Sam-Indyk/uatxcavators-tbm/fusion/UATXSync/resources/export/64x64@2x.png

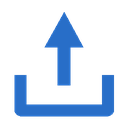
fusion/UATXSync/resources/export/64x64@2x.png
