Sam-Indyk/uatxcavators-tbm/fusion/UATXSync/resources/status/64x64@2x.png

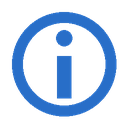
fusion/UATXSync/resources/status/64x64@2x.png
