Sam-Indyk/uatxcavators-tbm/fusion/UATXSync/resources/sync/64x64@2x.png

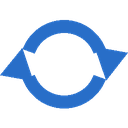
fusion/UATXSync/resources/sync/64x64@2x.png
