Sam-Indyk/uatxcavators-tbm/fusion/UATXSync/resources/toggle/64x64@2x.png

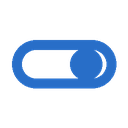
fusion/UATXSync/resources/toggle/64x64@2x.png
