Sam-Indyk/uatxcavators-tbm/out/fea/ring1_LC2_facewelded_R245_cb384x30_p76.2x63.5.png

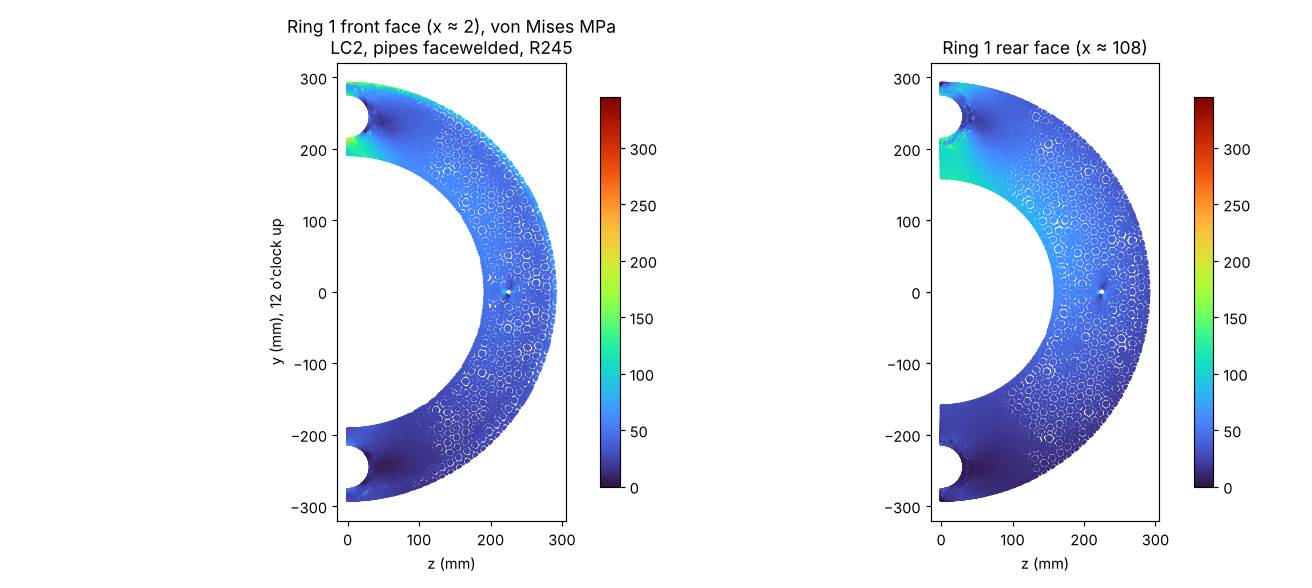
out/fea/ring1_LC2_facewelded_R245_cb384x30_p76.2x63.5.png
