Sam-Indyk/uatxcavators-tbm/out/fea/studies/tring_LC2_notch_casing.png

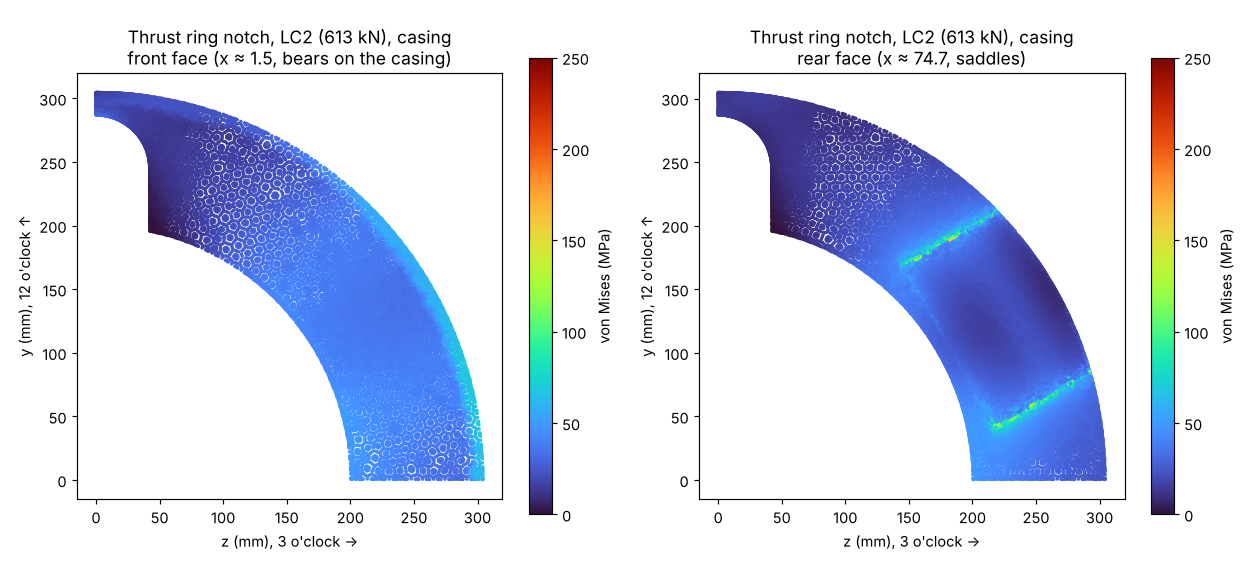
out/fea/studies/tring_LC2_notch_casing.png
