Sam-Indyk/uatxcavators-tbm/viewer/fea/ring1_LC2_facewelded_R245_cb384x30_p76.2x63.5_rear.png

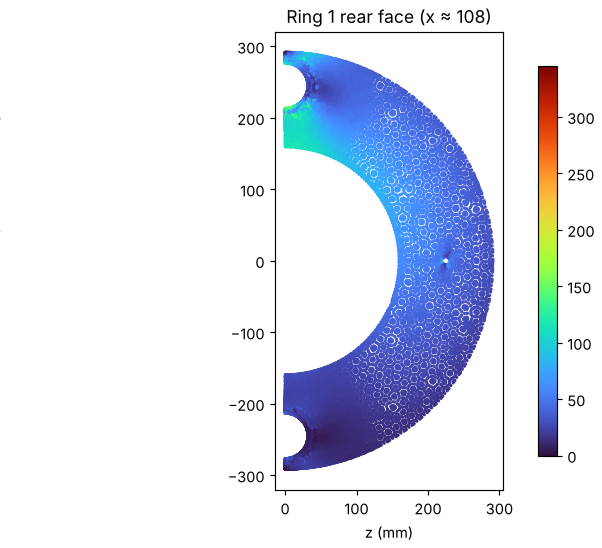
viewer/fea/ring1_LC2_facewelded_R245_cb384x30_p76.2x63.5_rear.png
