Sam-Indyk/uatxcavators-tbm/viewer/fea/tring_LC2_reg_casing_front.png

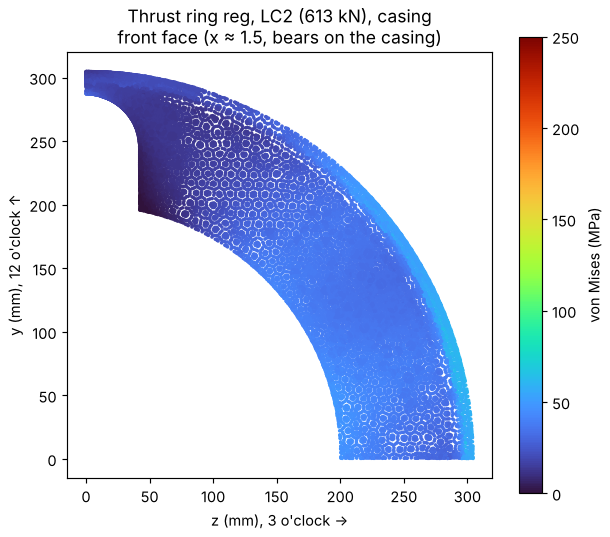
viewer/fea/tring_LC2_reg_casing_front.png
