Sam-Indyk/uatxcavators-tbm/docs/manual-09-bom.md

# Design manual Rev I · 09 Bill of materials

UATXcavators DN600 slurry microTBM (micro tunnel boring machine). Revision I, 2026-10-28. Generated by `tools/make_manual.py` from the model and calculation scripts in the repo; edit those, not this file.

Units mm, N, MPa (kN, kNm in tables). x = 0 at the ring 1 front face, +x rearward. Clock positions are seen from the front, looking rearward: 0° = 12 o'clock, 90° = 3 o'clock.

Every part in the Rev I model. Mass is the modelled total for the line (motor and cylinders at catalogue mass). Quantity '–' marks a line that is part of the item above it (bearing rings, seal lips, screws supplied with a locking assembly).

| # | Key | Group | Part | Qty | Material / supplier part | kg (line) | Make / buy |
|---|---|---|---|---|---|---|---|
| 1 | shell | Shell weldment | Shield shell Ø609.6 × 12.7 × 1285, rear Ø590.6 × 12 counterbore | 1 | 24 in × 0.500 in pipe, API 5L B / A53 B | 238.55 | make |
| 2 | ring1 | Shell weldment | Ring 1, 110 thk A572 Gr 42, Ø384 × 30 counterbore | 1 | A572 Gr 42, 4.5 in plate | 144.70 | make |
| 3 | weld | Shell weldment | Ring 1 weld, 14 mm fillet from the front | 1 | E7018 | 1.39 | weld |
| 4 | pipes | Shell weldment | Slurry pipes Ø76.2 × 6.35, 12 + 6, x = 0 to 1,255 | 2 | A1085 HSS 3.000 × 0.250 in | 27.46 | make |
| 5 | pipewelds | Shell weldment | Pipe welds: 6 × 45° front seal weld + 6 mm rear fillet | 4 | E7018 | 0.15 | weld |
| 6 | saddles | Shell weldment | Pipe saddles | 2 | A572 Gr 50 | 0.26 | make |
| 7 | taps | Shell weldment | Pressure-tap tubes, flush | 2 | Ø12 × 2 steel tube | 0.12 | make |
| 8 | fin30 | Shell weldment | Anti-roll fin 20 × 70 × 990 at 30° | 1 | A572 Gr 50, 20 plate | 9.81 | make |
| 9 | fin90 | Shell weldment | Anti-roll fin 20 × 70 × 990 at 90° | 1 | A572 Gr 50, 20 plate | 9.81 | make |
| 10 | fin270 | Shell weldment | Anti-roll fin 20 × 70 × 990 at 270° | 1 | A572 Gr 50, 20 plate | 9.81 | make |
| 11 | fin330 | Shell weldment | Anti-roll fin 20 × 70 × 990 at 330° | 1 | A572 Gr 50, 20 plate | 9.81 | make |
| 12 | finwelds | Shell weldment | Fin welds, 2 × 8 mm fillets | 8 | E7018 | 1.94 | weld |
| 13 | liftboss | Shell weldment | Lifting bosses ×4, Ø60 × 40, M20 (hoist rings) | 4 | A572 Gr 50 or 1018 bar Ø60 | 3.31 | make |
| 14 | liftplug | Shell weldment | Lifting-boss plugs ×4, M20 set screws | 4 | M20 set screw | 0.14 | buy |
| 15 | legs | Fixture | Gauge legs ×3, 1157 (fixture) | 3 | Tube Ø30, ground ends | 19.26 | fixture |
| 16 | risers | Fixture | Riser blocks ×3, 110 (fixture) | 3 | Steel block 60 × 60 | 9.33 | fixture |
| 17 | tube | Bearing module | Cartridge tube, seamless 323.9 × 60 | 1 | Seamless tube 323.9 × 60 E355 | 147.23 | make |
| 18 | halfA | Bearing module | Split flange half A | 1 | A572 Gr 50, 1.5 in plate | 4.03 | make |
| 19 | halfB | Bearing module | Split flange half B | 1 | A572 Gr 50, 1.5 in plate | 4.27 | make |
| 20 | splitscrews | Bearing module | Split-joint screws 2 × M8 | 2 | ISO 4762 M8 × 40 10.9 | 0.05 | buy |
| 21 | pin45 | Bearing module | Anti-rotation pin Ø12 at 45° | 1 | ISO 8734 Ø12 hardened | 0.04 | buy |
| 22 | pin135 | Bearing module | Anti-rotation pin Ø12 at 135° | 1 | ISO 8734 Ø12 hardened | 0.04 | buy |
| 23 | pin225 | Bearing module | Anti-rotation pin Ø12 at 225° | 1 | ISO 8734 Ø12 hardened | 0.04 | buy |
| 24 | pin315 | Bearing module | Anti-rotation pin Ø12 at 315° | 1 | ISO 8734 Ø12 hardened | 0.04 | buy |
| 25 | oring | Bearing module | Static O-ring on tube | 1 | NBR O-ring | 0.18 | buy |
| 26 | purge | Bearing module | Seal-purge line Ø8 in OD groove | 1 | Ø8 steel tube | 0.18 | make |
| 27 | purgefit | Bearing module | Purge line fittings (low profile) | 2 | Low-profile fittings | 0.02 | buy |
| 28 | flscrews | Bearing module | Flange screws 16 × M12 × 40 10.9 | 16 | ISO 4762 M12 × 40 10.9 | 0.87 | buy |
| 29 | fldowels | Bearing module | Dowels 2 × Ø16, flange to ring 1 | 2 | ISO 8734 Ø16 × 50 | 0.16 | buy |
| 30 | carrier | Bearing module | Seal carrier | 1 | S355 / 1045 | 9.88 | make |
| 31 | sealcase | Bearing module | Lip seals 170 × 200 × 15 ×3: steel case | 3 | SKF 170 × 200 × 15 | 0.86 | buy |
| 32 | seallip | Bearing module | Lip seals: NBR lips | – | (part of the seals) | 0.22 | – |
| 33 | sealspring | Bearing module | Lip seals: garter springs | – | (part of the seals) | 0.07 | – |
| 34 | lantern | Bearing module | Lantern rings ×2 | 2 | Steel | 0.87 | make |
| 35 | shim | Bearing module | Carrier shims | 1 | Shim set | 0.04 | make |
| 36 | carscrews | Bearing module | Carrier screws 12 × M6 countersunk | 12 | ISO 10642 M6 × 22 | 0.07 | buy |
| 37 | hw | Bearing module | 29328N housing washer | – | (29328N) | 3.15 | – |
| 38 | shaft | Bearing module | Spindle Ø140, 4140 QT | 1 | 4140 QT | 100.67 | make |
| 39 | f_ir | Bearing module | Front 23228: inner ring | 1 | 23228 CC/W33 (Koyo) | 4.78 | buy |
| 40 | f_or | Bearing module | Front 23228: outer ring | – | (23228) | 7.29 | – |
| 41 | f_rol | Bearing module | Front 23228: rollers 2 × 19 | – | (23228) | 4.04 | – |
| 42 | f_cage | Bearing module | Front 23228: cage rings + guide ring | – | (23228) | 0.61 | – |
| 43 | backing | Bearing module | Backing ring Ø190 | 1 | 4140 | 1.52 | make |
| 44 | sw | Bearing module | 29328N shaft washer | 1 | 29328N (Koyo) | 4.59 | buy |
| 45 | t_rol | Bearing module | 29328N rollers ×24 | – | (29328N) | 1.04 | – |
| 46 | spacer | Bearing module | Spacer sleeve | 1 | S355 | 9.01 | make |
| 47 | r_ir | Bearing module | Rear 23228: inner ring | 1 | 23228 CC/W33 (Koyo) | 4.78 | buy |
| 48 | r_or | Bearing module | Rear 23228: outer ring | – | (23228) | 7.29 | – |
| 49 | r_rol | Bearing module | Rear 23228: rollers 2 × 19 | – | (23228) | 4.04 | – |
| 50 | r_cage | Bearing module | Rear 23228: cage rings + guide ring | – | (23228) | 0.61 | – |
| 51 | mb | Bearing module | MB28 lock washer | 1 | SKF MB28 | 0.16 | buy |
| 52 | nut | Bearing module | KM28 lock nut | 1 | SKF KM28 | 2.46 | buy |
| 53 | eye | Fixture | M30 eye bolt in spindle nose (fixture) | 1 | DIN 580 M30 eye bolt | 1.07 | fixture |
| 54 | spider | Cutterhead | Spider plate 50.8, one waterjet piece | 1 | A572 Gr 50, 2 in plate | 47.84 | make |
| 55 | gussets | Cutterhead | Gussets ×8, 25 thk, tab-and-slot | 8 | A572 Gr 50, 1 in plate | 22.35 | make |
| 56 | hubring | Cutterhead | LA hub ring Ø340 × Ø190 × 50.8 | 1 | A572 Gr 50, 2 in plate | 24.51 | make |
| 57 | sleeve | Cutterhead | Journal sleeve Ø170 + labyrinth rings | 1 | 4140 prehardened bar Ø255 | 24.92 | make |
| 58 | headwelds | Cutterhead | Head welds (12 mm gusset-to-arm, 8 mm hub) | 1 | E7018 | 2.00 | weld |
| 59 | holders | Cutterhead | Bit holders ×17 (spider), 30 × 24 × 20 | 17 | Steel holder 30 × 24 × 20 | 1.90 | make |
| 60 | carbide | Cutterhead | Carbide drag bits ×17 (spider) | 17 | Carbide drag bit (Daniel's spec) | 0.71 | buy |
| 61 | la | Cutterhead | Locking assembly 140 × 190 × 50 | 1 | Fenner B-LOC B400 140 × 190 (B401140) | 4.53 | buy |
| 62 | lascrews | Cutterhead | Locking assembly screws 12 × M12 | – | (with the locking assembly) | 0.60 | – |
| 63 | cap | Cutterhead | Centre cap 30 thk + cone | 1 | A572 Gr 50, 1.25 in plate | 12.50 | make |
| 64 | capholders | Cutterhead | Bit holders ×7 (cap) | 7 | Steel holder | 0.78 | make |
| 65 | capcarbide | Cutterhead | Carbide drag bits ×7 (cap) | 7 | Carbide drag bit | 0.29 | buy |
| 66 | blades | Cutterhead | Centre cone carbide blades ×3 | 3 | Carbide blade | 0.05 | buy |
| 67 | capscrews | Cutterhead | Cap screws 8 × M8 countersunk | 8 | ISO 10642 M8 | 0.14 | buy |
| 68 | adapter | Drive | Drive adapter weldment (bell housing) | 1 | Weldment: A572 Gr 50 flanges + 14 in XS A106 B pipe | 44.25 | make |
| 69 | adwelds | Drive | Adapter welds | 1 | E7018 | 0.86 | weld |
| 70 | adscrews | Drive | Adapter screws 12 × M16 10.9 | 12 | ISO 4762 M16 × 50 10.9 | 1.48 | buy |
| 71 | addowels | Drive | Adapter dowels 3 × Ø16 | 3 | ISO 8734 Ø16 | 0.20 | buy |
| 72 | guards | Drive | Window guards ×2, 3 mm | 2 | 3 mm steel plate, rolled | 1.43 | make |
| 73 | guardscr | Drive | Guard screws 8 × M6 | 8 | ISO 4762 M6 × 12 | 0.05 | buy |
| 74 | gsupply | Drive | Seal-purge supply line, part 1 (R209) | 1 | Ø10 purge hose / tube | 0.34 | buy |
| 75 | gsupply2 | Drive | Seal-purge supply line, part 2 (to R185 and the surface) | – | (same line) | 0.26 | – |
| 76 | hub1 | Drive | ROTEX 160 hub, spindle side (steel, Ø180 bore) | 1 | KTR ROTEX 160 hub, steel, Ø180 H7 | 26.17 | buy |
| 77 | hub1la | Drive | B-LOC B400 130 × 180 locking assembly | 1 | Fenner B-LOC B400 130 × 180 (B401130) | 4.21 | buy |
| 78 | hub1scr | Drive | Hub locking-assembly screws 10 × M12 | – | (with the locking assembly) | 0.55 | – |
| 79 | elast | Drive | ROTEX 160 spider, 64 ShD | 1 | KTR ROTEX 160 spider 64 ShD | 0.54 | buy |
| 80 | hub2 | Drive | ROTEX 160 hub, motor side (W90 × 3 × 28 spline) | 1 | KTR ROTEX 160 hub, steel, W90 × 3 × 28 spline | 24.08 | buy |
| 81 | mshaft | Drive | Motor shaft W90 × 3 × 28 | – | (motor) | 4.91 | – |
| 82 | motor | Drive | Hydraulic motor, Poclain MS18 2,812 cc (body approximate) | 1 | Poclain MS18 2,812 cc, 2A50 shaft | 152.00 | buy |
| 83 | mbolts_r | Drive | Motor housing bolts | – | (motor) | 0.72 | – |
| 84 | mplate | Drive | Motor pilot plate Ø400 × 20 (Ø300 spigot, Ø282 recess) | 1 | A572 Gr 50, 1 in plate | 11.56 | make |
| 85 | mbolts | Drive | Motor screws 8 × M20 × 65 10.9 | 8 | ISO 4762 M20 × 65 10.9 | 1.98 | buy |
| 86 | hoses | Drive | Hoses A, B (3/4 in) + case drain | 3 | Hydraulic hoses 3/4 in ×2 + drain | 4.36 | buy |
| 87 | tring | Thrust ring | Thrust ring 76.2 thk A572-50, Ø609.6 × Ø400, Ø589.5 × 10 register, notched 12 + 6 (Rev B) | 1 | A572 Gr 50, 3.5 in plate (86.2 overall with the spigot) | 92.65 | make |
| 88 | tsaddles | Thrust ring | Saddle blocks ×4, 144 × 100 × 45.5, Ø65 seat | 4 | A572 Gr 50, 2 in | 16.52 | make |
| 89 | tears | Thrust ring | Saddle ears ×8, 20 × 80, R40, Ø39.5 slotted 3 | 8 | A572 Gr 50, 3/4 in plate | 3.80 | make |
| 90 | tsadwelds | Thrust ring | Saddle welds, 8 mm fillet (none past the ring OD) | 4 | E7018 | 0.32 | weld |
| 91 | tpin60 | Thrust ring | Saddle pin Ø38.1 × 160, 4140 HT, 2 o'clock | 1 | 4140 HT Ø38.1 × 160 + 2 clips | 1.43 | make |
| 92 | tpin120 | Thrust ring | Saddle pin Ø38.1 × 160, 4140 HT, 4 o'clock | 1 | 4140 HT Ø38.1 × 160 + 2 clips | 1.43 | make |
| 93 | tpin240 | Thrust ring | Saddle pin Ø38.1 × 160, 4140 HT, 8 o'clock | 1 | 4140 HT Ø38.1 × 160 + 2 clips | 1.43 | make |
| 94 | tpin300 | Thrust ring | Saddle pin Ø38.1 × 160, 4140 HT, 10 o'clock | 1 | 4140 HT Ø38.1 × 160 + 2 clips | 1.43 | make |
| 95 | jcyl | Jacking cylinders | Chief WT 5 × 24 ×4, retracted 889 (envelope) | 4 | Chief WT 5 × 24, Bailey SKU 216207 | 210.40 | buy |
