Sam-Indyk/uatxcavators-tbm/out/step/parts/guards.step

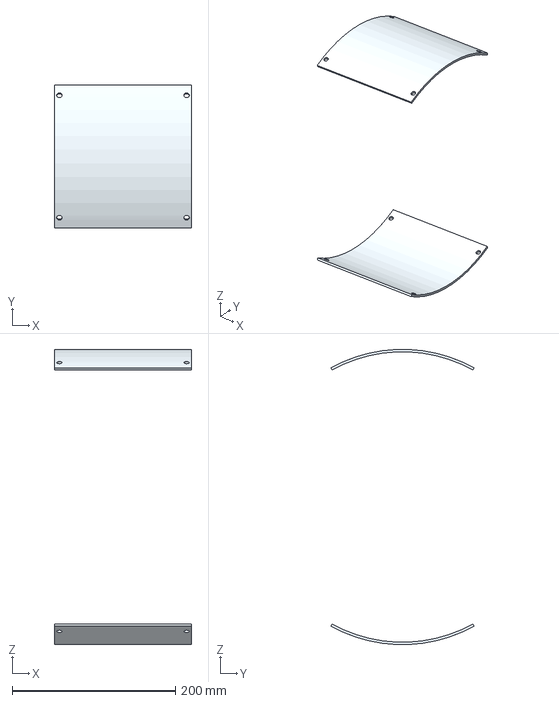
[picture p10: CAD file, 2026-10-29]
out/step/parts/guards.step
168.0 x 175.5 x 361.6 mm
