Sam-Indyk/uatxcavators-tbm/out/step/thrust_ring_revB.step

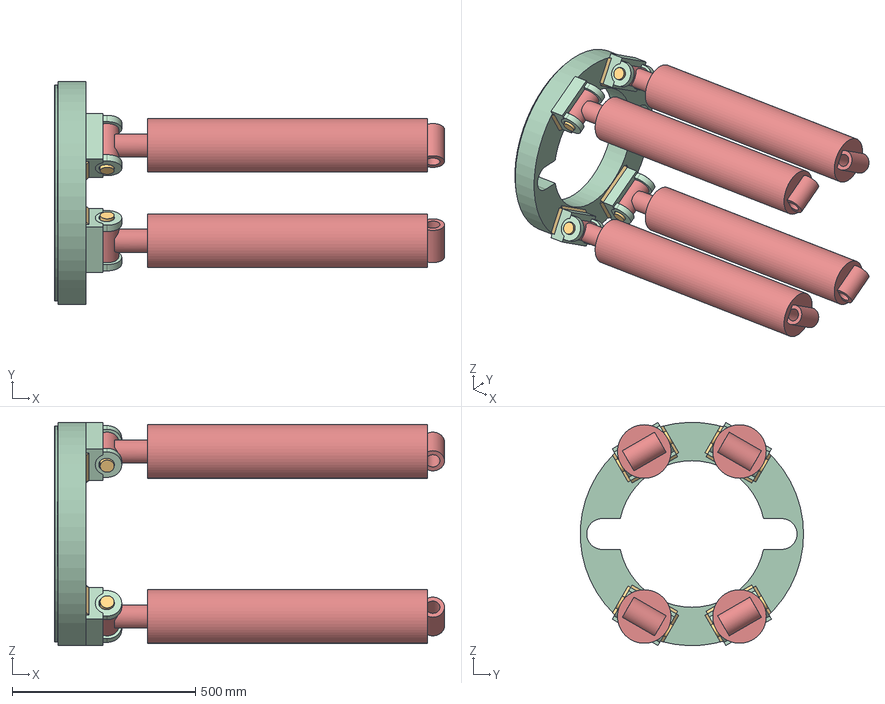
[picture p11: CAD file, 2026-10-29]
out/step/thrust_ring_revB.step
1064.4 x 609.0 x 609.3 mm
Thrust_ring_76_2_thk_A572_50__D609_6_x_D400__D589_5_x_10_register__ notched_12___6__Rev_B_
Saddle_blocks_x4__144_x_100_x_45_5__D65_seat
Saddle_ears_x8__20_x_80__R40__D39_5_slotted_3
Saddle_welds__8_mm_fillet__none_past_the_ring_OD_
Saddle_pin_D38_1_x_160__4140_HT__2_o_clock
Saddle_pin_D38_1_x_160__4140_HT__4_o_clock
Saddle_pin_D38_1_x_160__4140_HT__8_o_clock
Saddle_pin_D38_1_x_160__4140_HT__10_o_clock
Chief_WT_5_x_24_x4__retracted_889__envelope_
