Sam-Indyk/uatxcavators-tbm/out/step/parts/hub1.step

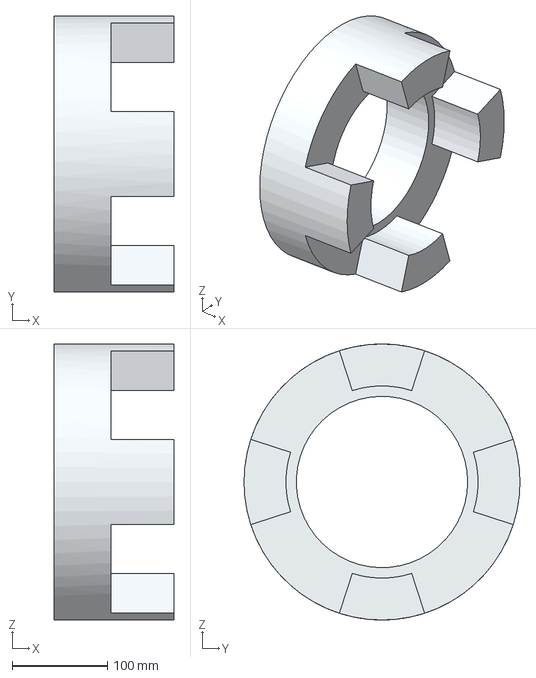
[picture p12: CAD file, 2026-10-29]
out/step/parts/hub1.step
126.0 x 290.0 x 290.0 mm
