Sam-Indyk/uatxcavators-tbm/out/step/spindle_mount_revI_detail.step

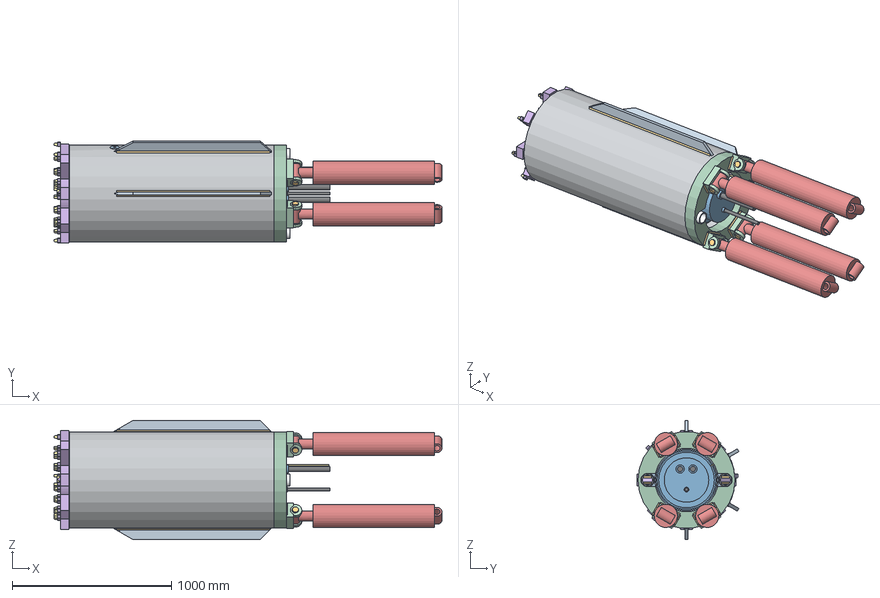
[picture p13: CAD file, 2026-10-29]
out/step/spindle_mount_revI_detail.step
2437.0 x 640.5 x 749.6 mm
Shield_shell_D609_6_x_12_7_x_1285__rear_D590_6_x_12_counterbore
Ring_1__110_thk_A572_Gr_42__D384_x_30_counterbore
Ring_1_weld__14_mm_fillet_from_the_front
Slurry_pipes_D76_2_x_6_35__12___6__x___0_to_1_255
Pipe_welds__6_x_45__front_seal_weld___6_mm_rear_fillet
Pipe_saddles
Pressure_tap_tubes__flush
Anti_roll_fin_20_x_70_x_990_at_30_
Anti_roll_fin_20_x_70_x_990_at_90_
Anti_roll_fin_20_x_70_x_990_at_270_
Anti_roll_fin_20_x_70_x_990_at_330_
Fin_welds__2_x_8_mm_fillets
Lifting_bosses_x4__D60_x_40__M20__hoist_rings_
Lifting_boss_plugs_x4__M20_set_screws
Cartridge_tube__seamless_323_9_x_60
Split_flange_half_A
Split_flange_half_B
Split_joint_screws_2_x_M8
Anti_rotation_pin_D12_at_45_
Anti_rotation_pin_D12_at_135_
Anti_rotation_pin_D12_at_225_
Anti_rotation_pin_D12_at_315_
Static_O_ring_on_tube
Seal_purge_line_D8_in_OD_groove
Purge_line_fittings__low_profile_
Flange_screws_16_x_M12_x_40_10_9
Dowels_2_x_D16__flange_to_ring_1
Seal_carrier
Lip_seals_170_x_200_x_15_x3__steel_case
Lip_seals__NBR_lips
Lip_seals__garter_springs
Lantern_rings_x2
Carrier_shims
Carrier_screws_12_x_M6_countersunk
29328N_housing_washer
Spindle_D140__4140_QT
Front_23228__inner_ring
Front_23228__outer_ring
Front_23228__rollers_2_x_19
Front_23228__cage_rings___guide_ring
Backing_ring_D190
29328N_shaft_washer
29328N_rollers_x24
Spacer_sleeve
Rear_23228__inner_ring
Rear_23228__outer_ring
Rear_23228__rollers_2_x_19
Rear_23228__cage_rings___guide_ring
MB28_lock_washer
KM28_lock_nut
Spider_plate_50_8__one_waterjet_piece
Gussets_x8__25_thk__tab_and_slot
LA_hub_ring_D340_x_D190_x_50_8
Journal_sleeve_D170___labyrinth_rings
Head_welds__12_mm_gusset_to_arm__8_mm_hub_
Bit_holders_x17__spider___30_x_24_x_20
Carbide_drag_bits_x17__spider_
Locking_assembly_140_x_190_x_50
Locking_assembly_screws_12_x_M12
Centre_cap_30_thk___cone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
