Sam-Indyk/uatxcavators-tbm/out/step/parts/liftplug.step

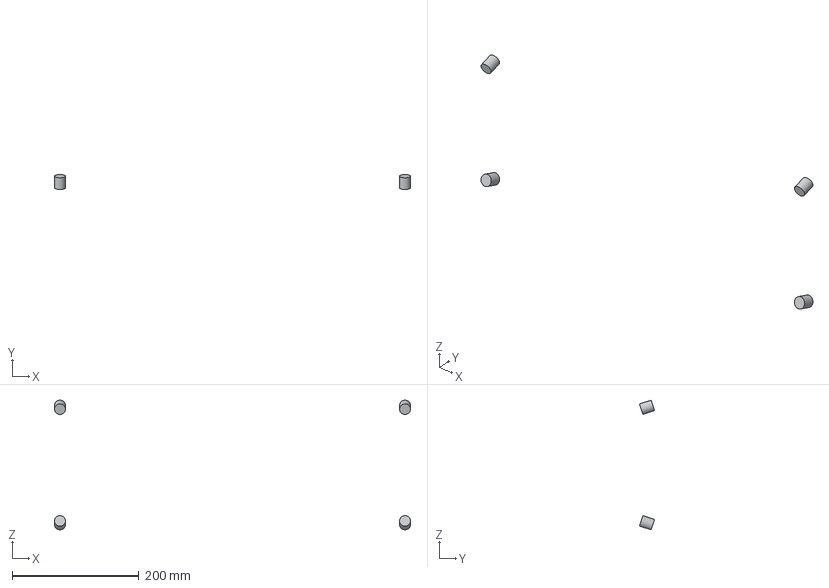
[picture p14: CAD file, 2026-10-29]
out/step/parts/liftplug.step
561.3 x 23.9 x 204.5 mm
