Sam-Indyk/uatxcavators-tbm/out/step/parts/seallip.step

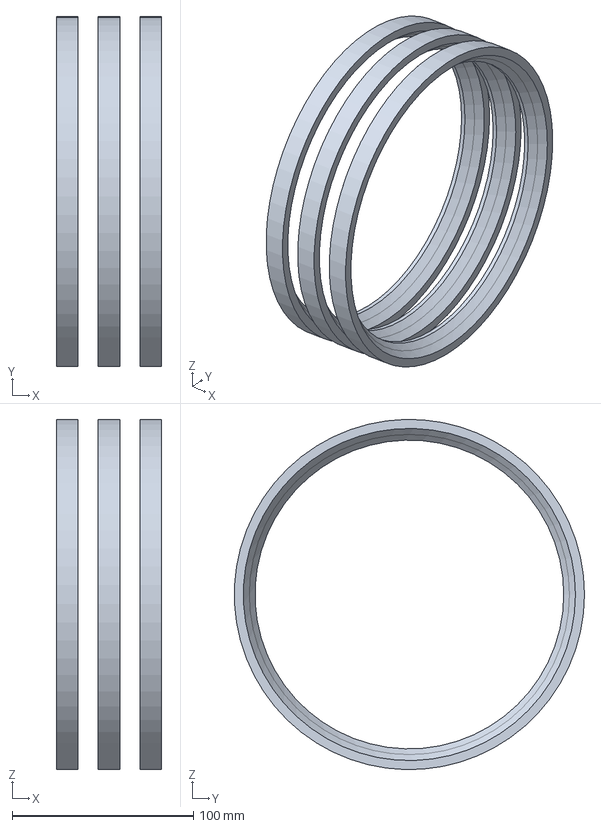
[picture p15: CAD file, 2026-10-29]
out/step/parts/seallip.step
57.9 x 193.1 x 193.1 mm
