Sam-Indyk/uatxcavators-tbm/out/step/parts/tsadwelds.step

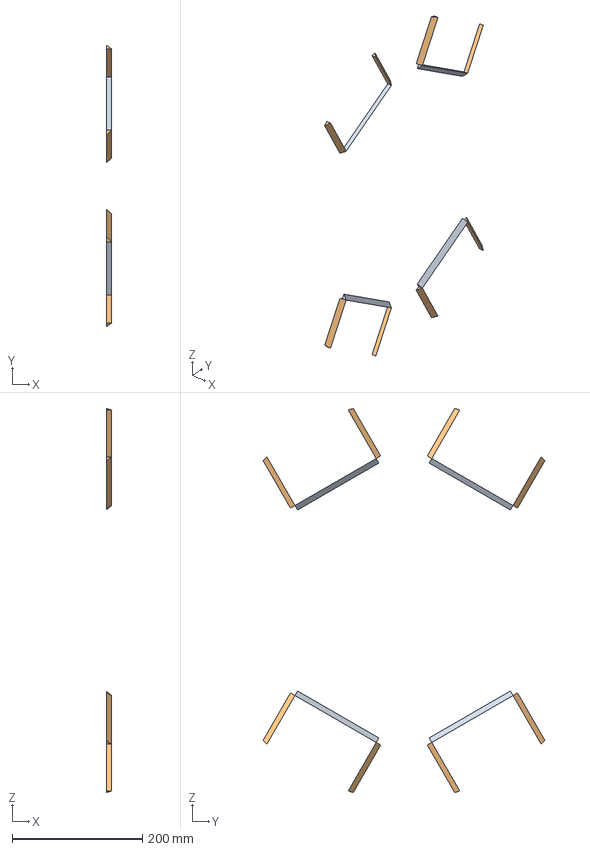
[picture p16: CAD file, 2026-10-29]
out/step/parts/tsadwelds.step
8.00 x 432.7 x 589.4 mm
