Sam-Indyk/uatxcavators-tbm/out/step/spindle_mount_revH.step

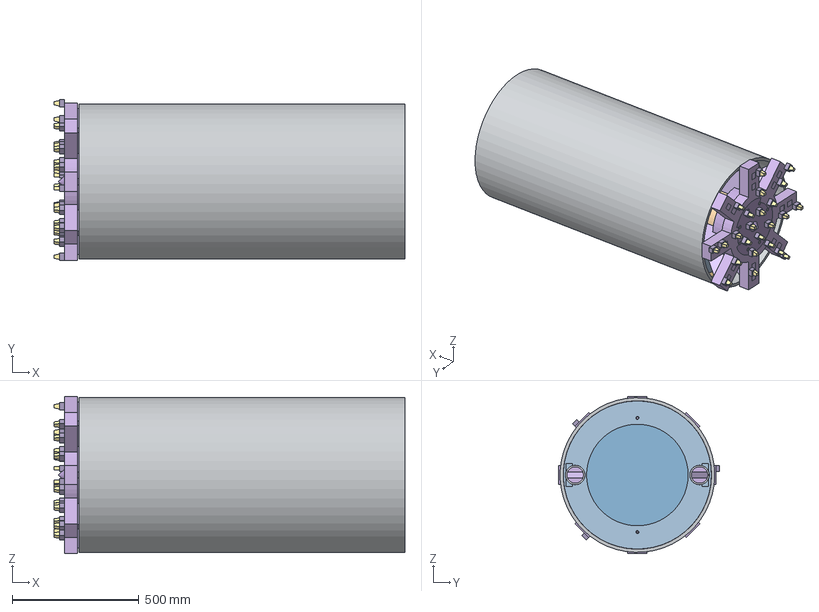
[picture p17: CAD file, 2026-10-27]
out/step/spindle_mount_revH.step
1382.8 x 634.6 x 620.0 mm
Shield_shell__1285_
Ring_1__110_thk__Ã400___35_counterbore__Ã318_5_bore
Ring_1_weld__14_mm_front_fillet
Slurry_pipes__flush_at_plate__R245__12___6
Pipe_saddles
Pressure_tap_tubes__flush
Cartridge__seamless_tube_323_9___60__no_weld
Split_flange__2_halves_in_tube_groove
Split_joint_screws_2___M10
Anti_rotation_pins_4___Ã16__flange_to_tube
Flange_screws_16___M12__recessed
Dowels_2___Ã16__flange_to_ring_1
Static_O_ring__tube_in_ring_1_bore
Grease_fittings__4__behind_ring_1_
Seal_carrier__flush_
Lip_seals__3
Grease_lantern_rings__2
Carrier_shims
Carrier_screws_12___M6_CSK
29328N_housing_washer
Spindle_Ã140__plain_ends
Front_23228
Backing_ring_Ã190__29328_da_min_185_
29328N_shaft_washer___rollers
Spacer_sleeve
Rear_23228
Rear_KM28_nut
Spider_plate_50_8__one_waterjet_piece
Gussets__8__25_thk__tab_and_slot
LA_hub_ring_50_8__Ã340___Ã190_
Journal_sleeve_Ã170__seal_running_surface_
Locking_assembly_140___190___50
Bit_holders__24
Trapezoid_carbide_drag_bits__24
Centre_cap_30_thk___cone__removable_
Cap_screws_8___M8_CSK
Drive_envelope_Ã400__motor_TBD_
Drive_screws_12___M16
Dowels_3___Ã16__drive_to_cartridge
