Sam-Indyk/uatxcavators-tbm/out/step/parts/fldowels.step

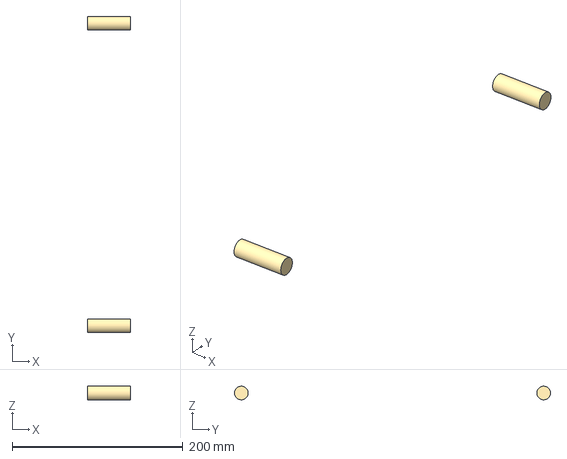
[picture p18: CAD file, 2026-10-29]
out/step/parts/fldowels.step
50.0 x 370.0 x 16.0 mm
