Sam-Indyk/uatxcavators-tbm/out/step/parts/tsaddles.step

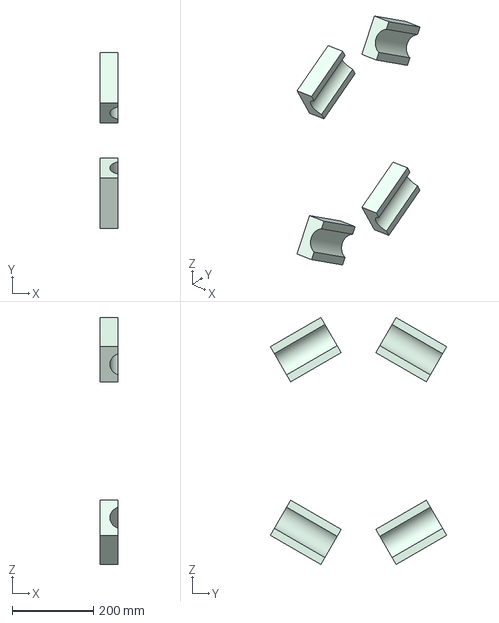
[picture p19: CAD file, 2026-10-29]
out/step/parts/tsaddles.step
45.5 x 434.7 x 608.9 mm
