Sam-Indyk/uatxcavators-tbm/out/step/parts/holders.step

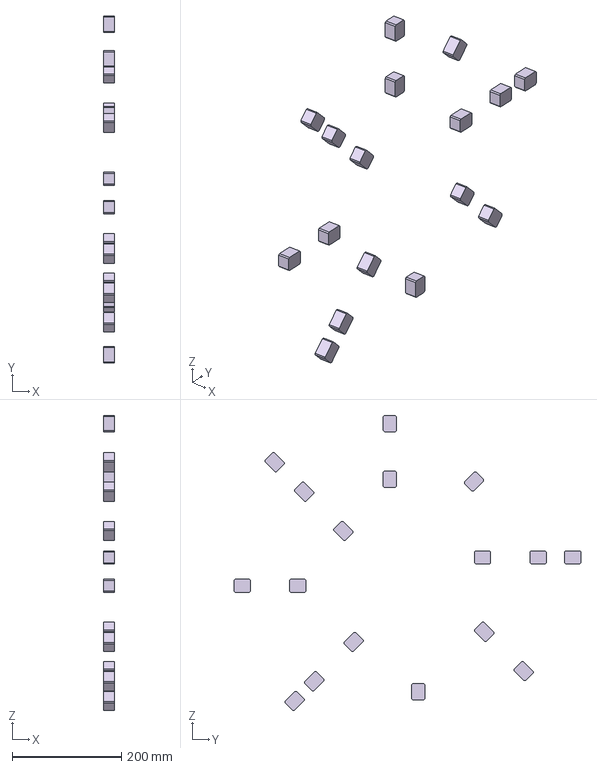
[picture p20: CAD file, 2026-10-29]
out/step/parts/holders.step
20.0 x 634.6 x 539.9 mm
