Sam-Indyk/uatxcavators-tbm/out/step/parts/tpin120.step

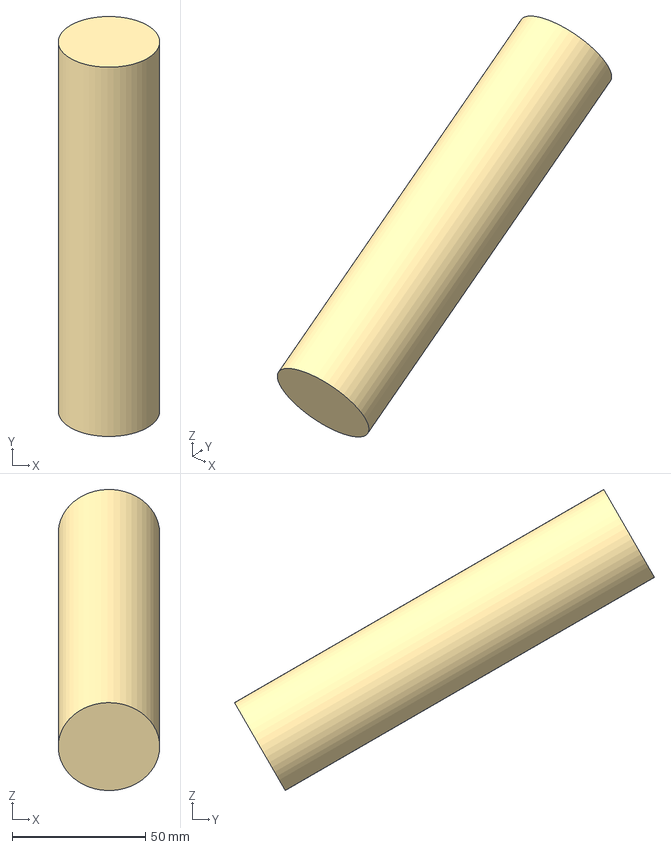
[picture p21: CAD file, 2026-10-29]
out/step/parts/tpin120.step
38.1 x 157.6 x 113.0 mm
