Sam-Indyk/uatxcavators-tbm/out/step/parts/f_cage.step

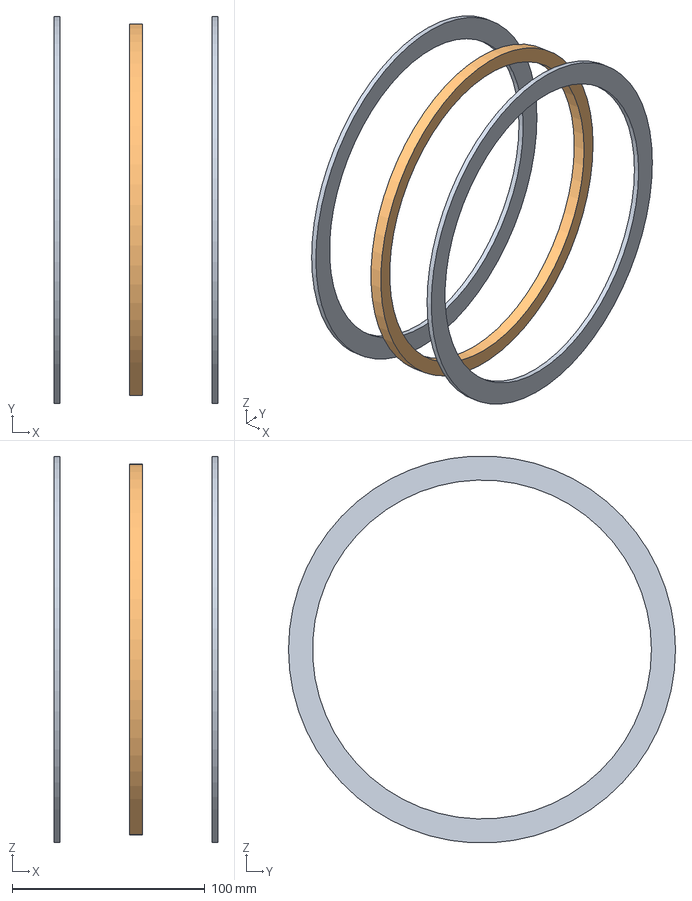
[picture p22: CAD file, 2026-10-29]
out/step/parts/f_cage.step
85.0 x 201.0 x 200.7 mm
