Sam-Indyk/uatxcavators-tbm/out/step/parts/halfB.step

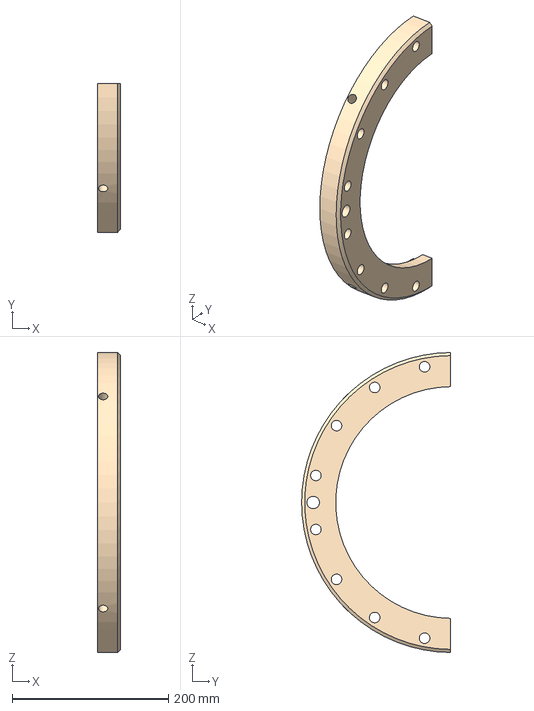
[picture p23: CAD file, 2026-10-29]
out/step/parts/halfB.step
30.0 x 190.4 x 383.8 mm
