Sam-Indyk/uatxcavators-tbm/out/step/parts/sleeve.step

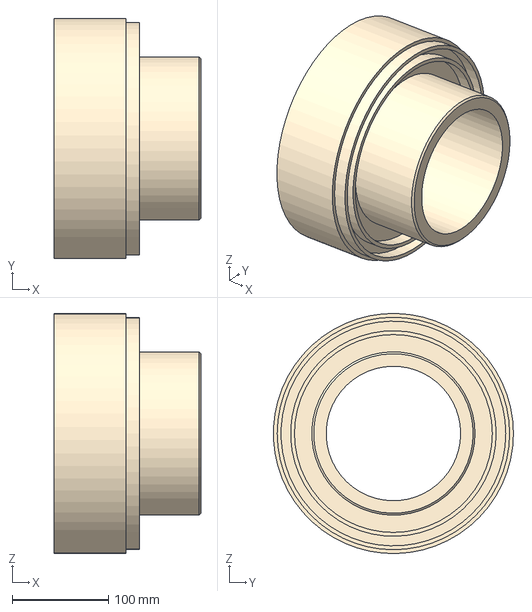
[picture p24: CAD file, 2026-10-29]
out/step/parts/sleeve.step
153.0 x 249.8 x 249.9 mm
