Sam-Indyk/uatxcavators-tbm/out/step/parts/cap.step

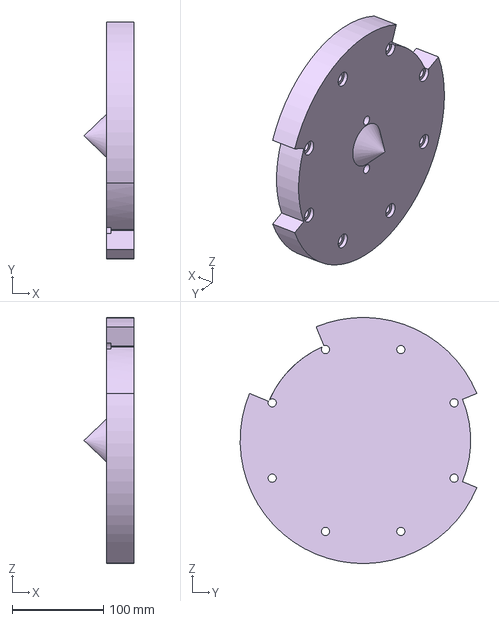
[picture p25: CAD file, 2026-10-29]
out/step/parts/cap.step
55.0 x 259.7 x 269.9 mm
