Sam-Indyk/uatxcavators-tbm/out/step/parts/oring.step

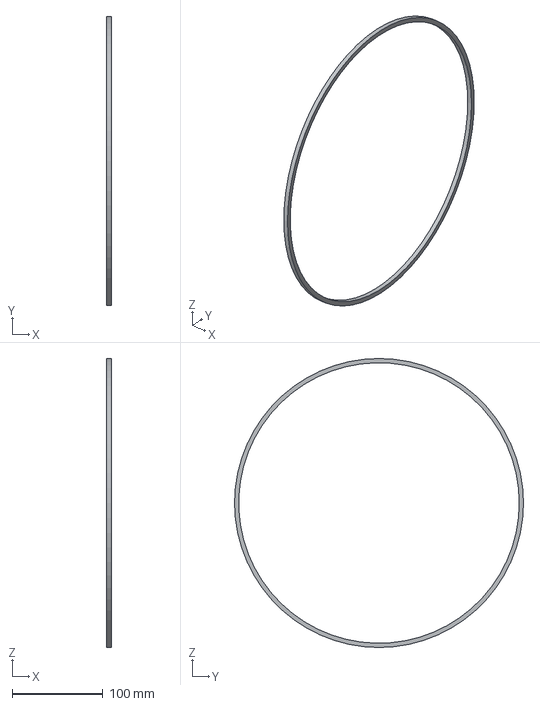
[picture p26: CAD file, 2026-10-29]
out/step/parts/oring.step
5.00 x 318.4 x 318.4 mm
