Sam-Indyk/uatxcavators-tbm/out/step/parts/spider.step

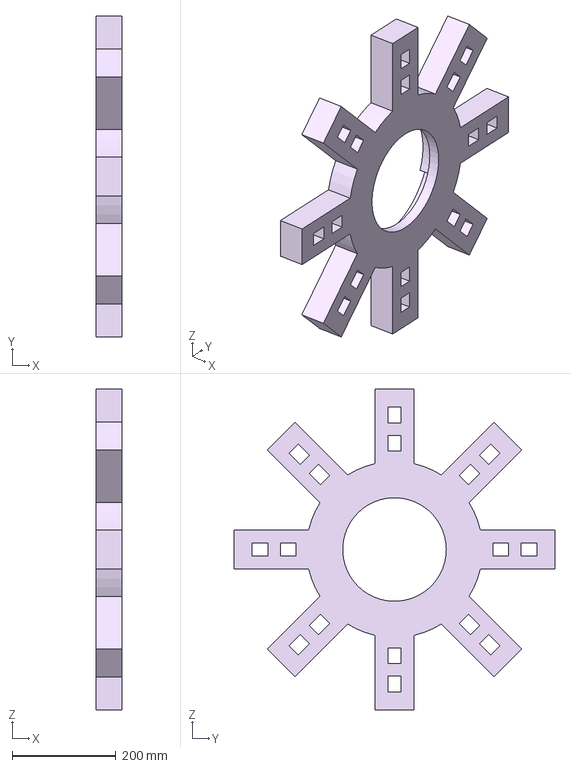
[picture p27: CAD file, 2026-10-29]
out/step/parts/spider.step
50.8 x 620.0 x 620.0 mm
