Sam-Indyk/uatxcavators-tbm/out/step/parts/r_or.step

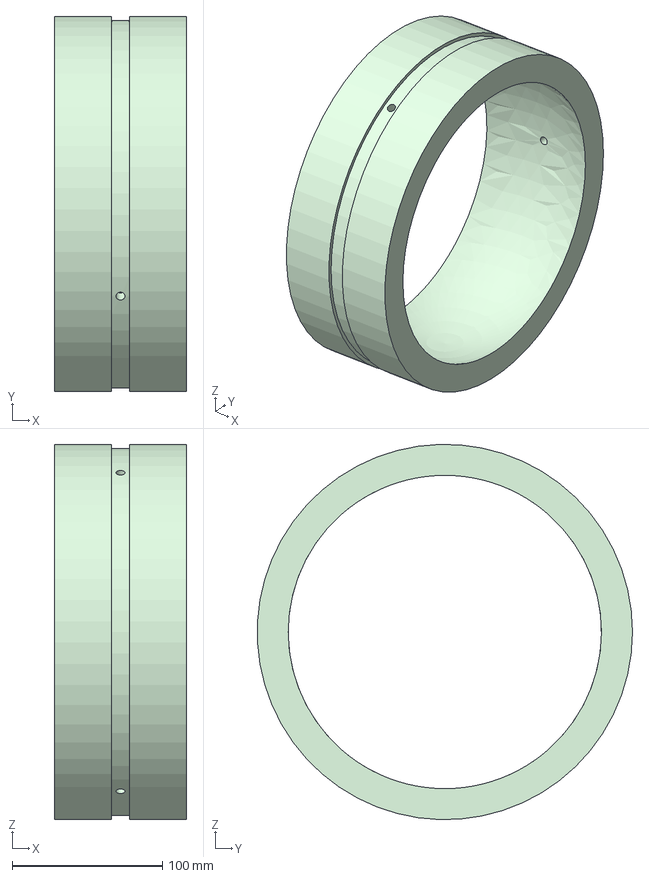
[picture p28: CAD file, 2026-10-29]
out/step/parts/r_or.step
88.0 x 249.8 x 249.9 mm
