Sam-Indyk/uatxcavators-tbm/out/step/parts/legs.step

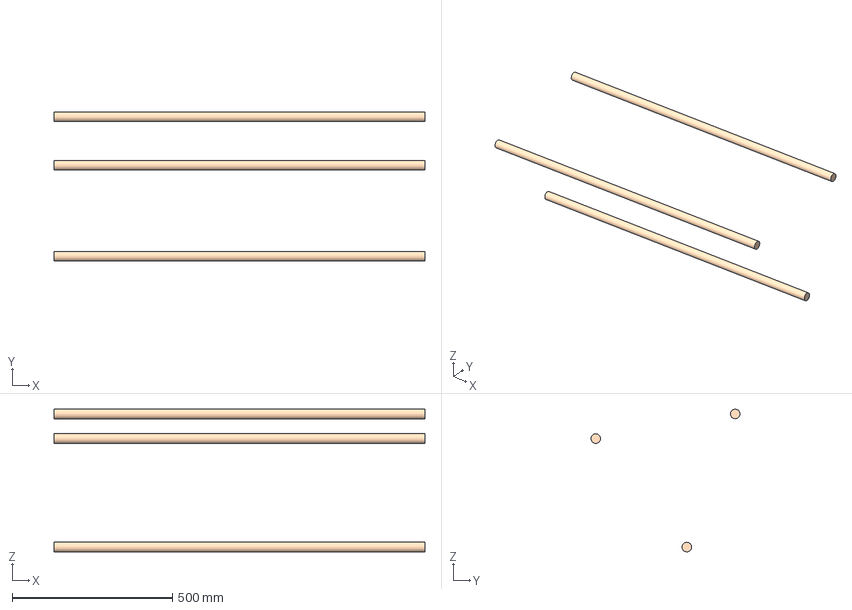
[picture p29: CAD file, 2026-10-29]
out/step/parts/legs.step
1157.0 x 464.9 x 445.0 mm
