Sam-Indyk/uatxcavators-tbm/out/step/parts/pin45.step

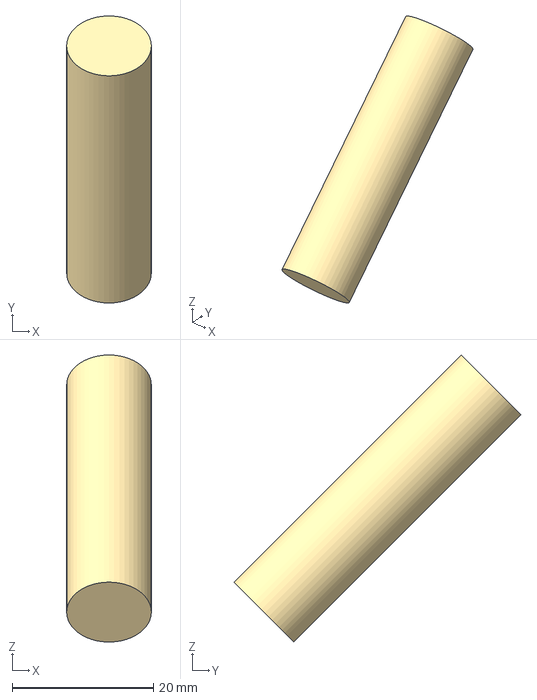
[picture p30: CAD file, 2026-10-29]
out/step/parts/pin45.step
12.0 x 40.7 x 40.7 mm
