Sam-Indyk/uatxcavators-tbm/out/step/parts/liftboss.step

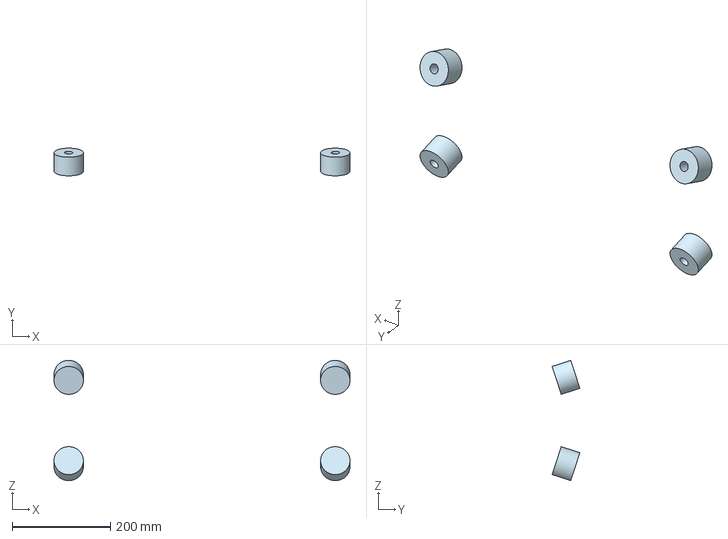
[picture p31: CAD file, 2026-10-29]
out/step/parts/liftboss.step
604.0 x 56.6 x 245.4 mm
