Sam-Indyk/uatxcavators-tbm/out/step/parts/risers.step

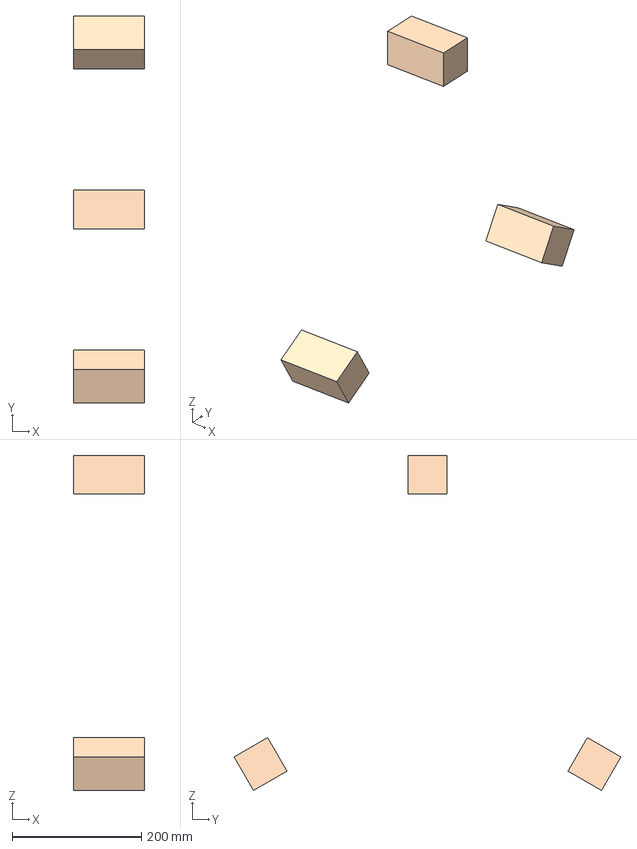
[picture p32: CAD file, 2026-10-29]
out/step/parts/risers.step
110.0 x 599.0 x 518.7 mm
