Sam-Indyk/uatxcavators-tbm/out/step/parts/sealcase.step

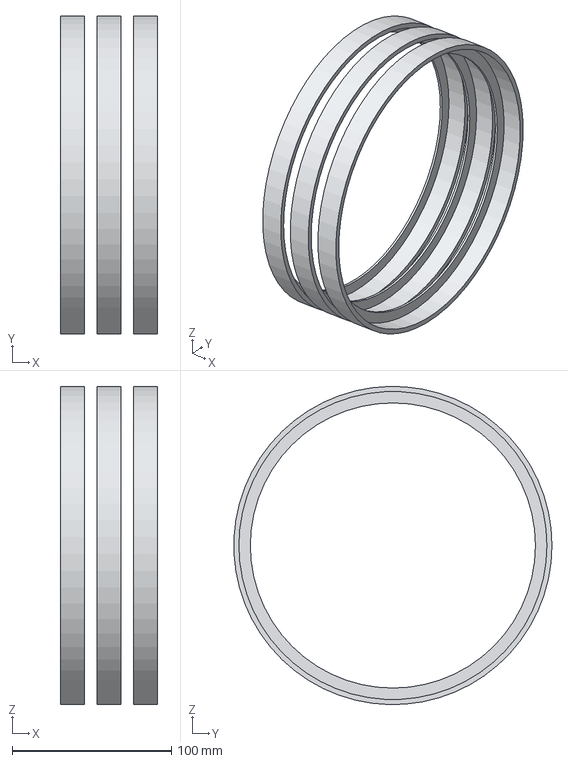
[picture p33: CAD file, 2026-10-29]
out/step/parts/sealcase.step
61.0 x 199.9 x 199.9 mm
