Sam-Indyk/uatxcavators-tbm/out/step/parts/shaft.step

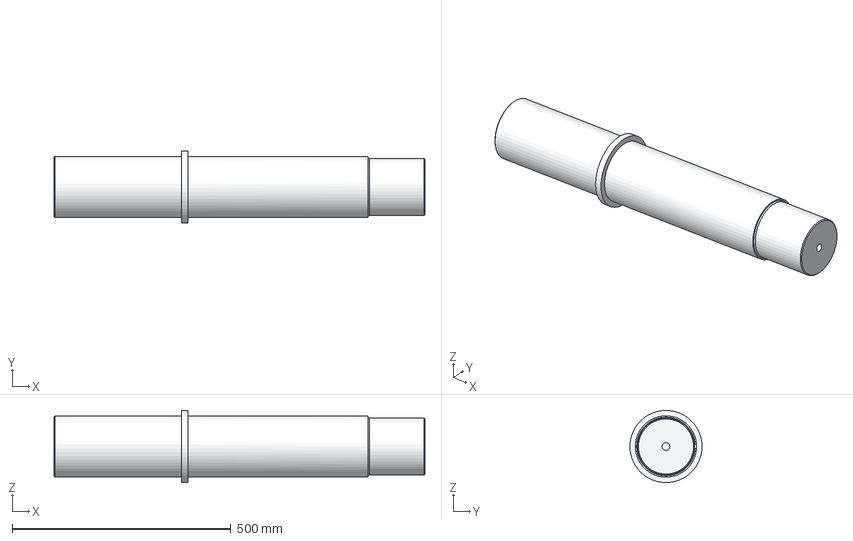
[picture p34: CAD file, 2026-10-29]
out/step/parts/shaft.step
848.0 x 164.8 x 164.9 mm
