Sam-Indyk/uatxcavators-tbm/out/step/parts/hubring.step

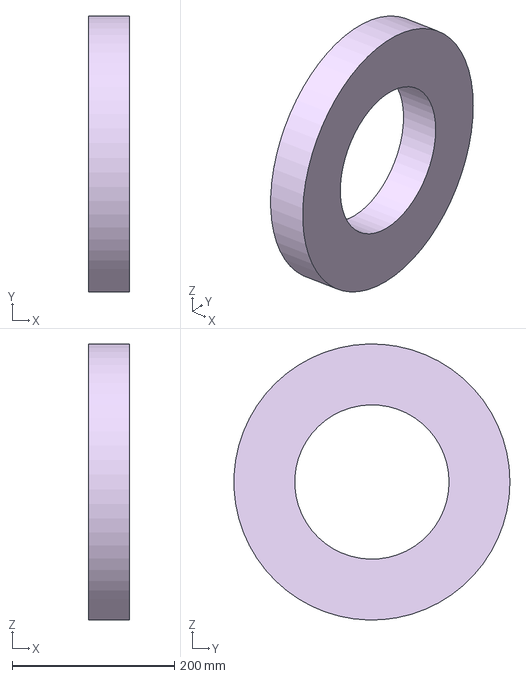
[picture p35: CAD file, 2026-10-29]
out/step/parts/hubring.step
50.0 x 339.8 x 339.9 mm
