Sam-Indyk/uatxcavators-tbm/out/step/parts/t_rol.step

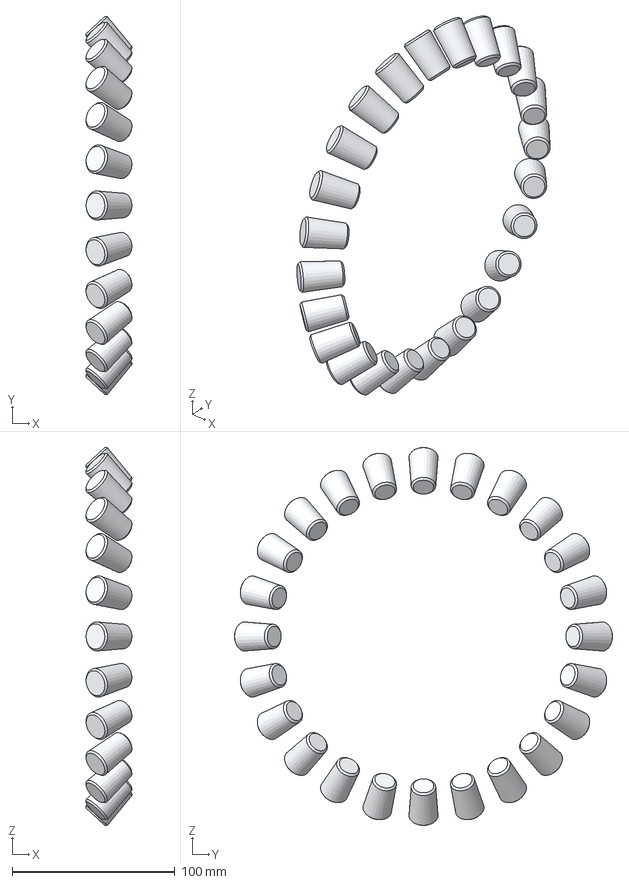
[picture p36: CAD file, 2026-10-29]
out/step/parts/t_rol.step
28.1 x 232.3 x 232.3 mm
