Sam-Indyk/uatxcavators-tbm/out/step/parts/lantern.step

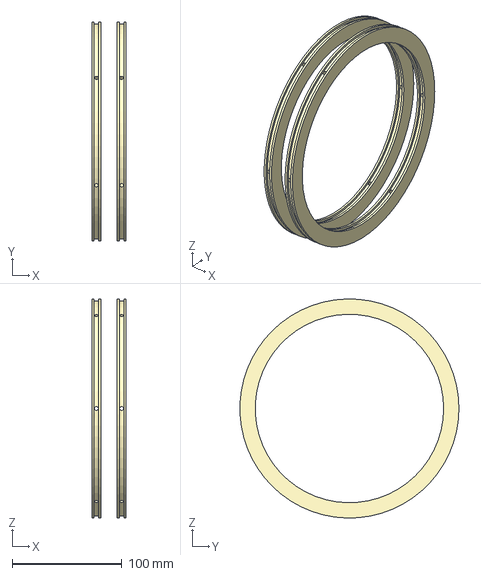
[picture p37: CAD file, 2026-10-29]
out/step/parts/lantern.step
31.0 x 199.9 x 199.9 mm
