Sam-Indyk/uatxcavators-tbm/out/step/parts/purgefit.step

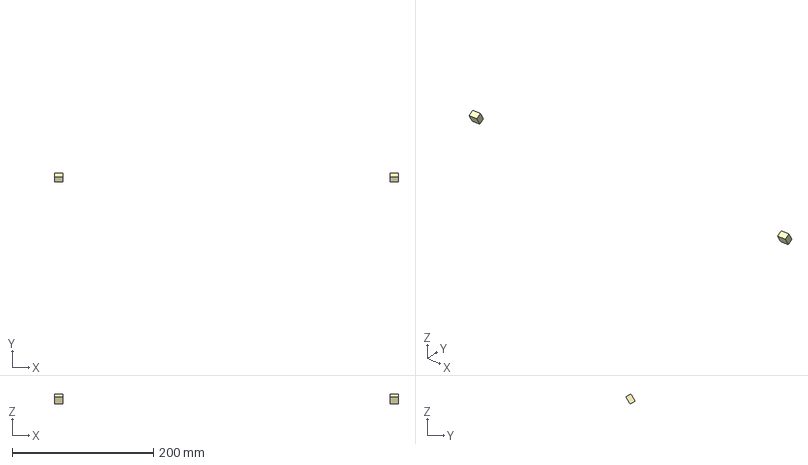
[picture p38: CAD file, 2026-10-29]
out/step/parts/purgefit.step
487.0 x 13.3 x 14.6 mm
