Sam-Indyk/uatxcavators-tbm/out/step/parts/jcyl.step

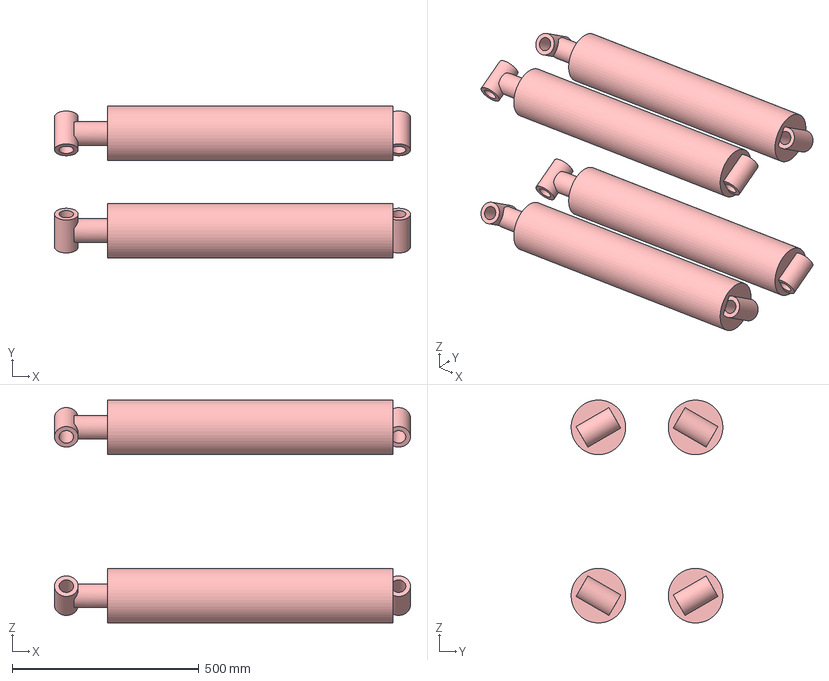
[picture p39: CAD file, 2026-10-29]
out/step/parts/jcyl.step
952.4 x 406.0 x 596.4 mm
