Sam-Indyk/uatxcavators-tbm/out/step/parts/spacer.step

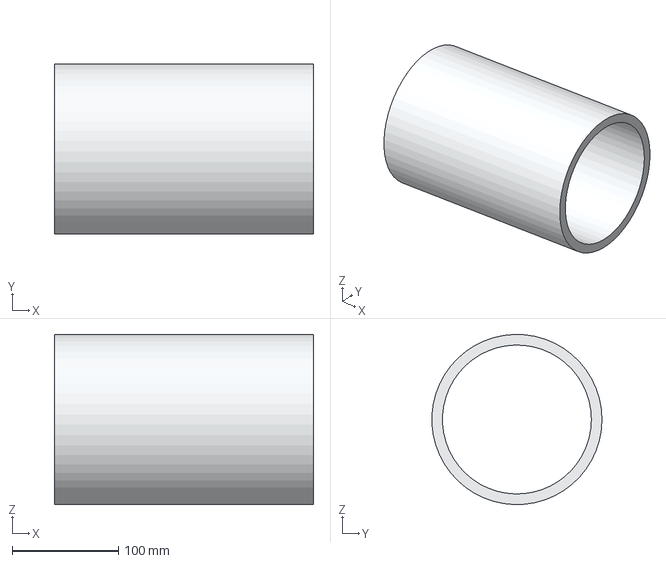
[picture p40: CAD file, 2026-10-29]
out/step/parts/spacer.step
243.5 x 159.8 x 159.9 mm
