Sam-Indyk/uatxcavators-tbm/out/step/parts/finwelds.step

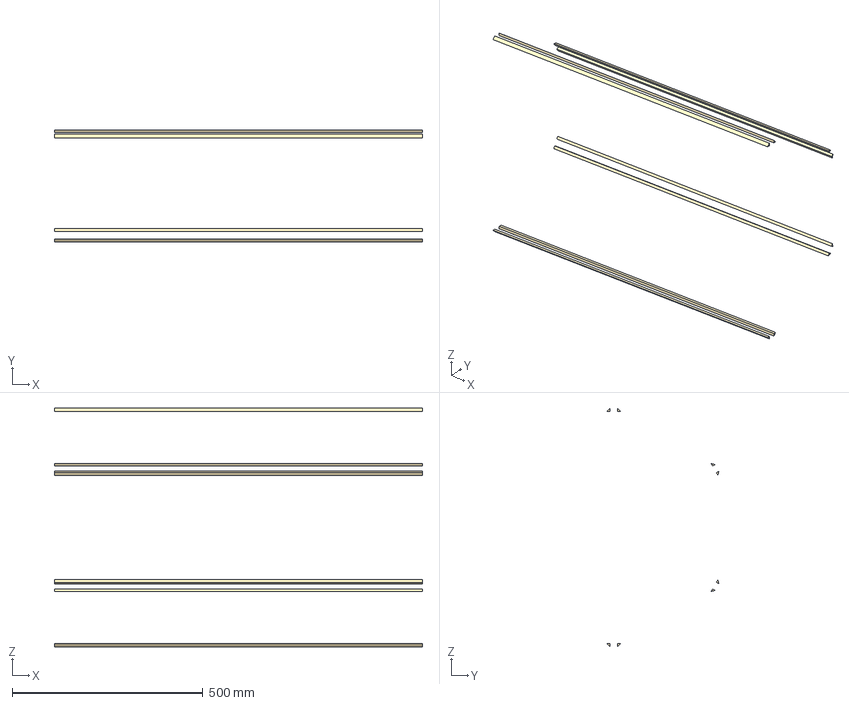
[picture p41: CAD file, 2026-10-29]
out/step/parts/finwelds.step
965.0 x 293.9 x 625.6 mm
