Sam-Indyk/uatxcavators-tbm/out/step/parts/hub1scr.step

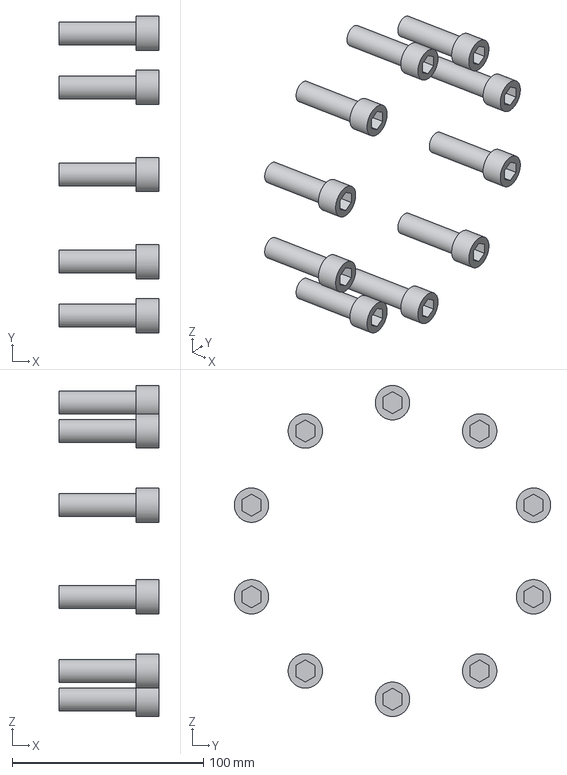
[picture p42: CAD file, 2026-10-29]
out/step/parts/hub1scr.step
52.0 x 165.4 x 173.0 mm
