Sam-Indyk/uatxcavators-tbm/out/step/parts/headwelds.step

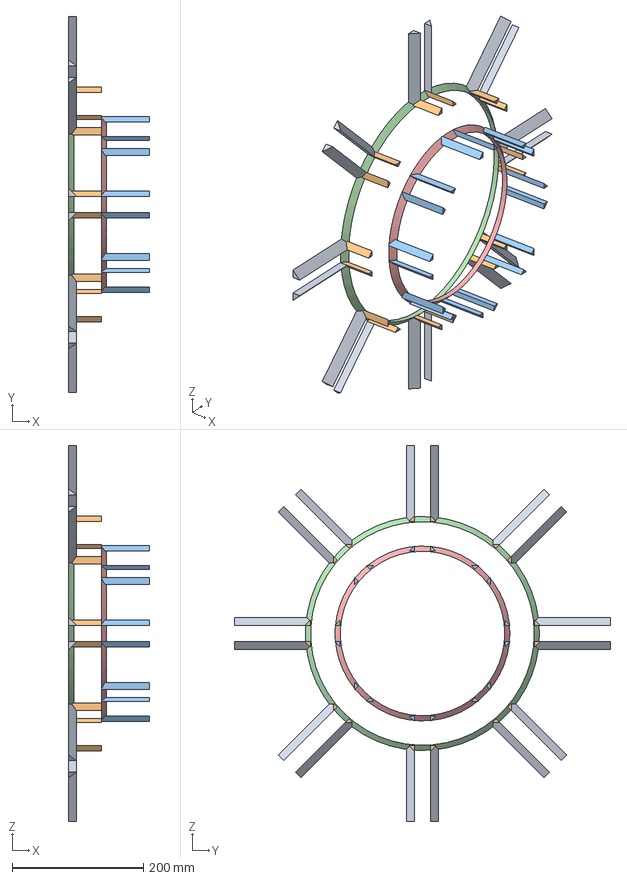
[picture p43: CAD file, 2026-10-29]
out/step/parts/headwelds.step
123.0 x 572.0 x 572.0 mm
