Sam-Indyk/uatxcavators-tbm/out/step/parts/ring1.step

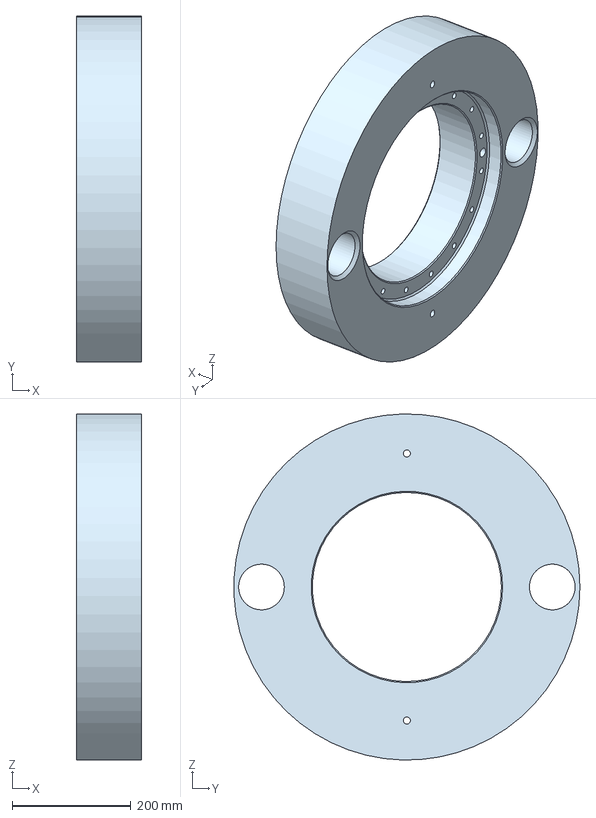
[picture p44: CAD file, 2026-10-29]
out/step/parts/ring1.step
110.0 x 582.8 x 583.0 mm
