Sam-Indyk/uatxcavators-tbm/out/step/parts/hub2.step

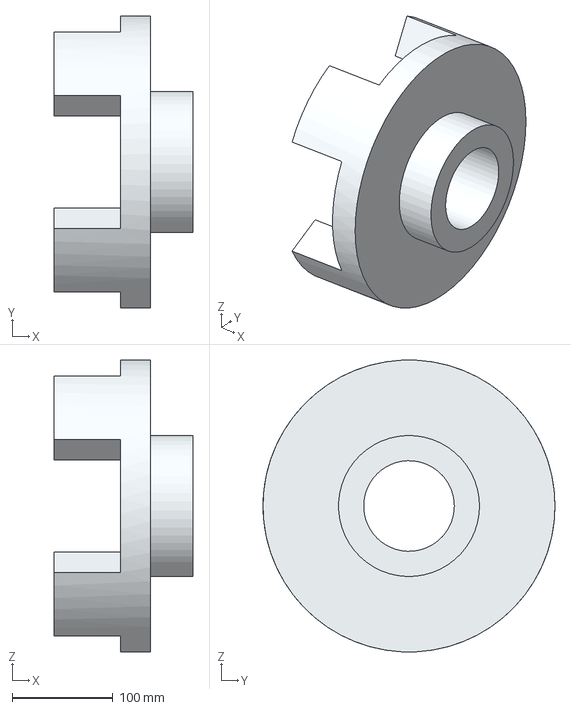
[picture p45: CAD file, 2026-10-29]
out/step/parts/hub2.step
138.0 x 290.0 x 289.6 mm
