Sam-Indyk/uatxcavators-tbm/out/step/parts/weld.step

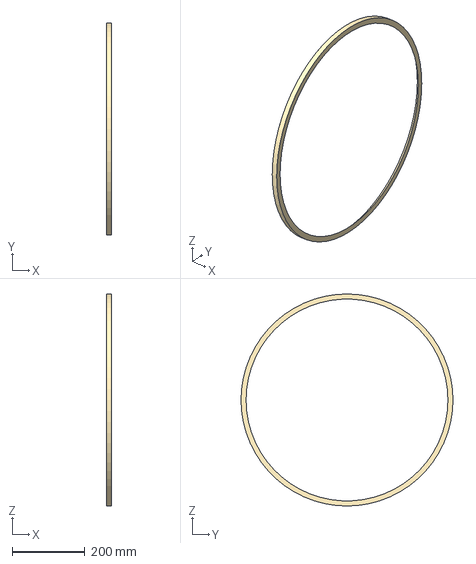
[picture p46: CAD file, 2026-10-29]
out/step/parts/weld.step
14.0 x 584.2 x 584.2 mm
