Sam-Indyk/uatxcavators-tbm/out/step/parts/backing.step

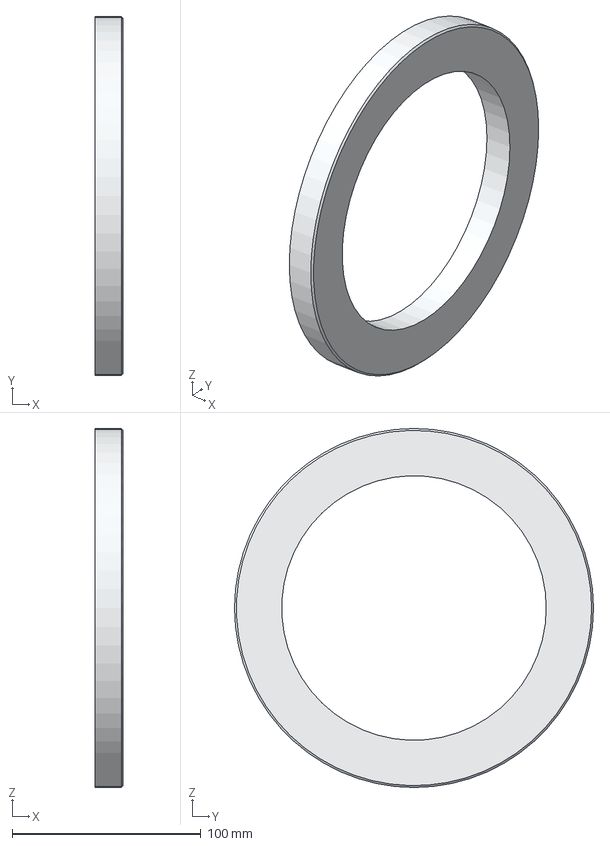
[picture p47: CAD file, 2026-10-29]
out/step/parts/backing.step
15.0 x 190.0 x 190.0 mm
