Sam-Indyk/uatxcavators-tbm/out/step/parts/mb.step

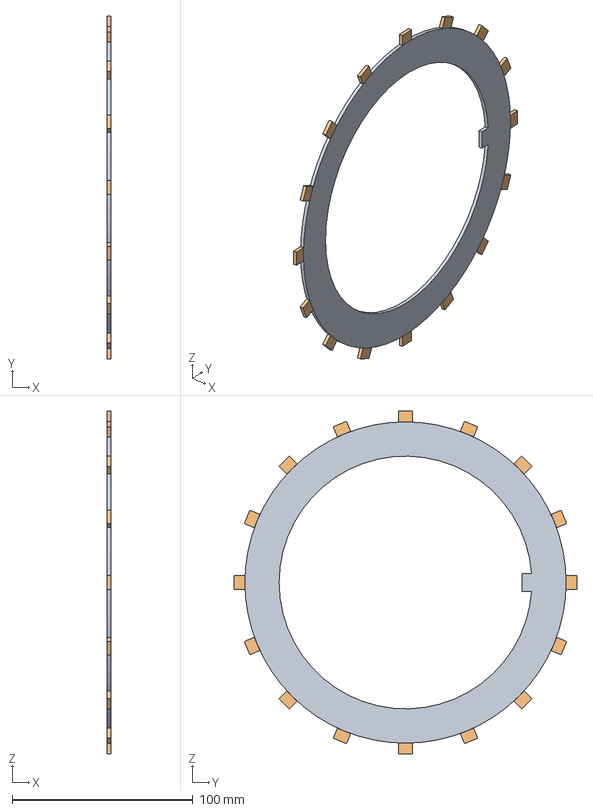
[picture p48: CAD file, 2026-10-29]
out/step/parts/mb.step
2.00 x 190.0 x 190.0 mm
