Sam-Indyk/uatxcavators-tbm/out/step/parts/gsupply.step

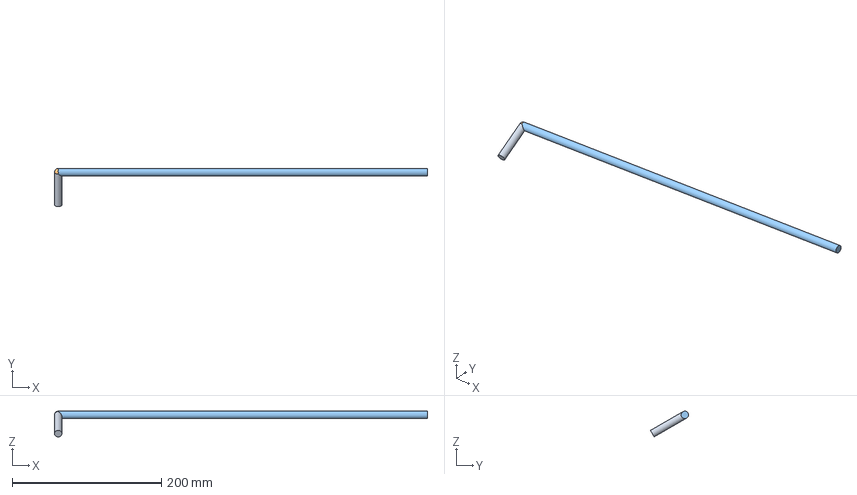
[picture p49: CAD file, 2026-10-29]
out/step/parts/gsupply.step
500.0 x 51.1 x 34.5 mm
