Sam-Indyk/uatxcavators-tbm/out/step/parts/saddles.step

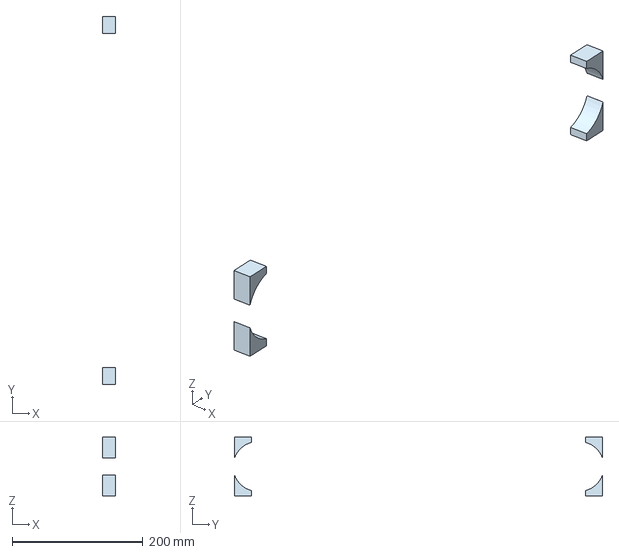
[picture p50: CAD file, 2026-10-29]
out/step/parts/saddles.step
20.0 x 562.0 x 90.0 mm
