Sam-Indyk/uatxcavators-tbm/out/step/parts/hub1la.step

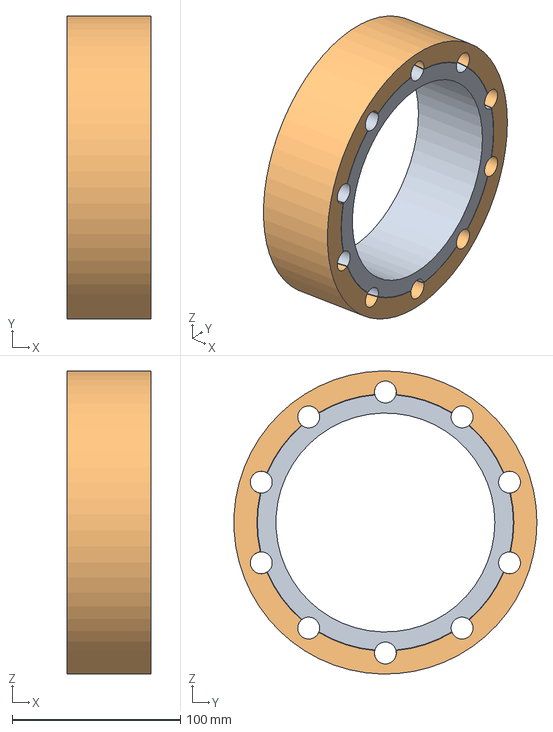
[picture p51: CAD file, 2026-10-29]
out/step/parts/hub1la.step
50.0 x 179.9 x 179.9 mm
