Sam-Indyk/uatxcavators-tbm/out/step/parts/tears.step

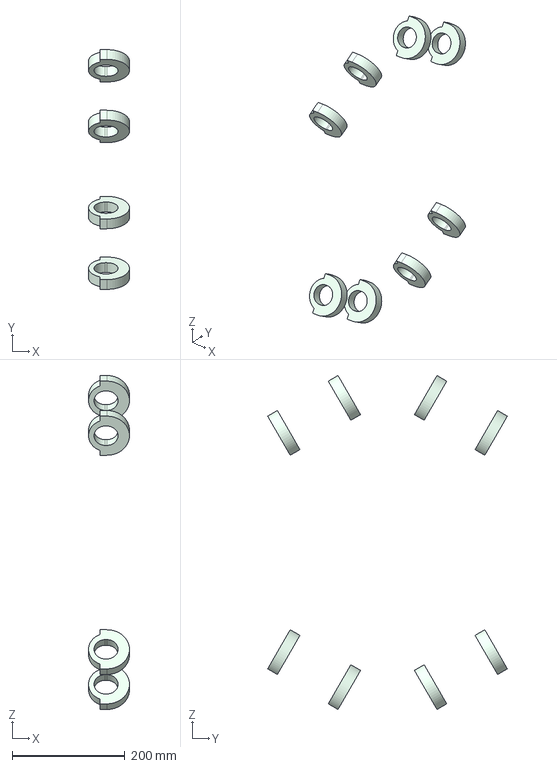
[picture p52: CAD file, 2026-10-29]
out/step/parts/tears.step
72.5 x 424.7 x 591.6 mm
