Sam-Indyk/uatxcavators-tbm/out/step/parts/capcarbide.step

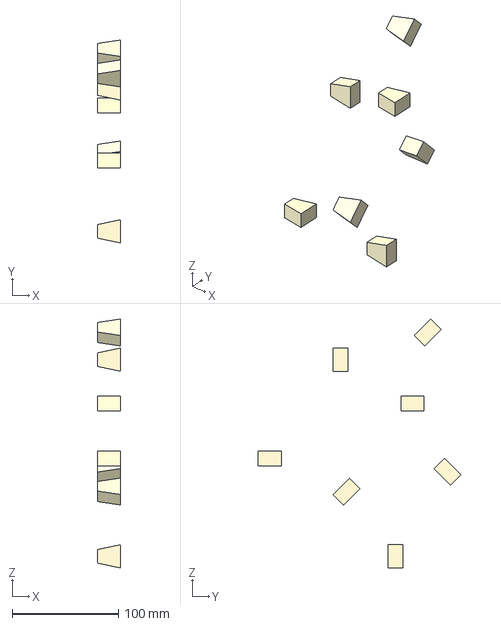
[picture p53: CAD file, 2026-10-29]
out/step/parts/capcarbide.step
22.0 x 191.5 x 234.8 mm
