Sam-Indyk/uatxcavators-tbm/out/step/parts/sealspring.step

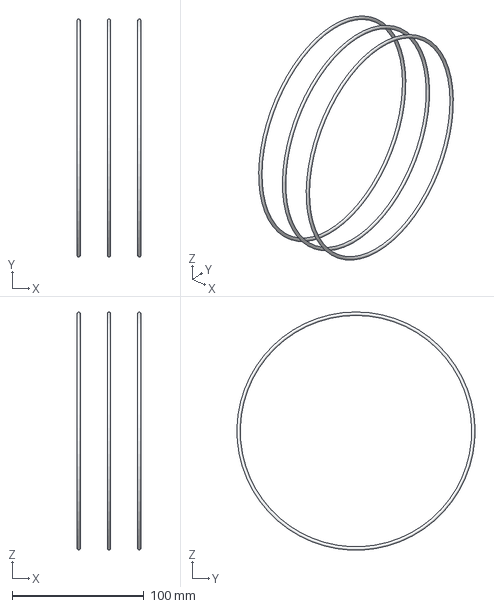
[picture p54: CAD file, 2026-10-29]
out/step/parts/sealspring.step
48.6 x 180.7 x 180.7 mm
