Sam-Indyk/uatxcavators-tbm/out/step/parts/gsupply2.step

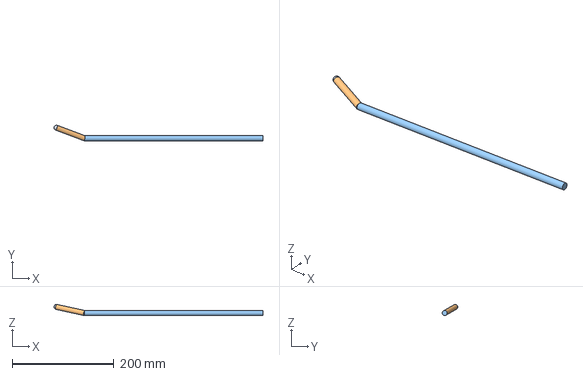
[picture p55: CAD file, 2026-10-29]
out/step/parts/gsupply2.step
410.0 x 30.8 x 22.0 mm
