Sam-Indyk/uatxcavators-tbm/out/step/parts/gussets.step

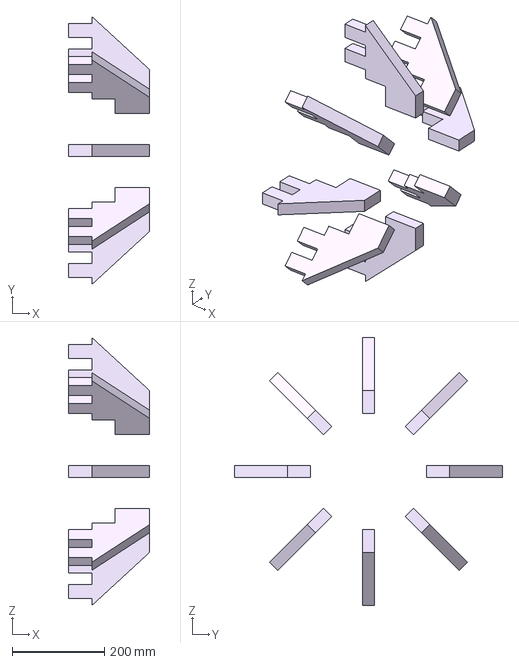
[picture p56: CAD file, 2026-10-29]
out/step/parts/gussets.step
175.8 x 580.0 x 580.0 mm
