Sam-Indyk/uatxcavators-tbm/out/step/parts/sw.step

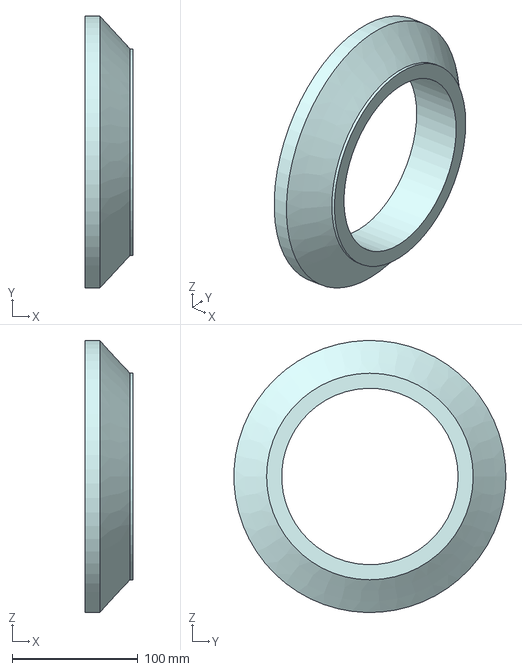
[picture p57: CAD file, 2026-10-29]
out/step/parts/sw.step
38.5 x 215.8 x 215.9 mm
