Sam-Indyk/uatxcavators-tbm/out/step/parts/fin270.step

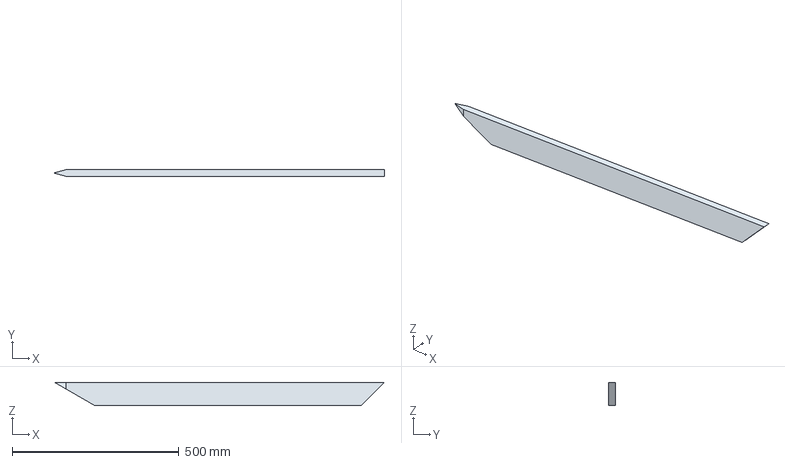
[picture p58: CAD file, 2026-10-29]
out/step/parts/fin270.step
990.0 x 20.0 x 70.0 mm
