Sam-Indyk/uatxcavators-tbm/out/step/parts/hw.step

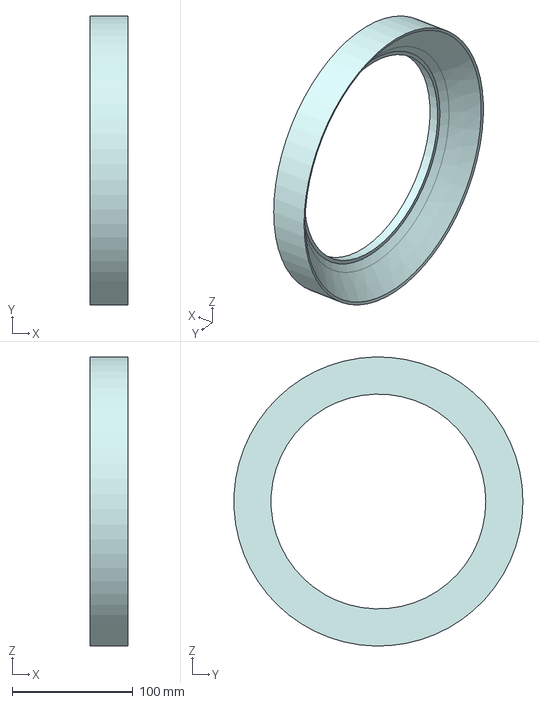
[picture p59: CAD file, 2026-10-29]
out/step/parts/hw.step
31.7 x 239.4 x 239.5 mm
