Sam-Indyk/uatxcavators-tbm/out/step/parts/pipewelds.step

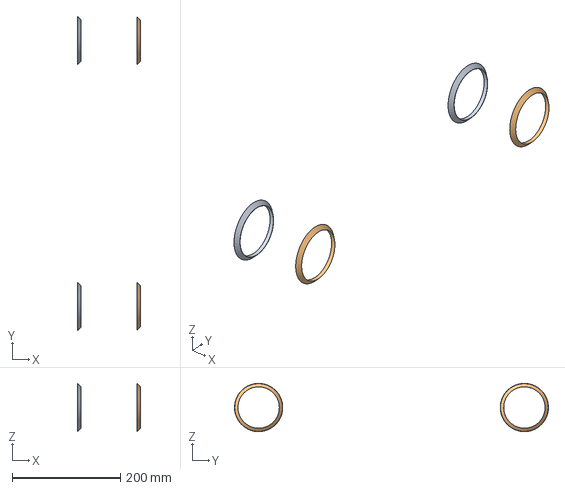
[picture p60: CAD file, 2026-10-29]
out/step/parts/pipewelds.step
116.0 x 579.0 x 88.9 mm
