Sam-Indyk/uatxcavators-tbm/out/step/parts/carbide.step

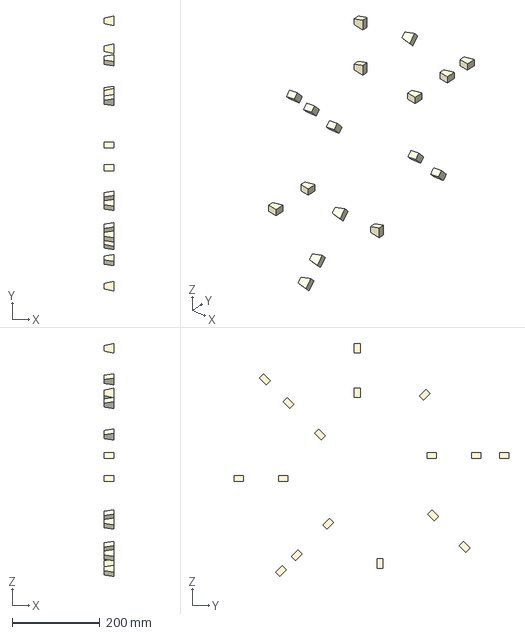
[picture p61: CAD file, 2026-10-29]
out/step/parts/carbide.step
22.0 x 626.6 x 530.9 mm
