Sam-Indyk/uatxcavators-tbm/out/step/parts/fin30.step

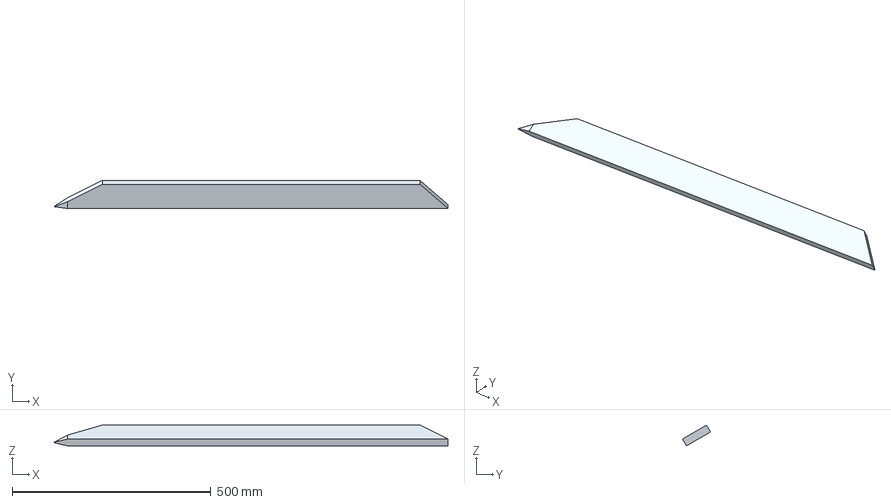
[picture p62: CAD file, 2026-10-29]
out/step/parts/fin30.step
990.0 x 70.6 x 52.3 mm
