Sam-Indyk/uatxcavators-tbm/out/step/parts/adapter.step

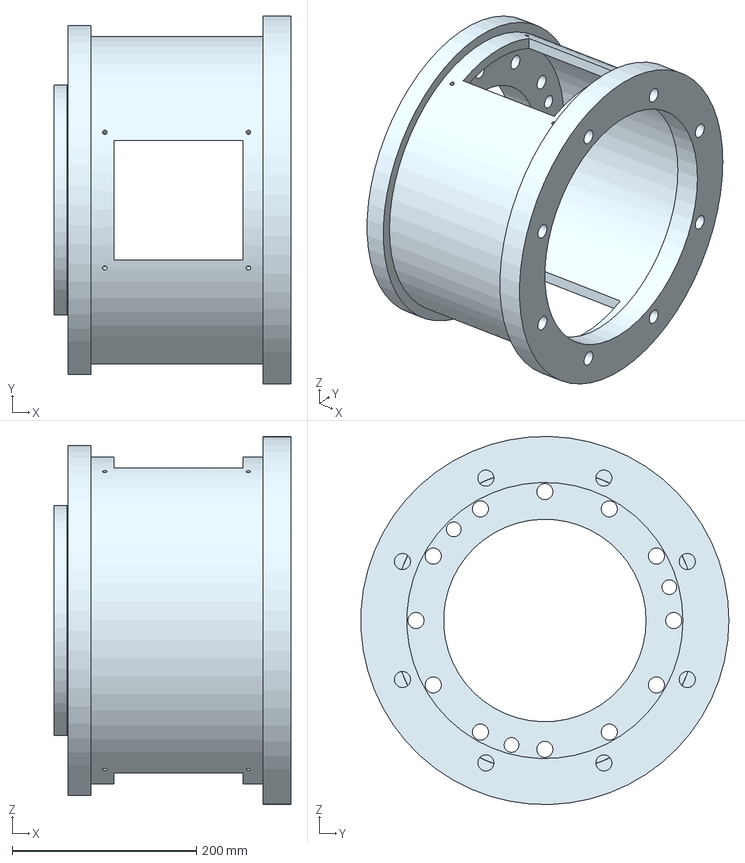
[picture p63: CAD file, 2026-10-29]
out/step/parts/adapter.step
257.0 x 399.7 x 399.8 mm
