Sam-Indyk/uatxcavators-tbm/out/step/parts/r_ir.step

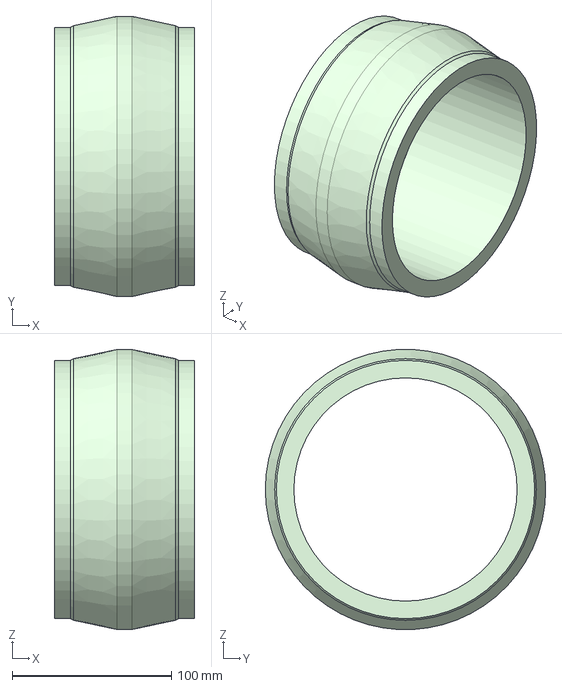
[picture p64: CAD file, 2026-10-29]
out/step/parts/r_ir.step
88.0 x 175.9 x 175.6 mm
