Sam-Indyk/uatxcavators-tbm/out/step/parts/hoses.step

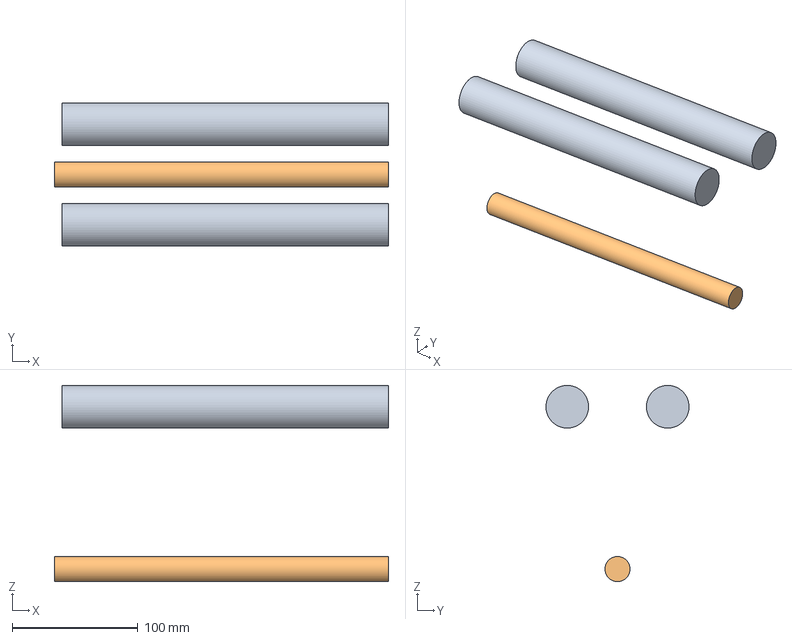
[picture p65: CAD file, 2026-10-29]
out/step/parts/hoses.step
266.0 x 114.0 x 156.3 mm
