Sam-Indyk/uatxcavators-tbm/out/step/parts/adwelds.step

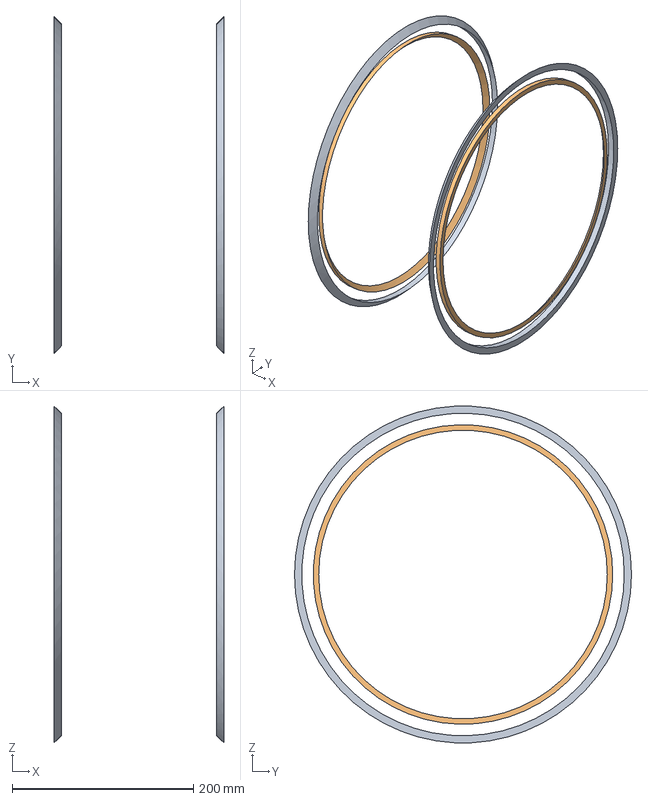
[picture p66: CAD file, 2026-10-29]
out/step/parts/adwelds.step
187.0 x 371.6 x 371.1 mm
