Sam-Indyk/uatxcavators-tbm/out/step/parts/halfA.step

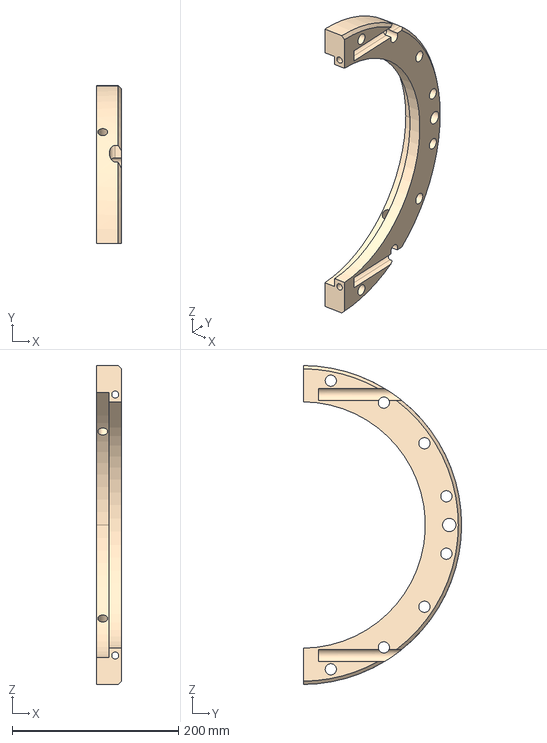
[picture p67: CAD file, 2026-10-29]
out/step/parts/halfA.step
30.0 x 190.4 x 383.8 mm
