Sam-Indyk/uatxcavators-tbm/out/step/parts/f_rol.step

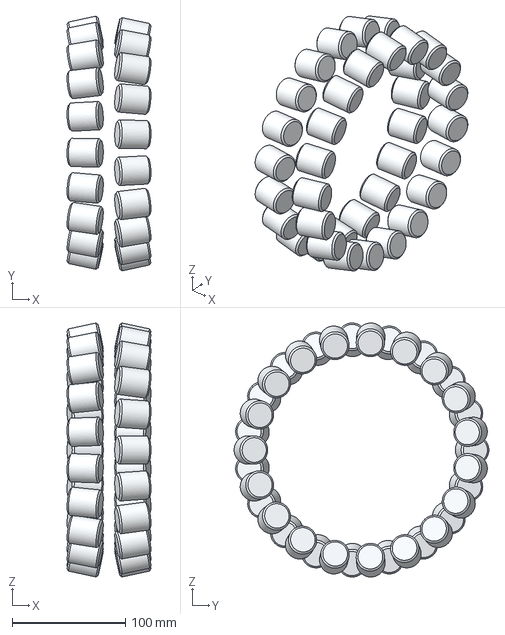
[picture p68: CAD file, 2026-10-29]
out/step/parts/f_rol.step
74.0 x 224.6 x 224.0 mm
