Sam-Indyk/uatxcavators-tbm/out/step/parts/pipes.step

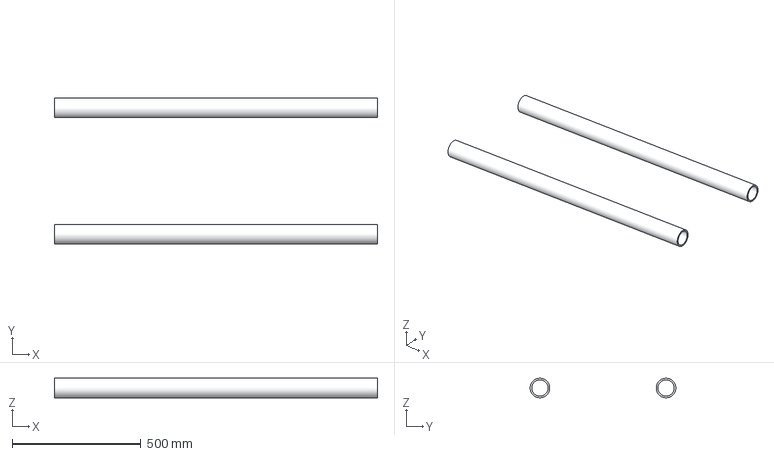
[picture p69: CAD file, 2026-10-29]
out/step/parts/pipes.step
1255.0 x 566.1 x 76.2 mm
