Sam-Indyk/uatxcavators-tbm/out/step/parts/blades.step

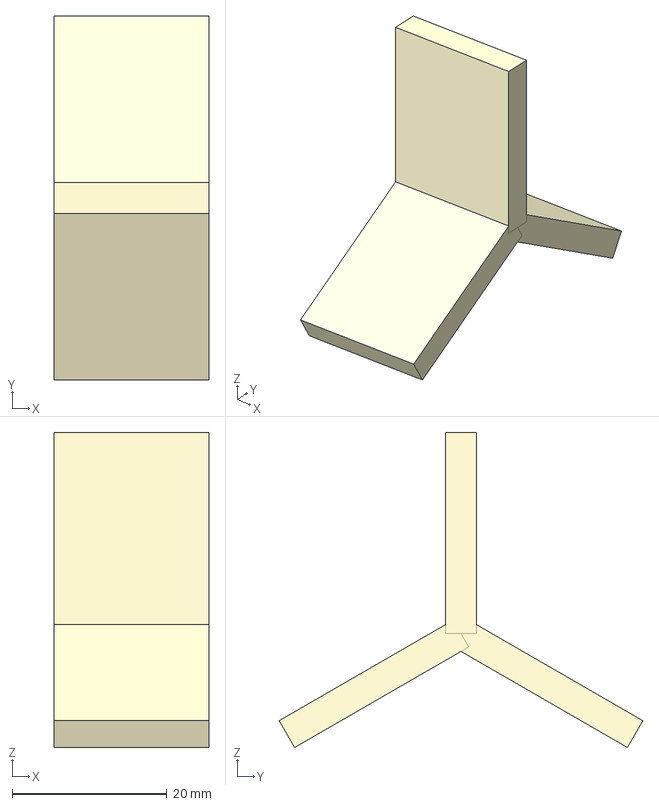
[picture p70: CAD file, 2026-10-29]
out/step/parts/blades.step
20.0 x 47.0 x 40.7 mm
