Sam-Indyk/uatxcavators-tbm/out/step/parts/shell.step

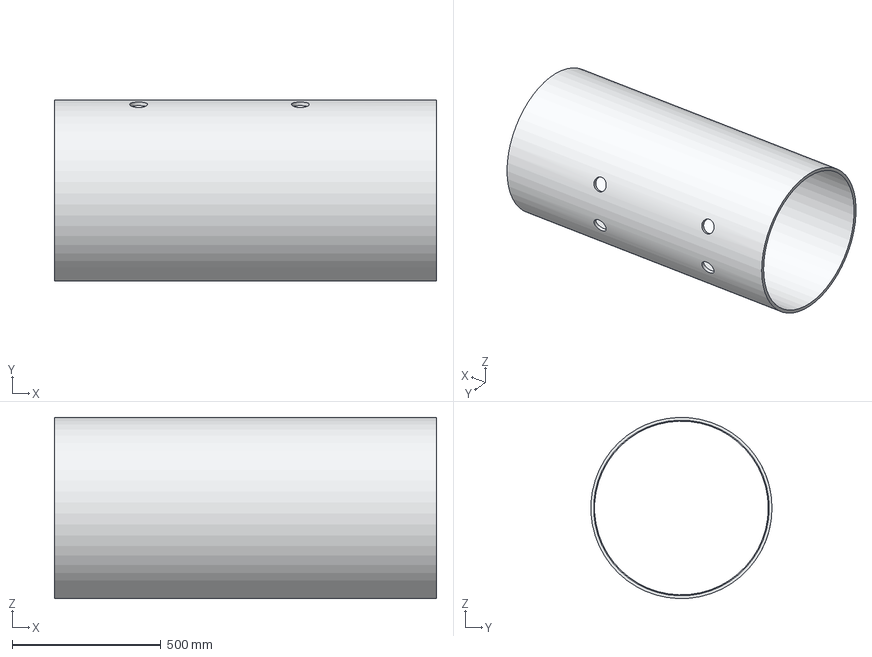
[picture p71: CAD file, 2026-10-29]
out/step/parts/shell.step
1285.0 x 609.0 x 609.3 mm
