Sam-Indyk/uatxcavators-tbm/out/step/parts/tube.step

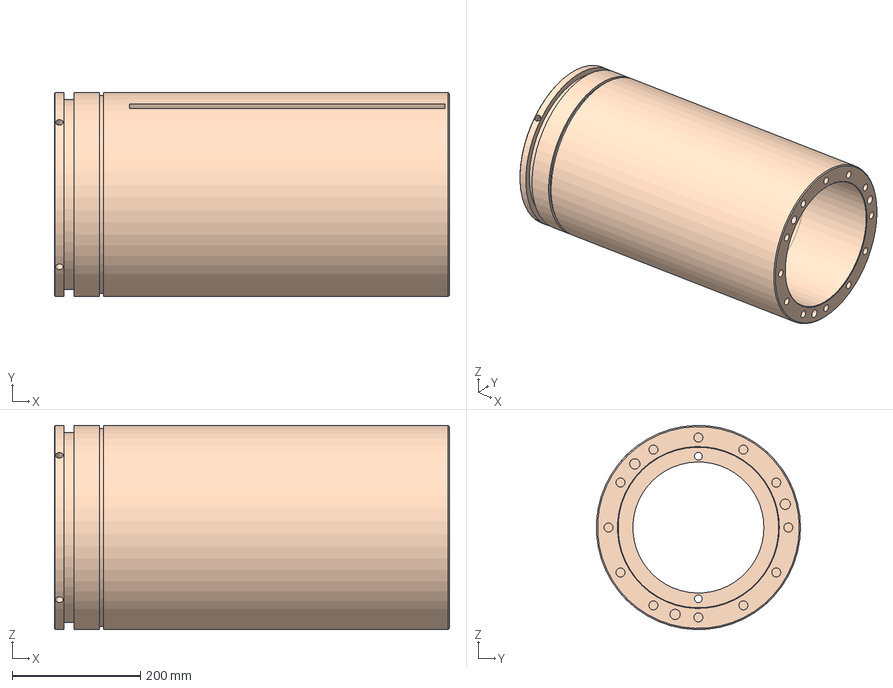
[picture p72: CAD file, 2026-10-29]
out/step/parts/tube.step
615.0 x 317.7 x 317.8 mm
