Sam-Indyk/uatxcavators-tbm/out/step/parts/eye.step

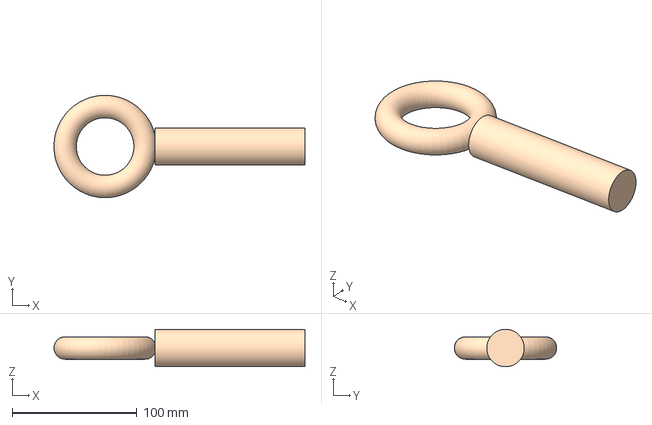
[picture p73: CAD file, 2026-10-29]
out/step/parts/eye.step
200.9 x 82.0 x 30.0 mm
