Sam-Indyk/uatxcavators-tbm/out/step/parts/capholders.step

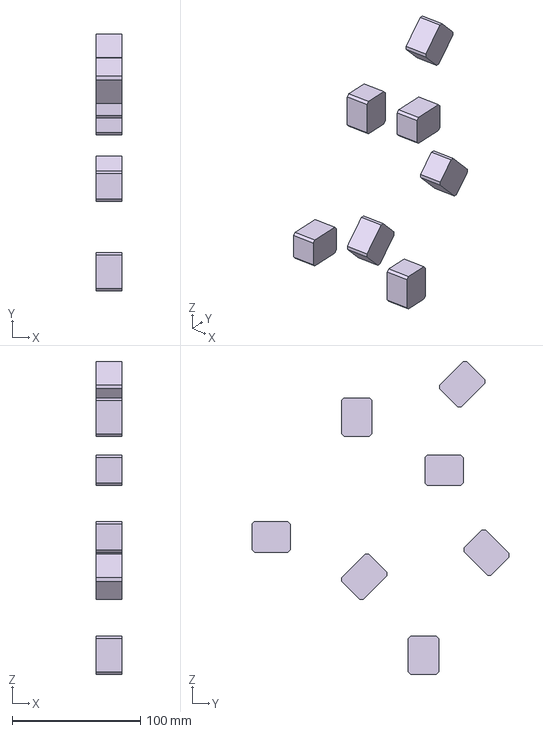
[picture p74: CAD file, 2026-10-29]
out/step/parts/capholders.step
20.0 x 200.4 x 243.8 mm
