Sam-Indyk/uatxcavators-tbm/out/step/parts/mplate.step

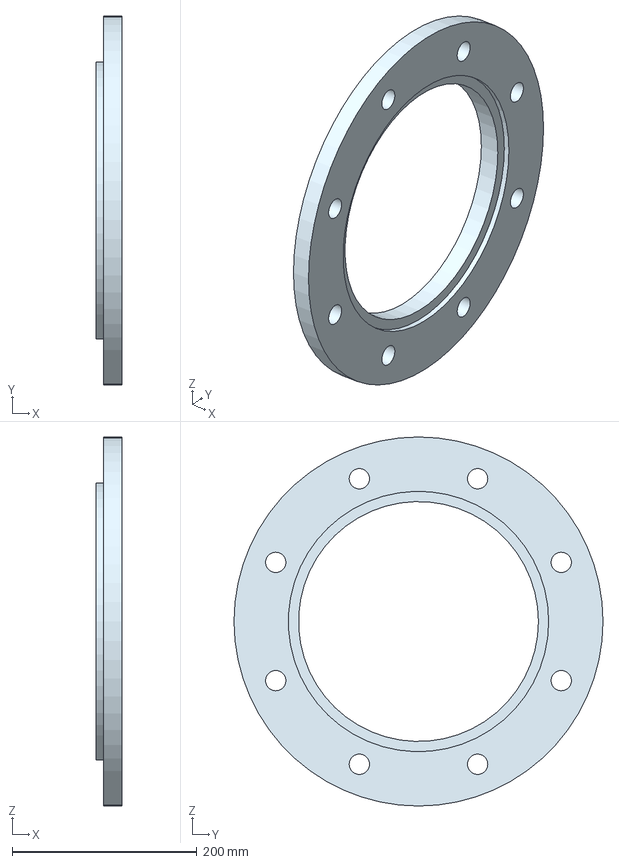
[picture p75: CAD file, 2026-10-29]
out/step/parts/mplate.step
28.0 x 400.0 x 400.0 mm
