Sam-Indyk/uatxcavators-tbm/out/step/parts/carrier.step

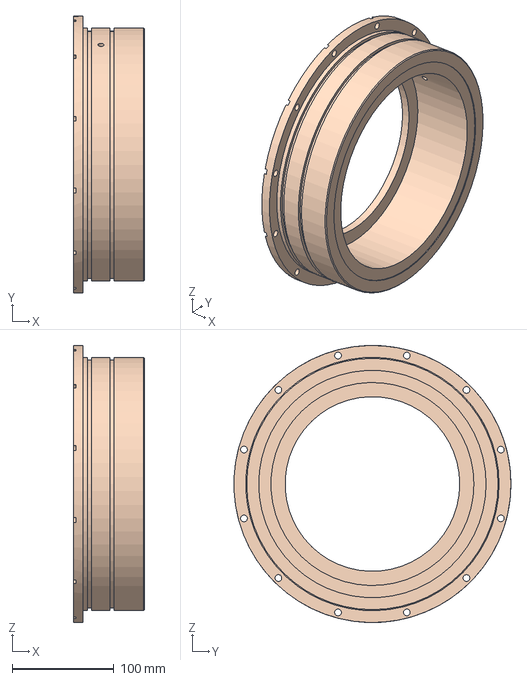
[picture p76: CAD file, 2026-10-29]
out/step/parts/carrier.step
70.0 x 272.8 x 272.9 mm
