Sam-Indyk/uatxcavators-tbm/out/step/parts/addowels.step

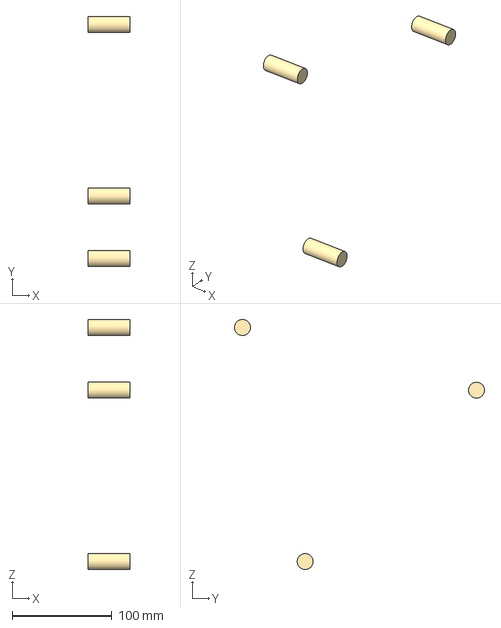
[picture p77: CAD file, 2026-10-29]
out/step/parts/addowels.step
42.0 x 250.2 x 250.2 mm
