Sam-Indyk/uatxcavators-tbm/out/step/parts/motor.step

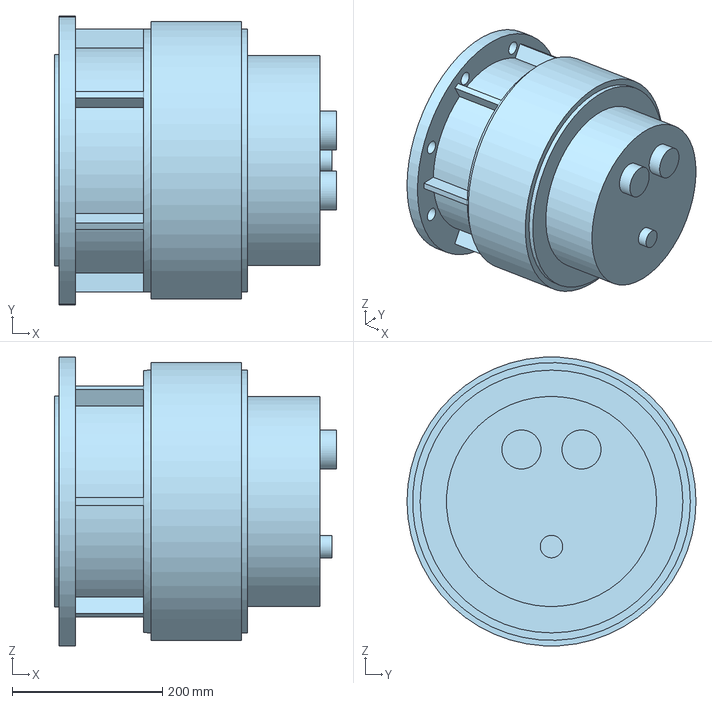
[picture p78: CAD file, 2026-10-29]
out/step/parts/motor.step
376.0 x 385.0 x 384.3 mm
