Sam-Indyk/uatxcavators-tbm/out/step/parts/mshaft.step

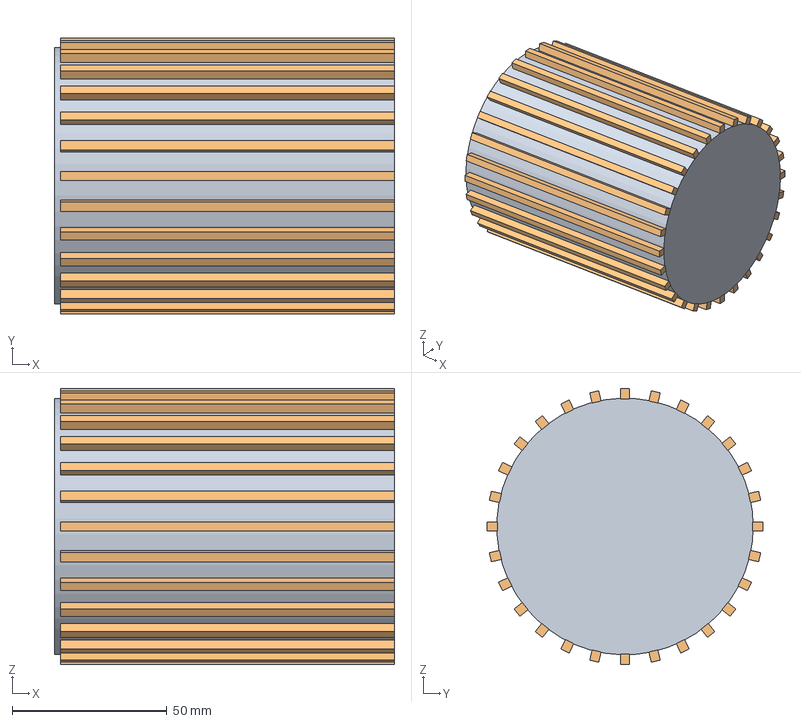
[picture p79: CAD file, 2026-10-29]
out/step/parts/mshaft.step
110.0 x 89.4 x 89.4 mm
