Sam-Indyk/uatxcavators-tbm/out/step/parts/taps.step

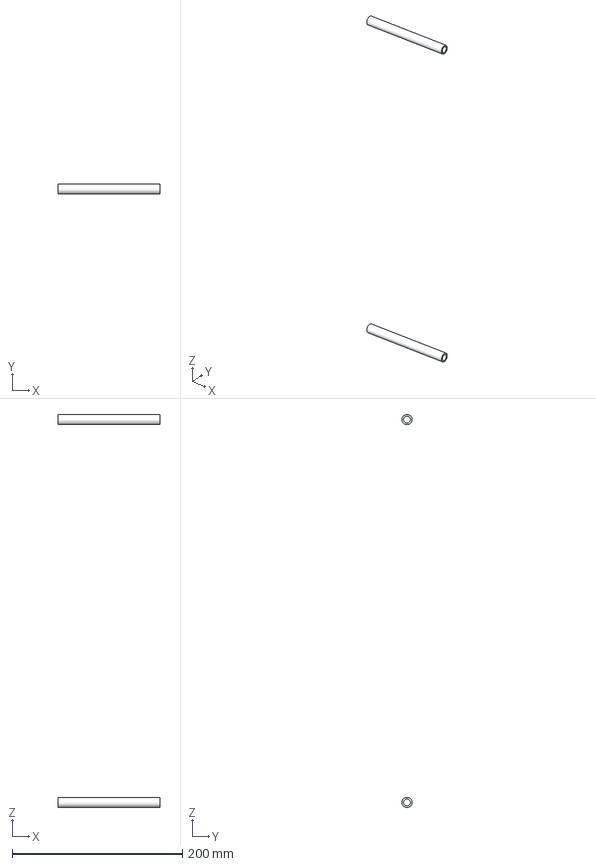
[picture p80: CAD file, 2026-10-29]
out/step/parts/taps.step
120.0 x 12.0 x 462.0 mm
