Sam-Indyk/uatxcavators-tbm/out/step/parts/la.step

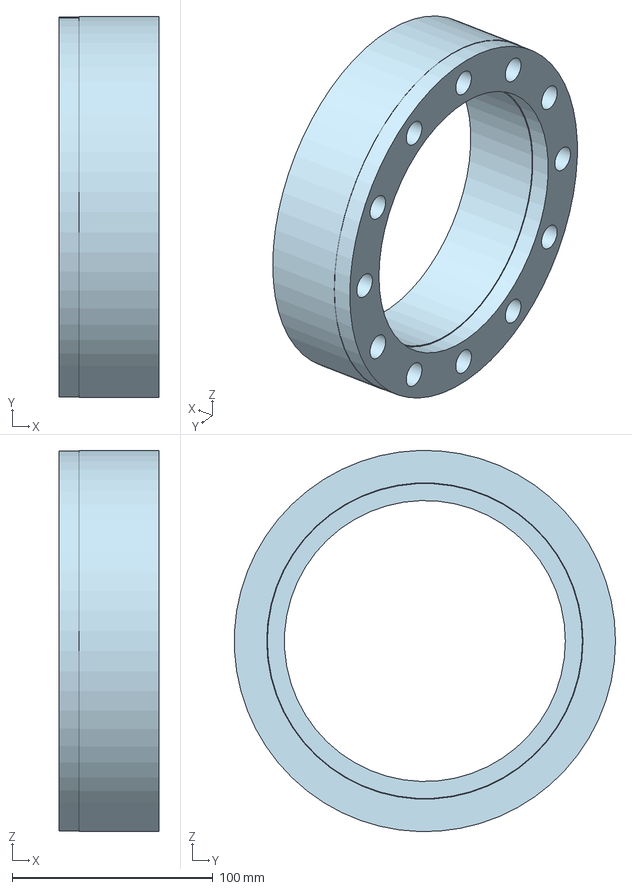
[picture p81: CAD file, 2026-10-29]
out/step/parts/la.step
50.0 x 189.9 x 189.9 mm
