Sam-Indyk/uatxcavators-tbm/out/step/parts/guardscr.step

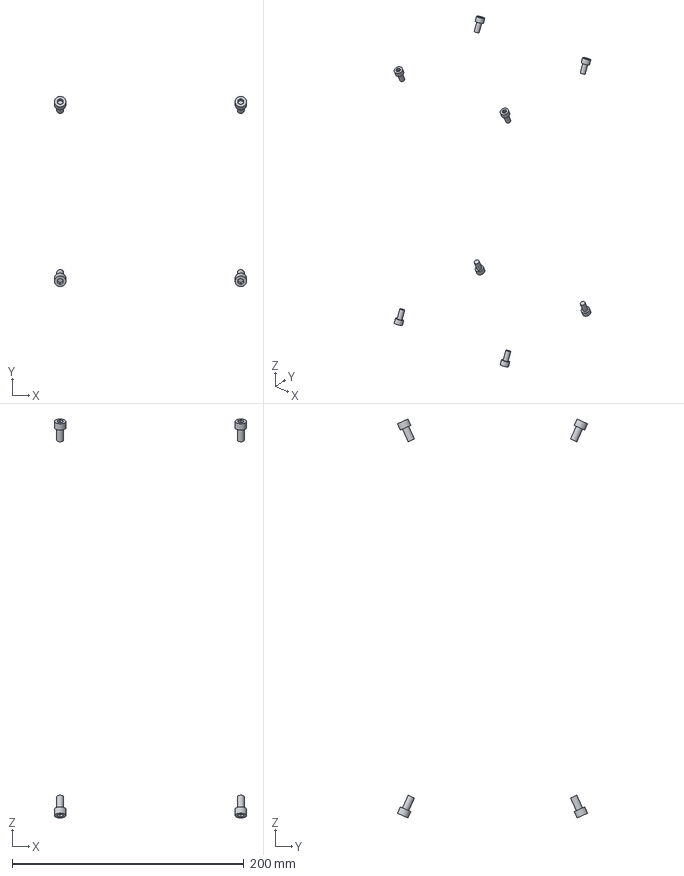
[picture p82: CAD file, 2026-10-29]
out/step/parts/guardscr.step
166.0 x 164.2 x 344.5 mm
