Sam-Indyk/uatxcavators-tbm/out/step/parts/shim.step

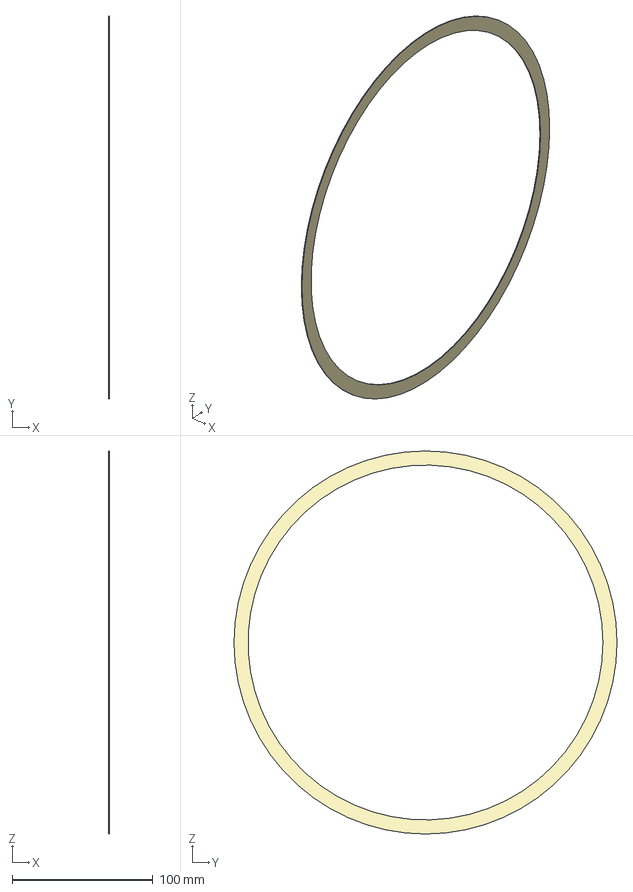
[picture p83: CAD file, 2026-10-29]
out/step/parts/shim.step
0.6 x 272.0 x 272.0 mm
