Sam-Indyk/uatxcavators-tbm/out/step/parts/elast.step

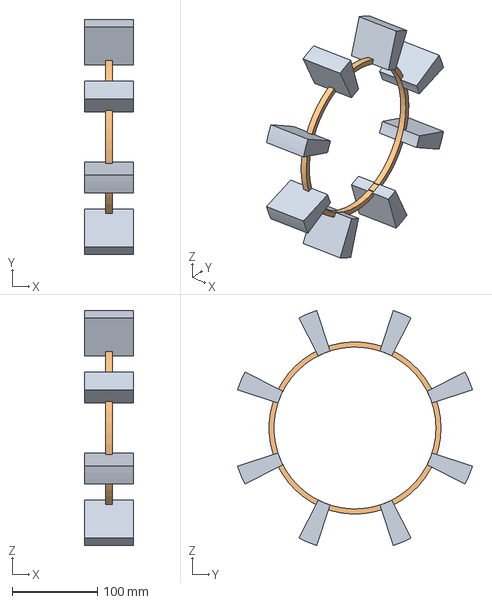
[picture p84: CAD file, 2026-10-29]
out/step/parts/elast.step
57.0 x 275.8 x 275.8 mm
