Sam-Indyk/uatxcavators-tbm/out/step/parts/tring.step

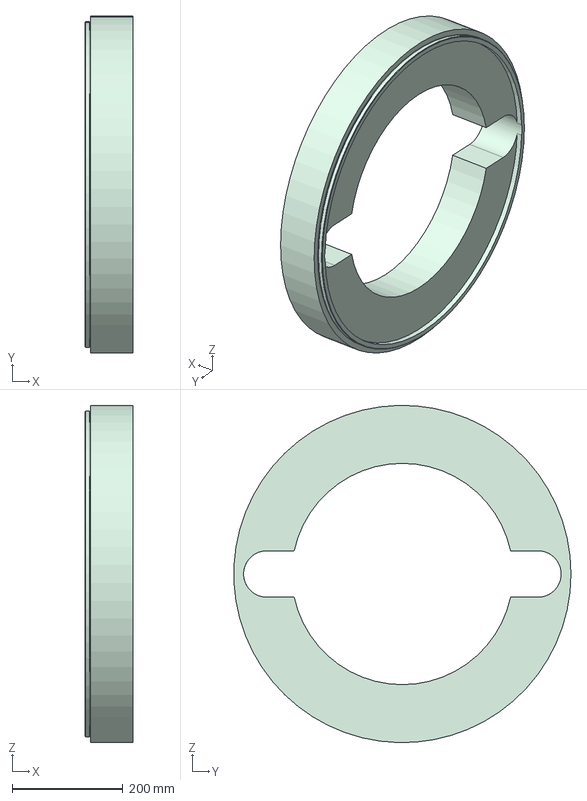
[picture p85: CAD file, 2026-10-29]
out/step/parts/tring.step
86.2 x 609.2 x 609.4 mm
