Sam-Indyk/uatxcavators-tbm/out/step/parts/purge.step

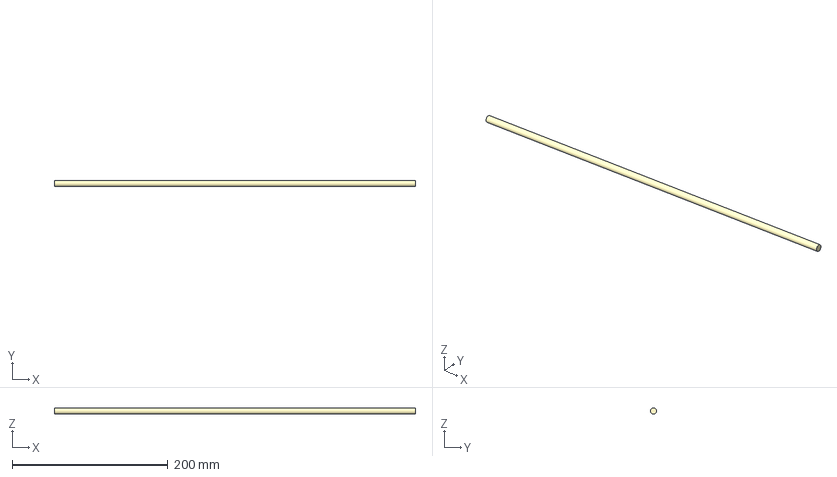
[picture p86: CAD file, 2026-10-29]
out/step/parts/purge.step
463.0 x 7.99 x 8.00 mm
