Sam-Indyk/uatxcavators-tbm/(list of files, cad)

Other CAD files:
out/step/spindle_mount_revH_detail.step
out/step/parts/pin225.step
out/step/parts/pin315.step
out/step/parts/r_cage.step
out/step/parts/tpin60.step
out/step/parts/tpin240.step
out/step/parts/tpin300.step
out/step/parts/pin135.step
out/step/parts/f_ir.step
out/step/parts/r_rol.step
out/step/parts/fin90.step
out/step/parts/f_or.step
out/step/parts/fin330.step
archive/out/spindle_mount.step
archive/out/spindle_mount_motor_bell.step
archive/out/spindle_mount_motor_plate.step
archive/out/spindle_mount_optS.step
archive/out/spindle_mount_optT.step
archive/out/spindle_mount_revC.step
archive/out/spindle_mount_revD.step
archive/out/spindle_mount_revE.step
archive/out/spindle_mount_revF.step
archive/out/spindle_mount_revG.step
out/step/parts/adscrews.step
out/step/parts/capscrews.step
out/step/parts/carscrews.step
out/step/parts/flscrews.step
out/step/parts/lascrews.step
out/step/parts/mbolts.step
out/step/parts/mbolts_r.step
out/step/parts/nut.step
out/step/parts/splitscrews.step
out/step/thrust_ring_revA.step
