Sam-Indyk/uatxcavators-tbm/docs/manual-00-overview.md

# Design manual Rev I · 00 Overview

UATXcavators DN600 slurry microTBM (micro tunnel boring machine). Revision I, 2026-10-28. Generated by `tools/make_manual.py` from the model and calculation scripts in the repo; edit those, not this file.

Units mm, N, MPa (kN, kNm in tables). x = 0 at the ring 1 front face, +x rearward. Clock positions are seen from the front, looking rearward: 0° = 12 o'clock, 90° = 3 o'clock.

This chapter is the entry point: what the machine is, how the chapters are organised, what changed from Rev H and why, and the status of every check.

## Machine

| Item | Value |
|---|---|
| Cut diameter | Ø630 (gauge bits at R315); overcut 10.2 radial over the shield |
| Shield | Ø609.6 × 12.7 pipe, x = -128 to 1157 (1,285 long) |
| Bulkhead | Ring 1, 110 thick, front face 128 behind the shield front edge |
| Overall length | Bit tips x = -225.8 to motor rear x = 1225: 1,450.8; slurry pipes to x = 1255; hoses beyond |
| Cutterhead | 8 arms, 24 trapezoid carbide drag bits on 24 tracks 12.7 apart, centre cone; 12 rpm design speed |
| Main bearings | 2 × 23228 spherical roller bearings 400 apart (radial) + 29328N spherical roller thrust bearing |
| Drive | Poclain MS18 hydraulic motor, 2,812 cm³/rev (44.71 Nm/bar); torque interlock 10 kNm at 235 bar; pump relief 259 bar = 11.58 kNm stall |
| Thrust | 4 × Chief WT 5 × 24 cylinders on the thrust ring: 613.1 kN at the 121 bar cap, 800.6 kN at the 158 bar interlock, 901.4 kN at the 177.9 bar (2,580 psi) pump relief |
| Mass, machine | 1,206 kg (2,658 lb), CG x = 423, y = +5.5 |

| Group | kg | lb | CG x | Parts |
|---|---|---|---|---|
| Shell weldment | 457.3 | 1,008 | 387 | 14 |
| Bearing module | 325.2 | 717 | 282 | 36 |
| Cutterhead | 143.1 | 315 | -117 | 14 |
| Drive | 279.9 | 617 | 922 | 19 |
| **Machine** | **1,205.5** | **2,658** | **423** |  |
| Thrust ring (launch equipment) | 119.0 | 262 | 1,211 | 8 |
| Jacking cylinders (launch equipment) | 210.4 | 464 | 1,771 | 1 |

## Load paths

- **Thrust** (cylinders push the machine into the face; the face pushes back on the bits): bits → spider arms → gussets → hub ring → journal sleeve (contact) → front 23228 inner ring → spindle collar → backing ring → 29328N thrust bearing → cartridge tube shoulder → tube → tube land → split flange → ring 1 counterbore floor → ring 1 → 14 mm fillet weld → shield shell → shield rear end → thrust ring (at launch) or the last jacking pipe → saddles → cylinders → reaction frame.
- **Torque** (motor drives the head; the soil resists): motor shaft → ROTEX coupling → B-LOC 130 × 180 → spindle → B-LOC 140 × 190 → hub ring → arms → bits. Reaction: motor body → pilot plate → adapter → 12 × M16 + 3 dowels → cartridge tube → 4 anti-rotation pins → split flange → 16 × M12 (friction) + 2 dowels → ring 1 → weld → shell → anti-roll fins and skin friction in the ground.
- **Moment** (thrust off-centre on the face): head → spindle → radial couple on the two 23228s (400 apart) → tube → uneven pressure on the ring 1 seat → ring 1 → shell.

## Chapters

| Chapter | Content |
|---|---|
| 00 Overview | This page |
| 01 Loads and criteria | Load cases from the hydraulics, side force, weight, materials, allowables, required factors of safety, FEA method |
| 02 Shell weldment | Shield shell, ring 1 (bulkhead) with FEA, ring 1 weld, slurry pipes, saddles, pressure taps, anti-roll fins, lifting bosses |
| 03 Bearing module | Cartridge tube, split flange and fasteners, seal carrier and seals, seal-purge line, spindle, bearings, nut |
| 04 Cutterhead | Spider plate, gussets, hub ring, journal sleeve, locking assembly, centre cap, bit layout and holders |
| 05 Drive | Motor and hydraulics, adapter, coupling, locking assembly, pilot plate, guards, hoses, purge supply route |
| 06 Thrust ring Rev B | Ring, notches, saddles, ears, pins, cylinders, FEA |
| 07 Assembly, lifting, handling | Assembly sequence (animation steps), fixtures, lift plan, transport loads, collision audit |
| 08 Review log and open items | Rev H → Rev I findings with evidence and resolution; open items |
| 09 Bill of materials | Every part with quantity, material, mass, make or buy |

## Changes from Rev H

| ID | Item | Rev H | Rev I | Reason |
|---|---|---|---|---|
| I-1 | Ring 1 counterbore | Ø400 × 35; flange OD 399.8; bolt circle Ø370; tube land 20 | Ø384 × 30; flange OD 383.8; bolt circle Ø354; tube land 15 | FEA of Rev H: the 6.5 mm wall between the counterbore and the 12 o'clock pipe hole reached 461 MPa peak at LC3. Rev I: 14.5 mm wall, membrane + bending 187 MPa at LC3 (ch. 02) |
| I-2 | Ring 1 material | A572 Gr 50 from 4.5 in plate | A572 Gr 42, 4.5 in plate (Fy 290) | ASTM A572 Gr 50 plate stops at 4 in; Gr 42 covers to 6 in. All ring 1 checks now use Fy 290 |
| I-3 | Slurry pipes | Ø76.1, A53 B assumed; front seal weld only; end flush at the shield rear (x = 1,157) | Ø76.2 × 6.35 A1085 HSS; welded at both ring 1 faces on the bench; run to x = 1255 | Rev H: the thrust ring face covered both pipe bores at launch; pipes now pass the ring through notches; rear weld adds support to the hole |
| I-4 | Thrust ring | Rev A, plain Ø400 bore | Rev B: U-notches 84 wide to R287 at 12 and 6 | Notch zone FEA 44 MPa at LC3 on the casing (ring away from the saddles 87): the notch sits between cylinders, where the ring is lightly loaded |
| I-5 | Seal-purge supply | Ø10 at R209 to x = 1,500 | R209 to x = 1095, down to R185 by x = 1150 | Rev H line ran through the thrust ring annulus (bore R200): 5.98 cm³ interference. Rev I clears the bore by 10 |
| I-6 | Coupling | Jaw coupling Ø280, size not selected; adapter rear bore Ø282 | KTR ROTEX 160, 64 ShD spider, steel hubs (catalogue); adapter rear bore Ø300; 20 mm motor pilot plate carries the motor's Ø282 spigot | Rev H coupling had no rating. ROTEX 160 is the smallest ROTEX whose hub takes the Ø180 locking assembly (max bore 185); its Ø290 hubs do not pass the motor pilot bore, so the pilot moved to a separate plate. A one-piece splined sleeve was rejected (spindle tilt, ch. 05) |
| I-7 | Guards | Adapter windows 140 × 130 open | Bolted 3 mm guards, 4 × M6 each | Rules 3.a.1: rotating parts guarded |
| I-8 | Lifting points | None | 4 bosses Ø60, M20, for Crosby HR-125M hoist rings, x = 155 and 699 | Rules: marked lifting points with allowable force; lifting FoS > 5 (ch. 07) |
| I-9 | Split-flange joint screws | 2 × M10 at x = 15, z = ±172 | 2 × M8 at x = 22.5, z = ±157 | Rev H: the M10 head counterbores broke into the flange bolt holes at 78.75° and 101.25° |
| I-10 | Anti-rotation pins | 4 × Ø16 at x = 10 | 4 × Ø12 at x = 7.5 | Land shortened to 15 (I-1); shear FoS 1.44 at 20 kNm |
| I-11 | Load basis | LC2 590 kN + 62 kNm screen; LC3 800 kN | LC1-LC4 from the cylinder pressures (F = 4 p A), side force added, motor relief per rules | Each case now traces to a pressure setting; 2,580 psi pump relief (901 kN) checked as LC4 (ch. 01) |
| I-12 | Materials | E355 tube Fy 355; adapter tube Fy 345 | E355 Fy 335 (40-65 mm wall band); A106 B adapter tube Fy 241 | EN 10297-1 thickness bands; the 14 in XS pipe is A106 / A53 Gr B |
| I-13 | Bit holders | Weld not specified | 14 mm fillet all round | One bit taking the stall torque (11.58 kNm) at R296: 139 MPa vs 145 |
| I-14 | Fixtures | Shell stands on its rear end on the table | Shell stands on 3 riser blocks 110 high; gauge legs 1157 | Pipes stand 98 proud of the shield rear end (I-3) |
| I-15 | Thrust ring register | Flat front face; ring not located on the shield or casing | Spigot Ø589.5 × 10 high × 9 wide with a 1.5 × 0.5 relief groove; shield rear counterbored Ø590.6 × 12 | Locates the ring concentric with the shield and casing (radial gap 0.55), so the four cylinder forces stay on the pipe wall; the shield end takes the same seat as a casing end. Ported from the Oct 27 local Rev H work; sizes are placeholders until the casing joint drawing |

## Check status

174 checks in `src/calc_revI.py` (hand calculations and FEA results). 1 is below its required factor of safety:

| ID | Part | Check | Case | FoS | Required | Note |
|---|---|---|---|---|---|---|
| CH-7 | Bit holders | gauge holder (16.35 of 30 over the arm end R310), 14 mm fillet: one bit takes the stall torque 11.58 kNm | jam | 0.70 | 1.00 | gauge holder overhangs the arm: open item (cutterhead layout) |

## Glossary

| Term | Meaning |
|---|---|
| Bulkhead (ring 1) | The plate that separates the pressurised slurry chamber at the face from the dry machine interior; it carries the full thrust to the shell |
| Slurry | Water-bentonite mix pumped to the face and back; it carries the cuttings |
| Overcut | Radial gap between the cut bore (R315) and the shield (R304.8) |
| Jam | The cutterhead stops against an obstruction while the cylinders keep pushing |
| Interlock | Control-system limit that stops a function (torque 10 kNm; thrust 158 bar) |
| Relief valve | Hydraulic valve that opens at a set pressure and caps it |
| ASD | Allowable stress design: stresses kept below a fraction of yield (0.6 Fy bending and axial, 0.4 Fy shear, 0.9 Fy bearing) |
| FoS | Factor of safety = capacity / demand. "FoS yield" uses the yield strength as the capacity |
| Fy, Fu | Minimum yield and tensile strength of the material |
| FEA | Finite element analysis: the part is split into small tetrahedra and solved for stress |
| Pm, Pb, peak | Through a section, Pm is the average (membrane) stress, Pb the linearly varying (bending) part, peak the remainder at notches; "linearization" separates them |
| Locking assembly (B-LOC) | Keyless clamp ring: tightening its screws wedges two tapered rings between shaft and hub |
| Spherical roller bearing | Roller bearing with a spherical outer raceway; self-aligning, so the shaft may tilt in it |
| s0 | Bearing static safety factor: static load rating C0 / equivalent static load |
| L10 | Bearing rating life: millions of revolutions reached by 90 % of bearings |
| Fillet weld throat | Weld size 0.707 × leg; weld stress = force per length / throat |
| Hoist ring | Swivel lifting eye bolted into a tapped hole; rated in every pull direction |
| Shore D (64 ShD) | Hardness of the coupling's polyurethane spider |
| Hertz contact | Contact stress between curved surfaces (here a cylinder in a slightly larger seat) |
| Winkler foundation | Support modelled as distributed springs: pressure proportional to deflection |
