Sam-Indyk/uatxcavators-tbm/docs/manual-03-bearing-module.md

# Design manual Rev I · 03 Bearing module

UATXcavators DN600 slurry microTBM (micro tunnel boring machine). Revision I, 2026-10-28. Generated by `tools/make_manual.py` from the model and calculation scripts in the repo; edit those, not this file.

Units mm, N, MPa (kN, kNm in tables). x = 0 at the ring 1 front face, +x rearward. Clock positions are seen from the front, looking rearward: 0° = 12 o'clock, 90° = 3 o'clock.

The bearing module is the bench-assembled cartridge that carries the spindle on three bearings. It drops into ring 1 from the front and is held by the split flange. Calculations: `src/calc_revI.py` rows FL, CT, SP, BR.

Parts and masses (model):

| Key | Part | kg |
|---|---|---|
| tube | Cartridge tube, seamless 323.9 × 60 | 147.23 |
| halfA | Split flange half A | 4.03 |
| halfB | Split flange half B | 4.27 |
| splitscrews | Split-joint screws 2 × M8 | 0.05 |
| pin45 | Anti-rotation pin Ø12 at 45° | 0.04 |
| pin135 | Anti-rotation pin Ø12 at 135° | 0.04 |
| pin225 | Anti-rotation pin Ø12 at 225° | 0.04 |
| pin315 | Anti-rotation pin Ø12 at 315° | 0.04 |
| oring | Static O-ring on tube | 0.18 |
| purge | Seal-purge line Ø8 in OD groove | 0.18 |
| purgefit | Purge line fittings (low profile) | 0.02 |
| flscrews | Flange screws 16 × M12 × 40 10.9 | 0.87 |
| fldowels | Dowels 2 × Ø16, flange to ring 1 | 0.16 |
| carrier | Seal carrier | 9.88 |
| sealcase | Lip seals 170 × 200 × 15 ×3: steel case | 0.86 |
| seallip | Lip seals: NBR lips | 0.22 |
| sealspring | Lip seals: garter springs | 0.07 |
| lantern | Lantern rings ×2 | 0.87 |
| shim | Carrier shims | 0.04 |
| carscrews | Carrier screws 12 × M6 countersunk | 0.07 |
| hw | 29328N housing washer | 3.15 |
| shaft | Spindle Ø140, 4140 QT | 100.67 |
| f_ir | Front 23228: inner ring | 4.78 |
| f_or | Front 23228: outer ring | 7.29 |
| f_rol | Front 23228: rollers 2 × 19 | 4.04 |
| f_cage | Front 23228: cage rings + guide ring | 0.61 |
| backing | Backing ring Ø190 | 1.52 |
| sw | 29328N shaft washer | 4.59 |
| t_rol | 29328N rollers ×24 | 1.04 |
| spacer | Spacer sleeve | 9.01 |
| r_ir | Rear 23228: inner ring | 4.78 |
| r_or | Rear 23228: outer ring | 7.29 |
| r_rol | Rear 23228: rollers 2 × 19 | 4.04 |
| r_cage | Rear 23228: cage rings + guide ring | 0.61 |
| mb | MB28 lock washer | 0.16 |
| nut | KM28 lock nut | 2.46 |

Module mass 325.2 kg, CG x = 282.

## 3.1 Arrangement

| Item | x | Role |
|---|---|---|
| Seal carrier | 0-70 | flange in the tube's Ø274 × 10 front recess, body in the Ø250 bore; rear face clamps the front 23228 outer ring through shims |
| Front 23228 | 70-158 | radial bearing; inner ring is also a spacer in the thrust path |
| Spindle collar Ø165 | 158-173 | integral with the spindle |
| Backing ring Ø190 × Ø140 | 173-188 | supports the 29328N shaft washer to Ø190 (SKF d_a min 185) |
| 29328N thrust bearing | 188-248 | shaft washer 188-226.5, housing washer 216.3-248 |
| Tube shoulder Ø204 | 248-278 | ID left as rolled; housing washer bears on it (SKF D_a max 208) |
| Spacer sleeve | 226.5-470 | between the 29328N shaft washer and the rear 23228 inner ring |
| Rear 23228 | 470-558 | radial bearing; outer ring floats axially in the Ø250 rear seat |
| MB28 + KM28 | 558-585 | lock washer and nut on M140 × 2: clamp the inner-ring stack |
| Tube rear face | 615 | adapter seat: 12 × M16 on Ø280, 3 × Ø16 dowels |
| Spindle drive end Ø130 | 588-715 | plain, for the B-LOC 130 × 180 in the coupling hub |

Two spherical roller bearings 400 apart carry all radial load and the jam moment as a couple; the 29328N carries all thrust. All three are self-aligning, so the spindle may tilt under the jam moment without edge-loading a bearing. The 29328N housing washer sits radially free in a Ø241 bore, so it takes no radial load. End play 0.10-0.20 is set by shims under the seal carrier.

Thrust path through the module: journal sleeve (head) → front 23228 inner ring → collar → backing ring → 29328N → tube shoulder → tube → tube land → split flange → ring 1 seat. The inner ring of the front 23228 works as a spacer (face stress row BR-6).

| Bearing | d × D × B (mm) | C (kN) | C0 (kN) | Note |
|---|---|---|---|---|
| 23228 CC/W33 (×2) | 140 × 250 × 88 | 915 | 1,250 | Spherical roller, self-aligning; W33 lubrication groove |
| 29328 E (29328N) (×1) | 140 × 240 × 60 | 980 | 2,850 | Spherical roller thrust, self-aligning; carries axial load only (housing washer radially free) |

Ratings are SKF catalogue values used as proxies for the Koyo bearings (Koyo values open).

### Bearing loads

The jam moment M is reacted by a radial couple on the two 23228s; the side force F_s, applied at the cutting face a = 329 ahead of the front bearing centre, adds a reaction at 90° to it:

```
R_M = M / L = M / 400                    R_s = F_s (L + a) / L = F_s × 1.823
F_r,front = √(R_M² + R_s²)               s0 = C0 / F_r          (F_a on the 23228s = 0: the 29328N takes it)
29328N: s0 = C0 / F                       L10 = (C / P)^(10/3) million revolutions, P = F at LC1
```

| ID | Part | Check | Case | Value | Allowable (basis) | FoS | FoS yield | Required | Status |
|---|---|---|---|---|---|---|---|---|---|
| BR-3 | 29328N | basic rating life at LC1 (normal boring), millions of revolutions | LC1 | 50.0 Mrev | 0.0 (3,600 rev per 5 m drive) | 13,898.75 | – | 1.00 | ok |
| BR-4 | Front 23228 | basic rating life at LC1, millions of revolutions | LC1 | 17,528.9 Mrev | 0.0 (3,600 rev per 5 m drive) | 4,869,147.88 | – | 1.00 | ok |
| BR-1 | Front 23228 | static safety s0 = C0/P0 (P0 = Fr; thrust taken by the 29328N) | LC2 | 6.93 – | 2.0 (s0 ≥ 2 (shock)) | 3.47 | – | 1.00 | ok |
| BR-2 | 29328N | static safety s0 = C0/Fa | LC2 | 4.65 – | 2.0 (s0 ≥ 2 (shock)) | 2.32 | – | 1.00 | ok |
| BR-1 | Front 23228 | static safety s0 = C0/P0 (P0 = Fr; thrust taken by the 29328N) | LC3 | 5.51 – | 2.0 (s0 ≥ 2 (shock)) | 2.75 | – | 1.00 | ok |
| BR-2 | 29328N | static safety s0 = C0/Fa | LC3 | 3.56 – | 2.0 (s0 ≥ 2 (shock)) | 1.78 | – | 1.00 | ok |
| BR-1 | Front 23228 | static safety s0 = C0/P0 (P0 = Fr; thrust taken by the 29328N) | LC4 | 4.95 – | 2.0 (s0 ≥ 2 (shock)) | 2.48 | – | 1.00 | ok |
| BR-2 | 29328N | static safety s0 = C0/Fa | LC4 | 3.16 – | 2.0 (s0 ≥ 2 (shock)) | 1.58 | – | 0.75 | ok |
| BR-5 | 23228 pair | spindle slope at the rear bearing at LC3 vs spherical-bearing misalignment (≥ 1.5°) | LC3 | 0.09 ° | 1.5 (SKF 23228 permissible) | 16.85 | – | 1.00 | ok |

Equations behind the rows:

- **BR-3 LC1**: L10 = (C/P)^(10/3) = (980/303)^(10/3) → **50.04 Mrev**
- **BR-4 LC1**: L10 = (915/48.8)^(10/3) → **17,528.93 Mrev**
- **BR-1 LC2**: Fr = √[(M/L)² + (F_s(L + a)/L)²] = √[169² + 64²] = 180 kN; s0 = 1250/180 → **6.93 –**
- **BR-2 LC2**: s0 = 2850/613 → **4.65 –**
- **BR-1 LC3**: Fr = √[(M/L)² + (F_s(L + a)/L)²] = √[218² + 64²] = 227 kN; s0 = 1250/227 → **5.51 –**
- **BR-2 LC3**: s0 = 2850/801 → **3.56 –**
- **BR-1 LC4**: Fr = √[(M/L)² + (F_s(L + a)/L)²] = √[244² + 64²] = 252 kN; s0 = 1250/252 → **4.95 –**
- **BR-2 LC4**: s0 = 2850/901 → **3.16 –**
- **BR-5 LC3**: θ = M L/(6 E I) = 87.9e6 × 400/(6 × 200,000 × 1.89e+07) → **0.09 °**

## 3.2 Cartridge tube

| Item | Value |
|---|---|
| Function | Housing for all three bearings; carries thrust from the 29328N to the split flange; carries the drive adapter and the motor torque reaction |
| Stock | Seamless tube 323.9 × 60, EN 10297-1 E355 (Fy 335 in the 40-65 mm wall band), 615 long |
| OD | Ø318 turned; 15 long land at the front (x = 0-15), Ø296 groove x = 15-30 for the split flange lip |
| Bores | Ø274 × 10 recess (carrier flange); Ø250 H7 x = 10-158 (carrier + front 23228); Ø252 relief; Ø241 x = 188-248 (29328N housing washer, radially free); Ø204 as-rolled shoulder x = 248-278; Ø252 relief; Ø250 H7 x = 465-615 (rear 23228, floating) |
| Holes | 12 × M6 on Ø262 at the front face (carrier); 12 × M16 × 26 deep on Ø280 and 3 × Ø16 dowel holes at the rear face (adapter); 4 × Ø12 radial pin holes at x = 7.5; O-ring groove x = 70-76 under ring 1 |
| Purge drillings | Axial Ø5 at R142.5 (30°) from x = 6 to 126; radial Ø5 at x = 27 into the carrier port and at x = 125 to the OD groove (14 wide × 9 deep, x = 117-608) that holds the Ø8 purge line |
| Mass | 147.2 kg |
| Manufacture | Saw → lathe setup 1 (front): OD, land, groove, front recess, Ø250 H7 front seat, Ø252, Ø241, shoulder face → setup 2 (rear, indicated on the OD): Ø252, Ø250 H7 rear seat, rear face → drill and tap → mill the purge groove |

The groove root (Ø296 × Ø250) is the weakest section of the tube: it carries the full thrust and the jam moment.

```
CT-1:  σ = F/A + M/S,  A = π(148² − 125²) = 19,726 mm²,  S = π(148⁴ − 125⁴)/(4 × 148) = 1,250,506 mm³
```

| ID | Part | Check | Case | Value | Allowable (basis) | FoS | FoS yield | Required | Status |
|---|---|---|---|---|---|---|---|---|---|
| FL-2 | Cartridge tube | land shear at R148 over 15 | LC3 | 57.4 MPa | 134.0 (0.4 Fy) | 2.33 | 3.37 | 1.00 | ok |
| FL-2 | Cartridge tube | land shear at R148 over 15 | LC4 | 64.6 MPa | 134.0 (0.4 Fy) | 2.07 | 2.99 | 1.00 | ok |
| CT-1 | Cartridge tube | groove root Ø296 × Ø250: tension + bending | LC3 | 110.6 MPa | 201.0 (0.6 Fy) | 1.82 | 3.03 | 1.00 | ok |
| CT-2 | Cartridge tube | body Ø318 × Ø250 at the front seat: tension + bending | LC3 | 71.4 MPa | 201.0 (0.6 Fy) | 2.81 | 4.69 | 1.00 | ok |
| CT-3 | Cartridge tube | 29328N housing washer on the as-rolled shoulder (Ø204-240) | LC3 | 63.8 MPa | 301.5 (0.9 Fy) | 4.73 | 5.25 | 1.00 | ok |
| CT-4 | Cartridge tube | shoulder root shear, Ø241 × 30 | LC3 | 35.2 MPa | 134.0 (0.4 Fy) | 3.80 | 5.48 | 1.00 | ok |
| CT-1 | Cartridge tube | groove root Ø296 × Ø250: tension + bending | LC4 | 124.1 MPa | 201.0 (0.6 Fy) | 1.62 | 2.70 | 1.00 | ok |
| CT-2 | Cartridge tube | body Ø318 × Ø250 at the front seat: tension + bending | LC4 | 80.1 MPa | 201.0 (0.6 Fy) | 2.51 | 4.18 | 1.00 | ok |
| CT-3 | Cartridge tube | 29328N housing washer on the as-rolled shoulder (Ø204-240) | LC4 | 71.8 MPa | 301.5 (0.9 Fy) | 4.20 | 4.67 | 1.00 | ok |
| CT-4 | Cartridge tube | shoulder root shear, Ø241 × 30 | LC4 | 39.7 MPa | 134.0 (0.4 Fy) | 3.38 | 4.87 | 1.00 | ok |
| CT-5 | Cartridge tube | torsion at 20 kNm (drive reaction to ring 1) | torque | 5.13 MPa | 134.0 (0.4 Fy) | 26.14 | 37.71 | 1.00 | ok |

Equations behind the rows:

- **FL-2 LC3**: τ = F/(2π × 148 × 15) → **57.40 MPa**
- **FL-2 LC4**: τ = F/(2π × 148 × 15) → **64.62 MPa**
- **CT-1 LC3**: σ = F/A + M/S = 800.6e3/19726 + 87.51e6/1250506 → **110.57 MPa**
- **CT-2 LC3**: σ = F/A + M/S = 800.6e3/30335 + 87.87e6/1951089 → **71.43 MPa**
- **CT-3 LC3**: σ = F/[π(120² − 102²)] → **63.77 MPa**
- **CT-4 LC3**: τ = F/(π × 241 × 30) → **35.25 MPa**
- **CT-1 LC4**: σ = F/A + M/S = 901.4e3/19726 + 98.05e6/1250506 → **124.10 MPa**
- **CT-2 LC4**: σ = F/A + M/S = 901.4e3/30335 + 98.37e6/1951089 → **80.13 MPa**
- **CT-3 LC4**: σ = F/[π(120² − 102²)] → **71.80 MPa**
- **CT-4 LC4**: τ = F/(π × 241 × 30) → **39.68 MPa**
- **CT-5 torque**: τ = T r/J = 20e6 × 159/6.2e+08 → **5.13 MPa**

## 3.3 Split flange and its fasteners

| Item | Value |
|---|---|
| Function | Transfers the tube's thrust and moment to the ring 1 seat. A one-piece lip on the tube would need Ø340 hollow bar, which is not stock (Ovako hollow bar stops at OD 242.7), so the lip is a separate split ring |
| Halves | 2 half rings, split at 3 and 9 o'clock (plane y = 0) with a 3 mm kerf; 30 thick; OD 383.8 (Ø384 counterbore); bore Ø318.4 over the land (x = 0-15), lip Ø296.4 in the tube groove (x = 15-30) |
| Material | A572 Gr 50, from 1.5 in plate |
| Flange screws | 16 × M12 × 40, class 10.9, on Ø354, heads in Ø20 × 13 counterbores; 100 Nm (70 % of proof, preload 49.0 kN each); 23 engaged in ring 1 |
| Dowels | 2 × Ø16 × 50 hardened, at 12 and 6 on Ø354; reamed through the flange into ring 1 at the first assembly |
| Split screws | 2 × M8 × 40, class 10.9, across each split at x = 22.5, z = ±157; head counterbore Ø14 open to the OD and the rear face. They hold the halves together for handling only |
| Anti-rotation pins | 4 × Ø12 hardened dowel pins, radial at x = 7.5, 45°/135°/225°/315°, through the flange into the tube land (13 engaged). They pass the motor torque from the tube to the flange |
| Static O-ring | On the tube at x = 70.5-75.5, seals the ring 1 bore |
| Mass | 8.3 kg (pair) |

Load path in the flange: the tube land's rear face (x = 15, R148-159) pushes the flange lip; the flange's rear face bears on the ring 1 seat from R161 to R188. The lip root shears at R159.2 over the lip length 15; the flange body bends between the lip (R153.6) and the seat centroid (FL-4, a strip model that ignores the ring's hoop stiffness and so overstates it).

Seat clamp. The seat stays closed while the compression from F exceeds the tension the jam moment would cause on the far side:

```
N_needed = M · A / S − F,   A = π(R_cb² − 161.25²),  S = π(R_cb⁴ − 161.25⁴)/(4 R_cb)
```

At every case N_needed is far below the 16 × M12 clamp; thrust keeps the seat closed by itself whenever F > M·A/S.

Torque path. 20 kNm passes tube → 4 pins → flange → ring 1 by the friction of the 16 × M12 clamp (μ 0.30 clean: FoS 2.08; μ 0.15 oily: 1.04), with the 2 dowels as backup after any slip (FL-8). Under thrust the seat friction adds μ F r ≈ 0.15 × 613 kN × 0.18 m = 16.6 kNm more, not counted.

| ID | Part | Check | Case | Value | Allowable (basis) | FoS | FoS yield | Required | Status |
|---|---|---|---|---|---|---|---|---|---|
| FL-1 | Split flange | tube land on the flange lip: bearing P/A + M/S | LC3 | 189.8 MPa | 310.5 (0.9 Fy) | 1.64 | 1.82 | 1.00 | ok |
| FL-3 | Split flange | lip root shear at R159.2 over 15 | LC3 | 53.4 MPa | 138.0 (0.4 Fy) | 2.59 | 3.73 | 1.00 | ok |
| FL-4 | Split flange | flange body bending, lip → seat (strip model, hoop stiffness ignored) | LC3 | 102.1 MPa | 207.0 (0.6 Fy) | 2.03 | 3.38 | 1.00 | ok |
| FL-5 | Split flange | flange rear face on the ring 1 seat (net of 16 holes), P/A | LC3 | 30.7 MPa | 261.0 (0.9 Fy (ring 1)) | 8.50 | 9.44 | 1.00 | ok |
| FL-6 | Flange screws | 16 × M12 10.9: clamp needed to keep the seat closed vs preload (70 % proof) | LC3 | 268.2 kN | 783.7 (16 × preload) | 2.92 | – | 1.50 | ok |
| FL-1 | Split flange | tube land on the flange lip: bearing P/A + M/S | LC4 | 213.1 MPa | 310.5 (0.9 Fy) | 1.46 | 1.62 | 1.00 | ok |
| FL-3 | Split flange | lip root shear at R159.2 over 15 | LC4 | 60.1 MPa | 138.0 (0.4 Fy) | 2.30 | 3.31 | 1.00 | ok |
| FL-4 | Split flange | flange body bending, lip → seat (strip model, hoop stiffness ignored) | LC4 | 114.9 MPa | 207.0 (0.6 Fy) | 1.80 | 3.00 | 1.00 | ok |
| FL-5 | Split flange | flange rear face on the ring 1 seat (net of 16 holes), P/A | LC4 | 34.5 MPa | 261.0 (0.9 Fy (ring 1)) | 7.58 | 8.42 | 1.00 | ok |
| FL-6 | Flange screws | 16 × M12 10.9: clamp needed to keep the seat closed vs preload (70 % proof) | LC4 | 296.2 kN | 783.7 (16 × preload) | 2.65 | – | 1.50 | ok |
| FL-7 | Flange screws | torque by clamp friction, μ 0.30 | torque | 20.0 kNm | 41.6 (friction capacity) | 2.08 | – | 1.00 | ok |
| FL-7 | Flange screws | torque by clamp friction, μ 0.15 | torque | 20.0 kNm | 20.8 (friction capacity) | 1.04 | – | 1.00 | ok |
| FL-8 | Flange dowels | 2 × Ø16 hardened dowels alone carry 20 kNm (after slip) | torque | 281.0 MPa | 400.0 (0.4 × ~1,000 (hardened)) | 1.42 | – | 1.00 | ok |
| FL-9 | Anti-rotation pins | 4 × Ø12 radial pins (hardened), tube → flange, shear | torque | 278.0 MPa | 400.0 (0.4 × ~1,000 (hardened)) | 1.44 | – | 1.00 | ok |
| FL-10 | Anti-rotation pins | pin bearing on the tube land (13 engaged) | torque | 201.6 MPa | 301.5 (0.9 Fy (tube)) | 1.50 | 1.66 | 1.00 | ok |

Equations behind the rows:

- **FL-1 LC3**: σ = F/A + M/S, A = π(159² − 148.2²) = 10423, S = 774260 → **189.80 MPa**
- **FL-3 LC3**: τ = F/(2π × 159.2 × 15) → **53.36 MPa**
- **FL-4 LC3**: m = q·Δr = F/(2π r_c) × (r_c − 153.6) = 730 × 21.0; σ = 6m/30² → **102.06 MPa**
- **FL-5 LC3**: σ = (F + P_ch)/A = 827.4 kN / 26942 mm² → **30.71 MPa**
- **FL-6 LC3**: N = M·A/S − F = 87.49e6 × 34125/2793372 − 800.6e3 = 268 kN; clamp 16 × 49.0 kN → **268.18 kN**
- **FL-1 LC4**: σ = F/A + M/S, A = π(159² − 148.2²) = 10423, S = 774260 → **213.08 MPa**
- **FL-3 LC4**: τ = F/(2π × 159.2 × 15) → **60.07 MPa**
- **FL-4 LC4**: m = q·Δr = F/(2π r_c) × (r_c − 153.6) = 822 × 21.0; σ = 6m/30² → **114.91 MPa**
- **FL-5 LC4**: σ = (F + P_ch)/A = 928.2 kN / 26942 mm² → **34.45 MPa**
- **FL-6 LC4**: N = M·A/S − F = 98.03e6 × 34125/2793372 − 901.4e3 = 296 kN; clamp 16 × 49.0 kN → **296.18 kN**
- **FL-7 torque**: T = n F_p μ r = 16 × 49.0 kN × 0.3 × 177 → **20.00 kNm**
- **FL-7 torque**: T = n F_p μ r = 16 × 49.0 kN × 0.15 × 177 → **20.00 kNm**
- **FL-8 torque**: τ = T/(2r)/A = 20e6/(2 × 177)/201 → **280.99 MPa**
- **FL-9 torque**: τ = T/(4 r)/A = 20e6/(4 × 159)/113 → **278.05 MPa**
- **FL-10 torque**: σ = F/(d L) = 31447/(12 × 13) → **201.58 MPa**

## 3.4 Seal carrier, seals and purge

| Item | Value |
|---|---|
| Function | Keeps slurry (up to 1 bar at the face) out of the bearings |
| Carrier | Steel ring, flange Ø273 × 9.4 in the tube's front recess, body in the Ø250 bore to x = 70; 12 × M6 countersunk on Ø262, flush with the plate. Its rear face clamps the front 23228 outer ring through 0.6 mm nominal shims (end play 0.10-0.20) |
| Lip seals | 3 × 170 × 200 × 15 (SKF), at x = 8, 31 and 54, running on the Ø170 journal of the head's sleeve |
| Lantern rings | 2 (x = 23-31 and 46-54), between the seals; the purge port at x = 27 (30°) feeds the first |
| O-rings | 2 on the carrier OD at x = 14-18 and 36-40, either side of the purge port |
| Purge path | Supply line (chapter 05) → Ø8 line in the tube OD groove, x = 600 → 125 → radial and axial Ø5 drillings in the tube → carrier port at x = 27 → lantern space. Purge grease at more than the chamber pressure means any leakage across the outer seal goes outward |
| Labyrinth | 2 rings on the head's journal sleeve run in 2 grooves in the carrier face (x = -8 to 6) |
| Bearing grease | Bearings packed at assembly; no relubrication lines (≈ 1,200-3,600 head revolutions per 5 m drive) |

## 3.5 Spindle

| Item | Value |
|---|---|
| Material | AISI 4140 quenched and tempered, 28-32 HRC (Fy 655, Fu 860) |
| Profile | Ø140 from the nose (x = -133) to the collar; Ø165 × 15 collar at x = 158-173; Ø140 to x = 585 with M140 × 2 for the KM28 at x = 560-585; Ø130 drive end x = 588-715 |
| Head joint | Plain Ø140, x = -133 to -83: B-LOC B400 140 × 190 inside the head's hub ring (chapter 04) |
| Drive joint | Plain Ø130, x = 665-715: B-LOC B400 130 × 180 inside the coupling hub (chapter 05) |
| Threads | M30 in the nose (lift, pull the head on, push it off); M20 centre thread at the drive end |
| Other | MB28 tab slot at x = 567-597 |
| Mass | 100.7 kg |

Bending is highest at the front bearing: the full jam moment passes the head joint and reaches the front 23228, then falls linearly to zero at the rear 23228. The spindle rotates under that moment, so the bending stress reverses every revolution; at LC1 the fillet at the collar is checked for infinite life (SP-4):

```
σ_a = Kt · 32 M / (π d³),  Kt = 1.6 (r 2 fillet, D/d = 165/140)
S_e = 0.5 Fu · k_surface · k_size · k_reliability = 0.5 × 860 × 0.80 × 0.75 × 0.81
```

A jam stops the motor, so the LC2-LC4 moments do not rotate with the shaft for more than a fraction of a revolution; they are static checks (SP-1, SP-2).

| ID | Part | Check | Case | Value | Allowable (basis) | FoS | FoS yield | Required | Status |
|---|---|---|---|---|---|---|---|---|---|
| SP-1 | Spindle | Ø140 at the front 23228: bending + torsion (von Mises) | LC1 | 73.4 MPa | 393.0 (0.6 Fy) | 5.36 | 8.93 | 1.00 | ok |
| SP-2 | Spindle | collar fillet (Ø165 → Ø140, r 2), Kt 1.6 | LC1 | 117.4 MPa | 655.0 (Fy) | 5.58 | 5.58 | 1.00 | ok |
| SP-1 | Spindle | Ø140 at the front 23228: bending + torsion (von Mises) | LC3 | 332.5 MPa | 393.0 (0.6 Fy) | 1.18 | 1.97 | 1.00 | ok |
| SP-2 | Spindle | collar fillet (Ø165 → Ø140, r 2), Kt 1.6 | LC3 | 532.0 MPa | 655.0 (Fy) | 1.23 | 1.23 | 1.00 | ok |
| SP-1 | Spindle | Ø140 at the front 23228: bending + torsion (von Mises) | LC4 | 370.8 MPa | 393.0 (0.6 Fy) | 1.06 | 1.77 | 1.00 | ok |
| SP-2 | Spindle | collar fillet (Ø165 → Ø140, r 2), Kt 1.6 | LC4 | 593.3 MPa | 655.0 (Fy) | 1.10 | 1.10 | 1.00 | ok |
| SP-3 | Spindle | Ø130 drive end (B-LOC 130 zone), torsion at 20 kNm | torque | 46.4 MPa | 262.0 (0.4 Fy) | 5.65 | 8.15 | 1.00 | ok |
| SP-4 | Spindle | fatigue at the collar fillet, LC1 rotating bending (≈ 3,600 rev per drive, design for infinite life) | LC1 | 113.3 MPa | 209.0 (S_e (endurance)) | 1.84 | – | 1.50 | ok |
| SP-5 | Spindle | head moment into the shaft: edge bearing of the couple on 140 × 40 | LC3 | 112.0 MPa | 589.5 (0.9 Fy) | 5.26 | 5.85 | 1.00 | ok |
| SP-6 | Spindle | couple pressure under the head LA vs its grip pressure on the shaft (no lift-off) | LC3 | 89.6 MPa | 223.9 (LA shaft pressure) | 2.50 | – | 1.00 | ok |
| SP-5 | Spindle | head moment into the shaft: edge bearing of the couple on 140 × 40 | LC4 | 125.6 MPa | 589.5 (0.9 Fy) | 4.69 | 5.22 | 1.00 | ok |
| SP-6 | Spindle | couple pressure under the head LA vs its grip pressure on the shaft (no lift-off) | LC4 | 100.5 MPa | 223.9 (LA shaft pressure) | 2.23 | – | 1.00 | ok |
| BR-6 | Spindle collar | front 23228 inner ring on the Ø165 collar (thrust path), contact R73-82.5 | LC3 | 172.5 MPa | 589.5 (0.9 Fy) | 3.42 | 3.80 | 1.00 | ok |
| BR-7 | Backing ring | backing ring on the 29328N shaft washer (to Ø190) | LC3 | 66.3 MPa | 589.5 (0.9 Fy (4140)) | 8.89 | 9.87 | 1.00 | ok |
| BR-6 | Spindle collar | front 23228 inner ring on the Ø165 collar (thrust path), contact R73-82.5 | LC4 | 194.2 MPa | 589.5 (0.9 Fy) | 3.04 | 3.37 | 1.00 | ok |
| BR-7 | Backing ring | backing ring on the 29328N shaft washer (to Ø190) | LC4 | 74.7 MPa | 589.5 (0.9 Fy (4140)) | 7.89 | 8.77 | 1.00 | ok |

Equations behind the rows:

- **SP-1 LC1**: σ = 32M/(πd³) = 71, τ = 16T/(πd³) = 11.1 with M = 19.07 kNm, T = 6 kNm; σ_vm = √(σ² + 3τ²) → **73.38 MPa**
- **SP-2 LC1**: σ_peak = Kt σ_vm = 1.6 × 73 → **117.40 MPa**. peak stress at a fillet: local; static strength of a ductile shaft is set by SP-1, Kt enters fatigue (SP-4)
- **SP-1 LC3**: σ = 32M/(πd³) = 326, τ = 16T/(πd³) = 37.1 with M = 87.87 kNm, T = 20 kNm; σ_vm = √(σ² + 3τ²) → **332.47 MPa**
- **SP-2 LC3**: σ_peak = Kt σ_vm = 1.6 × 332 → **531.96 MPa**. peak stress at a fillet: local; static strength of a ductile shaft is set by SP-1, Kt enters fatigue (SP-4)
- **SP-1 LC4**: σ = 32M/(πd³) = 365, τ = 16T/(πd³) = 37.1 with M = 98.37 kNm, T = 20 kNm; σ_vm = √(σ² + 3τ²) → **370.78 MPa**
- **SP-2 LC4**: σ_peak = Kt σ_vm = 1.6 × 371 → **593.25 MPa**. peak stress at a fillet: local; static strength of a ductile shaft is set by SP-1, Kt enters fatigue (SP-4)
- **SP-3 torque**: τ = 16T/(πd³) = 16 × 20e6/(π × 130³) → **46.36 MPa**
- **SP-4 LC1**: σ_a = Kt 32M/(πd³) = 1.6 × 32 × 19.07e6/(π × 140³); S_e = 0.5 Fu k_a k_b k_c = 0.5 × 860 × 0.80 × 0.75 × 0.81 = 209 → **113.28 MPa**
- **SP-5 LC3**: F_c = M/139 = 627 kN; σ = F_c/(140 × 40) → **112.02 MPa**
- **SP-6 LC3**: p = F_c/(140 × 50) vs p_shaft = p_hub × 190/140 = 224 → **89.61 MPa**
- **SP-5 LC4**: F_c = M/139 = 703 kN; σ = F_c/(140 × 40) → **125.60 MPa**
- **SP-6 LC4**: p = F_c/(140 × 50) vs p_shaft = p_hub × 190/140 = 224 → **100.48 MPa**
- **BR-6 LC3**: σ = F/[π(82.5² − 73²)] → **172.51 MPa**
- **BR-7 LC3**: σ = F/[π(95² − 72²)] → **66.35 MPa**
- **BR-6 LC4**: σ = F/[π(82.5² − 73²)] → **194.22 MPa**
- **BR-7 LC4**: σ = F/[π(95² − 72²)] → **74.70 MPa**

## 3.6 Nut, lock washer, backing ring, spacer

| Part | Value |
|---|---|
| KM28 + MB28 | Lock nut on M140 × 2 at x = 560-585 and its tab washer; clamp the rear 23228 inner ring, spacer and 29328N shaft washer against the backing ring and collar. They see only the small forward loads (pulling the head off; chamber pressure on the Ø140 nose, 0.1 × π/4 × 140² = 1.5 kN) |
| Backing ring | Ø190 × Ø140 × 15 (4140): supports the 29328N shaft washer out to Ø190, as SKF asks (d_a min 185); the Ø165 collar alone would not |
| Spacer sleeve | Ø160 × Ø140 between the 29328N shaft washer and the rear 23228 inner ring |
