Sam-Indyk/uatxcavators-tbm/docs/manual-04-cutterhead.md

# Design manual Rev I · 04 Cutterhead

UATXcavators DN600 slurry microTBM (micro tunnel boring machine). Revision I, 2026-10-28. Generated by `tools/make_manual.py` from the model and calculation scripts in the repo; edit those, not this file.

Units mm, N, MPa (kN, kNm in tables). x = 0 at the ring 1 front face, +x rearward. Clock positions are seen from the front, looking rearward: 0° = 12 o'clock, 90° = 3 o'clock.

The cutterhead is a welded, machined head that clamps onto the spindle nose with a keyless locking assembly. Calculations: `src/calc_revI.py` rows CH, SP-5, SP-6.

Parts and masses (model):

| Key | Part | kg |
|---|---|---|
| spider | Spider plate 50.8, one waterjet piece | 47.84 |
| gussets | Gussets ×8, 25 thk, tab-and-slot | 22.35 |
| hubring | LA hub ring Ø340 × Ø190 × 50.8 | 24.51 |
| sleeve | Journal sleeve Ø170 + labyrinth rings | 24.92 |
| headwelds | Head welds (12 mm gusset-to-arm, 8 mm hub) | 2.00 |
| holders | Bit holders ×17 (spider), 30 × 24 × 20 | 1.90 |
| carbide | Carbide drag bits ×17 (spider) | 0.71 |
| la | Locking assembly 140 × 190 × 50 | 4.53 |
| lascrews | Locking assembly screws 12 × M12 | 0.60 |
| cap | Centre cap 30 thk + cone | 12.50 |
| capholders | Bit holders ×7 (cap) | 0.78 |
| capcarbide | Carbide drag bits ×7 (cap) | 0.29 |
| blades | Centre cone carbide blades ×3 | 0.05 |
| capscrews | Cap screws 8 × M8 countersunk | 0.14 |

Head mass 143.1 kg, CG x = -117.

## 4.1 Structure

| Part | Value |
|---|---|
| Spider plate | One waterjet piece from 2 in A572 Gr 50 (50.8 thick): 8 arms 76 wide from R150 to R310 at 45° spacing plus the central ring (R100-170); tab slots for the gussets; Ø270 pocket 30 deep for the centre cap; 8 × M8 tapped holes on Ø216. Arm front face x = -183.8, back face x = -133.0 |
| Gussets | 8 × 25 thick A572 Gr 50, one in the plane of each arm, 125 deep at R165; 2 tabs each drop through slots in the spider (tab-and-slot sets position and squareness without a jig); inner edges bear on the hub ring |
| Hub ring | Ø340 × Ø190 × 50.8 A572 Gr 50, x = -133 to -83; holds the locking assembly. OD ≥ 320 for the 165 MPa hub pressure (CH-2) |
| Journal sleeve | Ø140 bore; Ø250 body x = -83 to -8; Ø170 seal journal x = -8 to 70 (the lip seals run on it); 2 labyrinth rings at its rear shoulder; welded into the head and machined with it. Journal surface for lip seals: Ra 0.2-0.8 µm, ≥ 45 HRC (hard-chrome or a pressed hardened ring) |
| Welds | Gusset-to-arm 2 × 12 mm fillets; gusset-to-hub and gusset-to-sleeve 8 mm; ring fillets 8 mm at the hub ring and the arm back face; tab plug welds |
| Machining | One lathe setup after welding: Ø190 locking-assembly bore, Ø140 bore, Ø170 journal, rear face, labyrinth rings |
| Locking assembly | Fenner B-LOC B400 140 × 190 (part B401140): 12 × M12, 123 Nm; rating 28.16 kNm, 402 kN axial; screws face forward under the centre cap |
| Centre cap | 30 thick A572 Gr 50 in the spider pocket, 8 × M8 countersunk; cut to clear the arm-0 and arm-3 holders; carries 7 inner bits and the centre cone with 3 carbide blades; 2 × M12 holes to pull it out |

## 4.2 Bits

24 trapezoid carbide drag bits (base 22, tip 12.7, 22 tall, 14 thick) on 30 × 24 × 20 holders at the arm leading edges; bit tips at x = -225.8. 3 bits share the gauge track at R308.65; 21 single tracks follow at 12.7 spacing down to R41.95; tracks spiral across the arms ((3k + 1) mod 8) so neighbouring tracks sit on different arms.

| # | Track R | Arm (°) |  | On |
|---|---|---|---|---|
| 1 | 308.65 | 0 | gauge | spider arm |
| 2 | 308.65 | 135 | gauge | spider arm |
| 3 | 308.65 | 225 | gauge | spider arm |
| 4 | 295.95 | 180 |  | spider arm |
| 5 | 283.25 | 315 |  | spider arm |
| 6 | 270.55 | 90 |  | spider arm |
| 7 | 257.85 | 225 |  | spider arm |
| 8 | 245.15 | 0 |  | spider arm |
| 9 | 232.45 | 135 |  | spider arm |
| 10 | 219.75 | 270 |  | spider arm |
| 11 | 207.05 | 45 |  | spider arm |
| 12 | 194.35 | 180 |  | spider arm |
| 13 | 181.65 | 315 |  | spider arm |
| 14 | 168.95 | 90 |  | spider arm |
| 15 | 156.25 | 225 |  | spider arm |
| 16 | 143.55 | 0 |  | spider arm |
| 17 | 130.85 | 135 |  | spider arm |
| 18 | 118.15 | 270 |  | cap |
| 19 | 105.45 | 45 |  | cap |
| 20 | 92.75 | 180 |  | cap |
| 21 | 80.05 | 315 |  | cap |
| 22 | 67.35 | 90 |  | cap |
| 23 | 54.65 | 225 |  | cap |
| 24 | 41.95 | 0 |  | cap |

Σ r = 4,473.9 mm. With the stall torque shared equally by force, each bit carries F_t = T / Σr = 11.58e6 / 4,474 = 2.59 kN tangential; at LC3 each carries F/24 = 33.4 kN axial. A single bit that catches an obstruction while the motor stalls carries F_t = T/R: 11.58e6 / 296 = 39.1 kN at the outermost single track. That sizes the holder weld (CH-7): 14 mm fillet all round. The weld group of a 30 × 24 holder with the force along the 24 side, 31 above the arm face:

```
A_w = 2 (b + d) · a,   S_w = (b d + d²/3) · a,   a = 0.707 × 14,  b = 30, d = 24
f = √[(F_t / A_w)² + (31 F_t / S_w)²]
```

The three gauge holders at R308.65 overhang the arm end (R310) by 13.65 of their 30 mm length; only 16.35 is welded. That holder does not meet the check (CH-7, gauge) and is an open item for the cutterhead layout.

## 4.3 Arms and gussets

Thrust reaches the hub through 8 arm + gusset T-sections. At LC3 each arm carries its share of F plus the jam-moment share at the bit centroid R_c = 238:

```
F_arm = F/8 + 2M/(8 R_c);    M_arm = F_arm (R_c − 165);    σ = M_arm c / I   (T-section: arm 76 × 50.8 + gusset 25 × 125)
gusset-to-arm fillets: q = V Q / I,  τ = q / (2 × 0.707 × 12)
```

## 4.4 Head joint on the spindle

The locking assembly carries the torque; the head moment is carried by a couple between the locking-assembly zone and the journal sleeve's rear bore fit, 139 apart (SP-5). The couple pressure under the locking assembly stays below its grip pressure on the shaft (SP-6), so the joint does not open. Head thrust does not pass through the locking assembly: it goes by contact from the hub ring into the journal sleeve and on to the front 23228 inner ring (CH-8).

Head removal: centre cap off (2 × M12 pull holes) → release the 12 locking-assembly screws → M30 push-off screw against the spindle nose.

| ID | Part | Check | Case | Value | Allowable (basis) | FoS | FoS yield | Required | Status |
|---|---|---|---|---|---|---|---|---|---|
| CH-1 | Head locking assembly | B-LOC B400 140 × 190: 20 kNm vs rating | torque | 20.0 kNm | 28.2 (catalogue Mt) | 1.41 | – | 1.00 | ok |
| CH-2 | Head hub ring | hub ring OD for the LA hub pressure (Fenner, C = 1) | geometry | 319.8 mm | 340.0 (fitted OD) | 1.06 | – | 1.00 | ok |
| CH-3 | Cutterhead arm | arm + gusset T-section at R165, thrust bending | LC3 | 85.2 MPa | 207.0 (0.6 Fy) | 2.43 | 4.05 | 1.00 | ok |
| CH-4 | Cutterhead arm | gusset-to-arm fillets 2 × 12, shear flow | LC3 | 94.0 MPa | 144.6 (0.3 × 482) | 1.54 | 2.46 | 1.00 | ok |
| CH-3 | Cutterhead arm | arm + gusset T-section at R165, thrust bending | LC4 | 95.7 MPa | 207.0 (0.6 Fy) | 2.16 | 3.61 | 1.00 | ok |
| CH-4 | Cutterhead arm | gusset-to-arm fillets 2 × 12, shear flow | LC4 | 105.6 MPa | 144.6 (0.3 × 482) | 1.37 | 2.19 | 1.00 | ok |
| CH-5 | Cutterhead arm | arm + gusset at R165, torque bending (weak axis) | torque | 12.4 MPa | 207.0 (0.6 Fy) | 16.72 | 27.86 | 1.00 | ok |
| CH-6 | Centre cap | 30 thk cap, 7 bits on a Ø200 opening (simply supported) | LC3 | 102.2 MPa | 207.0 (0.6 Fy) | 2.03 | 3.38 | 1.00 | ok |
| CH-7 | Bit holders | holder at R296 (outermost non-gauge track), 14 mm fillet all round: one bit takes the stall torque 11.58 kNm | jam | 139.3 MPa | 144.6 (0.3 × 482) | 1.04 | 1.66 | 1.00 | ok |
| CH-7 | Bit holders | gauge holder (16.35 of 30 over the arm end R310), 14 mm fillet: one bit takes the stall torque 11.58 kNm | jam | 206.5 MPa | 144.6 (0.3 × 482) | 0.70 | 1.12 | 1.00 | **below** |
| CH-8 | Journal sleeve | sleeve rear face on the front 23228 inner ring (head thrust by contact) | LC3 | 172.5 MPa | 310.5 (0.9 Fy) | 1.80 | 2.00 | 1.00 | ok |
| CH-8 | Journal sleeve | sleeve rear face on the front 23228 inner ring (head thrust by contact) | LC4 | 194.2 MPa | 310.5 (0.9 Fy) | 1.60 | 1.78 | 1.00 | ok |

Equations behind the rows:

- **CH-1 torque**: rating 28.16 kNm (catalogue) → **20.00 kNm**
- **CH-2 geometry**: D_N = D √[(Fy + p C)/(Fy − p C)] = 190 √[(345 + 165)/(345 − 165)] = 320; fitted 340 → **319.82 mm**
- **CH-3 LC3**: F_arm = F/8 + 2M/(8 R_c) = 192 kN; M = F_arm (238 − 165); σ = M c/I, I = 1.82e+07 → **85.15 MPa**
- **CH-4 LC3**: q = V Q/I = 191580 × 151810/1.82e+07; τ = q/(2 × 0.707 × 12) → **93.95 MPa**
- **CH-3 LC4**: F_arm = F/8 + 2M/(8 R_c) = 215 kN; M = F_arm (238 − 165); σ = M c/I, I = 1.82e+07 → **95.69 MPa**
- **CH-4 LC4**: q = V Q/I = 215287 × 151810/1.82e+07; τ = q/(2 × 0.707 × 12) → **105.58 MPa**
- **CH-5 torque**: σ = F_t (238 − 165)/S, F_t = T/(8 × 238) → **12.38 MPa**
- **CH-6 LC3**: σ = 3(3 + ν)P/(8π t²), P = 7/24 F → **102.20 MPa**
- **CH-7 jam**: F_t = T/R = 11.58e6/295.95 = 39.1 kN; M = 31 F_t; f = √[(F_t/A_w)² + (M/S_w)²], A_w = 1069, S_w = 9027 → **139.26 MPa**. a bit nearer the centre sees F_t = T/R: an obstruction there is limited by what the obstruction can carry
- **CH-7 jam**: F_t = T/R = 11.58e6/308.65 = 37.5 kN; M = 31 F_t; f = √[(F_t/A_w)² + (M/S_w)²], A_w = 799, S_w = 5784 → **206.46 MPa**. gauge holder overhangs the arm: open item (cutterhead layout)
- **CH-8 LC3**: σ = F/[π(82.5² − 73²)] → **172.51 MPa**
- **CH-8 LC4**: σ = F/[π(82.5² − 73²)] → **194.22 MPa**
