Sam-Indyk/uatxcavators-tbm/docs/manual-05-drive.md

# Design manual Rev I · 05 Drive

UATXcavators DN600 slurry microTBM (micro tunnel boring machine). Revision I, 2026-10-28. Generated by `tools/make_manual.py` from the model and calculation scripts in the repo; edit those, not this file.

Units mm, N, MPa (kN, kNm in tables). x = 0 at the ring 1 front face, +x rearward. Clock positions are seen from the front, looking rearward: 0° = 12 o'clock, 90° = 3 o'clock.

The drive is a hydraulic motor on a bell-housing adapter bolted to the cartridge rear face, connected to the spindle by a flexible jaw coupling. Calculations: `src/calc_revI.py` rows DR.

Parts and masses (model; motor at its catalogue mass):

| Key | Part | kg |
|---|---|---|
| adapter | Drive adapter weldment (bell housing) | 44.25 |
| adwelds | Adapter welds | 0.86 |
| adscrews | Adapter screws 12 × M16 10.9 | 1.48 |
| addowels | Adapter dowels 3 × Ø16 | 0.20 |
| guards | Window guards ×2, 3 mm | 1.43 |
| guardscr | Guard screws 8 × M6 | 0.05 |
| gsupply | Seal-purge supply line, part 1 (R209) | 0.34 |
| gsupply2 | Seal-purge supply line, part 2 (to R185 and the surface) | 0.26 |
| hub1 | ROTEX 160 hub, spindle side (steel, Ø180 bore) | 26.17 |
| hub1la | B-LOC B400 130 × 180 locking assembly | 4.21 |
| hub1scr | Hub locking-assembly screws 10 × M12 | 0.55 |
| elast | ROTEX 160 spider, 64 ShD | 0.54 |
| hub2 | ROTEX 160 hub, motor side (W90 × 3 × 28 spline) | 24.08 |
| mshaft | Motor shaft W90 × 3 × 28 | 4.91 |
| motor | Hydraulic motor, Poclain MS18 2,812 cc (body approximate) | 152.00 |
| mbolts_r | Motor housing bolts | 0.72 |
| mplate | Motor pilot plate Ø400 × 20 (Ø300 spigot, Ø282 recess) | 11.56 |
| mbolts | Motor screws 8 × M20 × 65 10.9 | 1.98 |
| hoses | Hoses A, B (3/4 in) + case drain | 4.36 |

Drive mass 279.9 kg, CG x = 922.

## 5.1 Motor and hydraulics

| Item | Value |
|---|---|
| Motor | Poclain MS18 shaft motor, 2A50 bearing support; 2,812 cm³/rev; max pressure 400 bar; 112-152 kg (152 used) |
| Interfaces | Pilot Ø282; shaft spline W90 × 3 × 28 (DIN 5480); mounting assumed 8 × M20 on Ø335; body diameters and shaft length are placeholders until the certified drawing |
| Torque | T = V_g p / (2π) = 2,812 × p / (2π × 10) = 44.71 Nm/bar (theoretical) |
| LC1, 6 kNm | 134 bar theoretical, 141 bar at η 0.95 |
| Interlock, 10 kNm | 235.4 bar at η 0.95 |
| Pump relief (rules 4.c.3.2) | 259.0 bar → stall torque 11.58 kNm |
| Flow at 12 rpm | Q = V_g n = 2.812 L × 12 = 33.7 L/min + leakage |
| Shaft power | P = 2π n T: 7.5 kW at 6 kNm, 12.6 kW at 10 kNm |
| Hoses | A and B 3/4 in and the case drain from the motor rear, back through the thrust ring bore and the casing string |

## 5.2 Adapter (bell housing)

| Item | Value |
|---|---|
| Front flange | 25 thick, Ø380, A572 Gr 50; Ø250 pilot (x = 600-615) into the cartridge bore; 12 × M16 × 50 class 10.9 on Ø280 into the tube's rear face, heads inside the bell, 248 Nm; 3 × Ø16 dowels |
| Tube | 14 in XS pipe Ø355.6 × 12.7 (A106 Gr B), x = 640-827; 2 windows 140 × 130 at 3 and 9 o'clock (x = 665-805) for the adapter screws and the coupling |
| Rear flange | 30 thick, Ø400, A572 Gr 50, x = 827-857; Ø300 H8 bore (the Ø290 coupling hubs pass through it); 8 × M20 tapped through |
| Welds | 8 mm fillets outside and 6 mm inside at both flanges; machined after welding |
| Mass | 45.1 kg |

## 5.3 Coupling

| Item | Value |
|---|---|
| Type | KTR ROTEX 160 jaw coupling, 64 Shore D polyurethane spider, steel hubs |
| Rating (KTR catalogue) | T_KN 24,000 Nm (64 ShD; 19,200 with 98 ShA); T_Kmax = 2 T_KN = 48,000 Nm |
| Size | D 290, E 75 (gap between hub bodies), s 9, spider width b 57, spider bore d_H 190, max finish bore 185 |
| Misalignment (64 ShD, 1,500 rpm values) | Radial 0.46, angular 1.1°, axial −2.5/+5.7. At 12 rpm the catalogue values are conservative |
| Hub 1 (spindle) | Steel, 42CrMo4+QT (KTR option), body x = 660-720, Ø180 H7 bore for a Fenner B-LOC B400 130 × 180 (B401130: 23,771 Nm, M12 × 35 screws at 123 Nm, 38 contact length) |
| Hub 2 (motor) | Steel; jaw disc x = 795-825 Ø290, neck Ø140 to x = 867; W90 × 3 × 28 internal spline, 72 engaged on the motor shaft |
| Motor shaft | Projects 110 from the mounting face (placeholder) to x = 767, 28 into the spider bore (allowed: shafts may enter the spider) |

Selection:

```
Nominal:  T_N · S_t = 11.58 kNm (stall at the relief) × 1.4 (temperature factor, ≤ 60 °C) = 16.21 kNm ≤ T_KN 24.0
Maximum:  T_d · S_t = 20 × 1.4 = 28 kNm ≤ T_Kmax 48
Bore:     hub 1 holds the Ø180 locking assembly → max finish bore ≥ 180 → ROTEX 160 (185); ROTEX 140 stops at 160
```

Why a flexible coupling and not a rigid splined sleeve. The spindle and the motor shaft each run in their own bearings. Under the jam moment the spindle bends between its bearings and its rear end tilts:

```
θ = M L / (6 E I) = 87.9e6 × 400 / (6 × 200,000 × 1.89e+07) = 1.55e-03 rad   (LC3)
offset at the coupling centre (x = 757.5): δ = θ × (757.5 − 514) = 0.38 mm
```

The spindle's overhang behind the rear bearing has a stiffness k = 3EI / (a² (L + a)) = 297 kN/mm, so forcing a rigid connection through that offset would put about 112 kN into the motor's own bearings. The ROTEX takes the offset in its spider (0.46 mm capacity; check DR-7). A one-piece splined sleeve was considered at the start of Rev I and dropped for this reason.

Assembly: hub 1 goes in through the Ø300 rear bore before the motor, and its 10 locking-assembly screws are tightened through the Ø190 spider bore before the spider goes in. The motor arrives with the pilot plate and hub 2 already fitted.

## 5.4 Motor pilot plate

| Item | Value |
|---|---|
| Function | Carries the motor's Ø282 spigot. It lets the adapter bore open to Ø300 so the Ø290 hubs pass |
| Plate | Ø400 × 20, A572 Gr 50, x = 857-877; Ø300 f7 × 8 spigot into the adapter bore; Ø282 H8 × 6 recess for the motor spigot; Ø260 through bore; 8 × Ø22 holes |
| Fixing | Clamped between motor and adapter by the 8 motor screws, M20 × 65 class 10.9, 484 Nm. Torque crosses two friction faces (motor-plate, plate-adapter), each with the full clamp |
| Mass | 11.6 kg |

## 5.5 Guards

Rules 3.a.1: rotating parts guarded. Two curved 3 mm steel plates cover the windows (x = 649-817, ±29° about 3 and 9 o'clock), each held by 4 × M6 × 12 into tapped holes in the adapter tube. With the guards on, the coupling is enclosed by the adapter, the pilot plate and the motor.

## 5.6 Seal-purge supply route

| Segment | Route | Clearance |
|---|---|---|
| Part 1 | From the end of the groove line (x = 600) radially out to R209 at 30°, then rearward at R209 to x = 1095 | Adapter rear flange (R200): 4; motor flange (R192.5): 11.5; motor body step (R185, x = 1,000-1,120): 19 |
| Part 2 | Down to R185 between x = 1095 and 1150, then rearward at R185 through the thrust ring bore to the surface | Thrust ring bore (R200): 10; motor rear (R140): 40 |

Part 2 is fitted after the motor (the motor's R185 step passes x > 1,150 on the way in). In Rev H the line ran at R209 through the thrust ring annulus (5.98 cm³ interference).

| ID | Part | Check | Case | Value | Allowable (basis) | FoS | FoS yield | Required | Status |
|---|---|---|---|---|---|---|---|---|---|
| DR-1 | Adapter tube | 14 in XS (A106 Gr B) torsion at 20 kNm, windows (net 76 %, Kt 3) | torque | 33.7 MPa | 96.4 (0.4 Fy) | 2.86 | 4.13 | 1.00 | ok |
| DR-2 | Adapter screws | 12 × M16 10.9 on Ø280, slip μ 0.30 | torque | 20.0 kNm | 46.0 (friction capacity) | 2.30 | – | 1.00 | ok |
| DR-2 | Adapter screws | 12 × M16 10.9 on Ø280, slip μ 0.15 | torque | 20.0 kNm | 23.0 (friction capacity) | 1.15 | – | 1.00 | ok |
| DR-3 | Adapter dowels | 3 × Ø16 dowels alone (after slip) | torque | 20.0 kNm | 37.2 (dowel shear capacity) | 1.86 | – | 1.00 | ok |
| DR-4 | Motor screws | 8 × M20 10.9 on Ø335, slip μ 0.30 (each of the two faces of the pilot plate) | torque | 20.0 kNm | 57.2 (friction capacity) | 2.86 | – | 1.00 | ok |
| DR-4 | Motor screws | 8 × M20 10.9 on Ø335, slip μ 0.15 (each of the two faces of the pilot plate) | torque | 20.0 kNm | 28.6 (friction capacity) | 1.43 | – | 1.00 | ok |
| DR-5 | Coupling ROTEX 160 | nominal torque: motor stall at the 259 bar relief × temperature factor S_t 1.4 (≤ 60 °C) | torque | 16.2 kNm | 24.0 (T_KN) | 1.48 | – | 1.00 | ok |
| DR-6 | Coupling ROTEX 160 | maximum torque: 20 kNm design × S_t 1.4 | torque | 28.0 kNm | 48.0 (T_Kmax) | 1.71 | – | 1.00 | ok |
| DR-7 | Coupling ROTEX 160 | radial offset at the coupling from spindle bending vs 0.46 mm (64 ShD) | LC1 | 0.08 mm | 0.5 (KTR ΔKr) | 5.60 | – | 1.00 | ok |
| DR-7 | Coupling ROTEX 160 | radial offset at the coupling from spindle bending vs 0.46 mm (64 ShD) | LC3 | 0.38 mm | 0.5 (KTR ΔKr) | 1.22 | – | 1.00 | ok |
| DR-8 | Drive locking assembly | B-LOC B400 130 × 180 on the spindle end: 20 kNm vs rating | torque | 20.0 kNm | 23.8 (catalogue Mt) | 1.19 | – | 1.00 | ok |
| DR-9 | Drive locking assembly | same, at the motor stall torque (259 bar relief) | torque | 11.6 kNm | 23.8 (catalogue Mt) | 2.05 | – | 1.00 | ok |
| DR-10 | Coupling hub 1 | hub OD for the B400 130 × 180 hub pressure (42CrMo4+QT, C = 1) | geometry | 261.1 mm | 290.0 (hub OD) | 1.11 | – | 1.00 | ok |
| DR-11 | Motor spline W90 × 3 × 28 | flank pressure in the motor hub at 20 kNm | torque | 112.6 MPa | 405.0 (0.9 Fy (hub)) | 3.60 | 4.00 | 1.00 | ok |
| DR-12 | Motor screws | motor overhang at 3 g: M20 tension added vs preload | transport | 1.29 kN | 142.3 (preload) | 110.47 | – | 1.00 | ok |
| DR-13 | Motor circuit | pump relief vs rules 4.c.3.2 (operating + 10 % or + 20 bar, whichever is higher) | hydraulic | 259.0 bar | 400.0 (motor max pressure (MS18)) | 1.54 | – | 1.00 | ok |

Equations behind the rows:

- **DR-1 torque**: τ = T/(2π r² t) / 0.76 × 3 = 8.5/0.76 × 3 → **33.66 MPa**
- **DR-2 torque**: T = 12 × 91.2 kN × 0.3 × 140 → **20.00 kNm**
- **DR-2 torque**: T = 12 × 91.2 kN × 0.15 × 140 → **20.00 kNm**
- **DR-3 torque**: T = 3 × 0.4 × 1,100 × 201 × 140 → **20.00 kNm**
- **DR-4 torque**: T = 8 × 142.3 kN × 0.3 × 167.5 → **20.00 kNm**
- **DR-4 torque**: T = 8 × 142.3 kN × 0.15 × 167.5 → **20.00 kNm**
- **DR-5 torque**: T_N S_t = 11.58 × 1.4 = 16.21 kNm vs T_KN 24.0 → **16.21 kNm**
- **DR-6 torque**: T_max S_t = 20 × 1.4 = 28 kNm vs T_Kmax 48 → **28.00 kNm**
- **DR-7 LC1**: δ = θ (x_c − x_rb) = M L/(6EI) × (757.5 − 514) = 3.37e-04 × 243.5 → **0.08 mm**
- **DR-7 LC3**: δ = θ (x_c − x_rb) = M L/(6EI) × (757.5 − 514) = 1.55e-03 × 243.5 → **0.38 mm**
- **DR-8 torque**: rating 23.77 kNm (catalogue) → **20.00 kNm**
- **DR-10 geometry**: D_N = 180 √[(450 + 160)/(450 − 160)] = 261; hub Ø290 → **261.06 mm**. p_hub 160 MPa scaled from the 140 row: confirm
- **DR-11 torque**: p = 2T/(d_m h L z k_φ) = 2 × 20e6/(87.0 × 2.7 × 72 × 28 × 0.75) → **112.62 MPa**
- **DR-12 transport**: ΔF = 4M/(n D) = 4 × 0.86e6/(8 × 335) → **1.29 kN**
- **DR-13 hydraulic**: p_op = T/(V_g η) = 10,000/(44.71 × 0.95) = 235.4 bar; relief = p_op + max(0.1 p_op, 20) = 259.0 bar; stall torque at relief 11.58 kNm → **258.98 bar**. the relief also caps the jam torque used in LC2-LC4 side force and the coupling / LA checks
