Sam-Indyk/uatxcavators-tbm/docs/manual-07-assembly-lifting.md

# Design manual Rev I · 07 Assembly, lifting and handling

UATXcavators DN600 slurry microTBM (micro tunnel boring machine). Revision I, 2026-10-28. Generated by `tools/make_manual.py` from the model and calculation scripts in the repo; edit those, not this file.

Units mm, N, MPa (kN, kNm in tables). x = 0 at the ring 1 front face, +x rearward. Clock positions are seen from the front, looking rearward: 0° = 12 o'clock, 90° = 3 o'clock.

Assembly order as animated in the viewer (`src/asm_revI.py`), the fixtures it needs, the lift plan the rules ask for, and transport loads. Calculations: `src/calc_revI.py` rows LF.

## 7.1 Assembly sequence

57 steps in 7 phases. Orientation: FU = front up (machine axis vertical, cutting face up), RU = rear up, H = horizontal.

| # | Phase | Step | What happens |
|---|---|---|---|
| 1 | 1 · Shell weldment | Shell on riser blocks | Shield shell Ø609.6 × 12.7 × 1,285. Both ends faced on the lathe first; the front end face is the depth datum. Stands on its rear end on three 110 mm riser blocks on a flat table (the slurry pipes will stand 98 mm proud of the rear end). |
| 2 | 1 · Shell weldment | Gauge legs | Three legs, 1,157 long (tube with ground ends), stand on the table inside the shell at R255, 120° apart. Their tops set ring 1's seat 128.0 from the front end. |
| 3 | 1 · Shell weldment | Ring 1 + slurry pipes (bench sub-weldment) onto the legs | Ring 1 is finished before welding: waterjet blank from 4.5 in A572 Gr 42, Blanchard-ground to 110, lathe for the Ø384 × 30 counterbore and Ø318.5 bore, 16 × M12 tapped. On the bench, the Ø76.2 × 6.35 slurry pipes (1,255 long) are pushed through ring 1 at 12 and 6, welded at the front face (6 × 45° bevel) and at the rear face (6 mm fillet); seat flatness re-checked (≤ 0.05). The sub-weldment is lowered onto the legs, pipes down; 3 shims in the 0.5 mm OD gap centre it. |
| 4 | 1 · Shell weldment | Weld ring 1 | Depth 128.0 ± 0.5 at 4 points. Tack 8 places, then the 14 mm fillet from the front in 4 opposed quadrants. Preheat 66 °C, interpass ≤ 250 °C. At 12 and 6 the ring fillet runs into the pipe seal weld (8.6 mm apart). After cooling: seat flatness ≤ 0.05, depth re-checked. |
| 5 | 1 · Shell weldment | Legs out | Shell lifted off the blocks; legs removed through the rear end between the pipes; shell set back on the blocks. |
| 6 | 1 · Shell weldment | Pipe saddles | Saddles welded in under the pipes from the open rear end (x = 950, 207 mm in from the rear). |
| 7 | 1 · Shell weldment | Pressure taps | Two Ø12 tap tubes at 3 and 9 o'clock, welded flush with the plate. |
| 8 | 1 · Shell weldment | Anti-roll fins | Four fins, 20 × 70 × 990 plate, at 1, 3, 9 and 11 o'clock (clear of the launch rails at 5 and 7 and the lubrication ports at 10, 12 and 2). 30° lead ramp with a knife edge, 45° tail ramp, 2 × 8 mm fillets. |
| 9 | 1 · Shell weldment | Lifting bosses | Four Ø60 × 40 bosses set flush into Ø60 holes at 12 o'clock ± 18°, x = 155 and 699 (either side of the machine CG at x ≈ 423), full-penetration bevel groove weld from outside with the boss as backing. M20 × 32 tapped for Crosby HR-125M hoist rings (WLL 2,150 kg each); plugged with M20 set screws while tunnelling. Each boss is stencilled 'LIFT 700 kg'. |
| 10 | 2 · Cutterhead weldment | Spider plate | One waterjet piece from 2 in A572-50: 8 arms, centre, tab slots, cap pocket (milled 30 deep). Face down on the welding table. |
| 11 | 2 · Cutterhead weldment | Hub ring | Locking-assembly hub ring Ø340 × Ø190 × 50.8 (A572-50; Ø320 minimum for 165 MPa hub pressure), centred on a fixture pin through the spider centre. It goes on before the gussets: the gussets' inner edges step in to R125 above it, so it cannot be dropped in afterwards. |
| 12 | 2 · Cutterhead weldment | Gussets into the slots | Eight 25 mm gussets. Two tabs on each drop through the spider's slots, which sets position and squareness without a jig; the inner edges bear on the hub ring. |
| 13 | 2 · Cutterhead weldment | Journal sleeve | Journal sleeve drops into the R125 opening between the gusset edges and stands on the hub ring. Head thrust passes from the hub ring into the sleeve by contact, not through the weld. |
| 14 | 2 · Cutterhead weldment | Weld and machine the head | Gusset-to-spider 2 × 12 mm fillets, gusset-to-hub and gusset-to-sleeve 8 mm, tab plug welds. Then one lathe setup: Ø190 bore for the locking assembly, Ø140 bore, Ø170 seal journal, rear face, labyrinth rings. |
| 15 | 2 · Cutterhead weldment | Turn the head over | Head turned face-up. |
| 16 | 2 · Cutterhead weldment | Bit holders and carbide | 17 holders welded to the arms; trapezoid carbide bits brazed in. 3 bits share the gauge track at R308.65. |
| 17 | 2 · Cutterhead weldment | Centre cap | Centre cap, 30 mm plate, cut to clear the arm-0 and arm-3 holders. Carries the 7 inner bits (R ≤ 118) and the centre cone with 3 carbide blades. |
| 18 | 3 · Bearing module (bench) | Spindle on its nose | Spindle (Ø140, 4140 QT) stands on its nose on a stand. |
| 19 | 3 · Bearing module (bench) | Backing ring | Backing ring Ø190 dropped over the rear end onto the collar (supports the 29328 shaft washer out to Ø190; SKF da min 185). |
| 20 | 3 · Bearing module (bench) | 29328N shaft washer + rollers | Shaft washer with its roller set heated to 110 °C on the induction heater, dropped onto the backing ring, held down until cool. |
| 21 | 3 · Bearing module (bench) | Turn the spindle over | Spindle turned nose-up; it now stands on its drive end. |
| 22 | 3 · Bearing module (bench) | Front 23228 | Front 23228 heated to 110 °C and dropped over the nose onto the collar. |
| 23 | 3 · Bearing module (bench) | Cartridge tube | Cartridge tube (seamless 323.9 × 60, turned to Ø318, no welds) front end up on a stand. |
| 24 | 3 · Bearing module (bench) | Housing washer | 29328N housing washer dropped in from the front onto the shoulder 233 mm down (Ø204 left as rolled; SKF Da max 208). |
| 25 | 3 · Bearing module (bench) | Eye bolt | M30 eye bolt into the spindle nose. The same thread later pulls the head on and pushes it off. |
| 26 | 3 · Bearing module (bench) | Spindle into the tube | Spindle lowered rear end first into the tube. The rollers seat on the housing washer; the front 23228 outer ring slides into its Ø250 seat. |
| 27 | 3 · Bearing module (bench) | Turn the module over | Eye bolt out. Module turned front-down and stood on the nose; the weight goes tube → housing washer → rollers → collar → nose. |
| 28 | 3 · Bearing module (bench) | Spacer sleeve | Spacer sleeve slid over the rear end down to the shaft washer. |
| 29 | 3 · Bearing module (bench) | Rear 23228 | Rear 23228 heated to 110 °C, slid onto the shaft and into the rear seat together, pushing on the inner ring. This bearing floats axially in its seat. |
| 30 | 3 · Bearing module (bench) | MB28 + KM28 | Lock washer, then the KM28 nut tightened with a hook spanner; one washer tab bent into a nut slot. |
| 31 | 3 · Bearing module (bench) | Turn front-up | Module turned front-up again. |
| 32 | 3 · Bearing module (bench) | Seal carrier | Carrier with 3 lip seals 170 × 200 × 15 and 2 lantern rings slid over the nose on an assembly cone. Push and pull the shaft with a dial indicator on the nose; shim to 0.10–0.20 end play. 12 × M6 countersunk, flush. |
| 33 | 3 · Bearing module (bench) | O-ring and seal-purge line | Static O-ring rolled over the tube end into its groove (seals the ring 1 bore). The seal-purge line (Ø8) lies in a 14 × 9 groove milled along the tube OD from the port at x = 125 to x = 600, so nothing stands above Ø318 when the module passes through ring 1. Bearings are packed with grease here; no relube lines (12 rpm, ≈ 1,200 head revolutions per 5 m). |
| 34 | 3 · Bearing module (bench) | Split flange | Flange halves into the groove from both sides. |
| 35 | 3 · Bearing module (bench) | Split screws and pins | 2 × M8 across each split at x = 22.5, R157 (clear of the flange bolt holes). First build: ream 4 radial Ø12 holes through the flange into the tube land and drive the pins in from outside. |
| 36 | 4 · Module into the shell | Module into ring 1 | Eye bolt back in. Module (≈ 330 kg) lifted and lowered rear end first through ring 1's Ø318.5 bore until the split flange sits in the counterbore. Flange flush with the plate face. |
| 37 | 4 · Module into the shell | Bolt and dowel | 16 × M12 × 40 10.9 into ring 1 at 70 % proof (100 Nm). First assembly: ream 2 × Ø16 dowels through the flange into ring 1 at 12 and 6. Eye bolt out. |
| 38 | 5 · Cutterhead onto the spindle | Head onto the nose | Head lowered onto the nose. The Ø170 journal passes the lip seals on a thin assembly sleeve and stops on the front 23228 inner ring. |
| 39 | 5 · Cutterhead onto the spindle | Locking assembly | Locking assembly (140 × 190 × 50) slid into the gap between shaft and hub ring. Screws tightened in rounds to 123 Nm (B-LOC B400 catalogue). |
| 40 | 5 · Cutterhead onto the spindle | Centre cap | Cap with the inner bits into its pocket; 8 × M8 countersunk. Two M12 holes in the cap pull it out later. |
| 41 | 5 · Cutterhead onto the spindle | Cap screws | 8 × M8 countersunk. |
| 42 | 6 · Drive | Turn the machine rear-up | Riser blocks out. Machine turned rear end up and stood on a ring under the head. |
| 43 | 6 · Drive | Seal-purge supply, part 1 | Supply line connected to the end of the groove line at x = 600 (560 mm down from the open rear end) and run back at R209 to x = 1,095; the loose end is tied out of the way. |
| 44 | 6 · Drive | Adapter dowels | 3 × Ø16 dowels pressed into the cartridge rear face (holes reamed with the adapter on the bench, first build). |
| 45 | 6 · Drive | Drive adapter | Adapter weldment (flanges + 14 in XS pipe, machined after welding) lowered over the shaft end onto the dowels; Ø250 pilot into the cartridge bore. |
| 46 | 6 · Drive | Adapter screws | 12 × M16 10.9 put in through the two side windows and the open rear, tightened to 248 Nm. |
| 47 | 6 · Drive | Spindle-side coupling hub | ROTEX 160 steel hub (Ø290) lowered through the adapter's Ø300 rear bore onto the Ø130 shaft end. Its B-LOC B400 130 × 180 is tightened from above through the Ø190 spider bore, in rounds to 123 Nm. |
| 48 | 6 · Drive | Coupling spider | 64 ShD polyurethane spider dropped into the jaws. |
| 49 | 6 · Drive | Hydraulic motor | On the bench: pilot plate onto the motor spigot, ROTEX 160 motor hub onto the W90 spline. The motor (Poclain MS18, ≈ 152 kg) is lowered onto the adapter: the hub passes the Ø300 bore and its jaws engage the spider; the plate's Ø300 spigot enters the bore. |
| 50 | 6 · Drive | Motor screws | 8 × M20 × 65 10.9 through the motor flange and pilot plate into the adapter, tightened to 484 Nm. |
| 51 | 6 · Drive | Window guards | 3 mm curved guard plates over both adapter windows, 4 × M6 each (rules 3.a.1: rotating parts guarded). |
| 52 | 6 · Drive | Seal-purge supply, part 2 | Line continued from x = 1,095: down to R185 by x = 1,150, then back through the thrust-ring bore to the surface. |
| 53 | 6 · Drive | Hoses | Hoses A and B (3/4 in) and the case drain run back through the casing string to the HPU. |
| 54 | 6 · Drive | Back to horizontal | Machine laid horizontal on the launch cradle. |
| 55 | 7 · Thrust ring Rev B (launch) | Thrust ring onto the shield rear | Thrust ring Rev B (A572-50, 76.2 thk, Ø609.6 × Ø400, U-notches 84 wide to R287 at 12 and 6, Ø589.5 × 10 register spigot) with 4 saddles welded to its rear face at R260, 2, 4, 8 and 10 o'clock. Slid on from the rear over the hoses, the notches over the slurry pipes, until the spigot is in the shield's Ø590.6 × 12 rear counterbore (radial gap 0.55) and the bearing face sits on the shield end wall (x = 1,157). No jacking pipes yet; not bolted. |
| 56 | 7 · Thrust ring Rev B (launch) | Jacking cylinders | 4 × Chief WT 5 × 24 (bore 127, rod 63.5, stroke 609.6), retracted 889 pin to pin. Each rod-end cross tube (Ø63.5 × 101.6) goes between the ears into its Ø65 seat. Thrust path: rod → cross tube → seat → block → ring → shield. Barrel and gland lengths are approximate. |
| 57 | 7 · Thrust ring Rev B (launch) | Saddle pins | Ø38.1 × 160 4140 pins through the ears and cross tubes, 2 clips each. The ear holes are slotted 3 toward the ring, so the pins carry load only in retract (50 bar, 47.5 kN per cylinder). |

## 7.2 Fixtures

| Fixture | Use |
|---|---|
| Riser blocks, 3 × 60 × 60 × 110 | Shell stands on them rear end down while ring 1, the module and the head go in; the slurry pipes stand 98 proud of the rear end |
| Gauge legs, 3 × Ø30 × 1157 (tube, ground ends) | Stand on the table inside the shell at R255, 120° apart; set ring 1's front face 128.0 from the shield front end |
| M30 eye bolt (DIN 580) | In the spindle nose: lifts the spindle and the bearing module |
| Ring under the head | Machine stands on it rear up while the drive goes in |
| Launch cradle | Machine lies on it horizontal for the thrust ring and cylinders |

Collision check of the animation: `src/audit_asm.py` replays every motion against the model and flags any pair whose overlap mid-motion exceeds its finished-state overlap by more than 0.3 cm³ (result in chapter 08).

## 7.3 Lift plan

Rules 2.c: every lift needs the weight in pounds, a diagram of the set-up and marked rigging points; lifting points marked with their allowable force; FoS on lifting more than 5.

| Item | kg | lb | Rigging |
|---|---|---|---|
| Machine (shell + module + head + drive) | 1,206 | 2,658 | 4 hoist rings in the lifting bosses, 4-leg bridle, legs ≥ 60° from horizontal |
| Shell weldment | 457 | 1,008 | Same 4 bosses |
| Bearing module | 325 | 717 | M30 eye bolt (DIN 580) in the spindle nose, vertical |
| Cutterhead | 143 | 315 | Round slings around two opposite arms at the hub, or the M30 nose eye bolt once on the spindle |
| Motor | 152 | 335 | Motor lifting eye per the Poclain drawing |
| Thrust ring weldment | 119 | 262 | Round sling through the Ø400 bore, two legs |
| Cylinder (each) | 52.6 | 116 | By hand (two people) or a sling at the barrel |

Machine lift, horizontal:

| Item | Value |
|---|---|
| Lifting points | 4 bosses at x = 155 and 699, 12 o'clock ± 18° (188 apart across the top) |
| CG | x = 423, +5.5 above the axis: share of the rear pair 49.3 % |
| Per point, vertical | 306 kg (front), 297 kg (rear) |
| Bridle | 4 legs to one master link; legs ≥ 60° from horizontal: leg load = vertical share / sin 60° |
| Hoist rings | Crosby HR-125M M20 × 2.5 × 65 (stock 1016644), WLL 2,150 kg at 5:1, 136 Nm, rated in every direction |
| Marking | "LIFT 700 kg" at each boss (allowable per boss; checks LF-2b to LF-5) |
| Upending (horizontal → rear up) | On the two rear points with the head end on the ground, then fully on them: 603 kg per point |

| ID | Part | Check | Case | Value | Allowable (basis) | FoS | FoS yield | Required | Status |
|---|---|---|---|---|---|---|---|---|---|
| LF-1 | Lifting bosses | hoist ring load per point, 4-leg sling at 60° (machine horizontal) | lift | 353.0 kg | 2,150.0 (hoist-ring WLL) | 6.09 | – | 1.00 | ok |
| LF-2 | Lifting bosses | upending: whole machine on the two rear points (worst share) | lift | 602.8 kg | 2,150.0 (hoist-ring WLL) | 3.57 | – | 1.00 | ok |
| LF-2b | Lifting bosses | marked allowable per boss vs the worst lift (upending) | lift | 602.8 kg | 700.0 (marked allowable) | 1.16 | – | 1.00 | ok |
| LF-3 | Lifting bosses | M20 thread in the A572-50 boss (31.9 engaged): strip at the marked allowable | lift | 6.85 MPa | 270.0 (0.6 Fu) | 39.40 | 29.05 | 5.00 | ok |
| LF-4 | Lifting bosses | boss to shell, full-penetration groove weld (Ø60 × 12.7), marked allowable in shear | lift | 2.87 MPa | 96.4 (0.4 Fy (shell)) | 33.61 | 48.48 | 5.00 | ok |
| LF-5 | Lifting bosses | shell local bending around the boss, radial pull at the marked allowable (β ≈ 1.5) | lift | 63.9 MPa | 241.0 (Fy (shell)) | 3.77 | 3.77 | 3.00 | ok |
| LF-6 | Fixtures | M30 eye bolt (DIN 580) in the spindle nose: bearing module, vertical | lift | 325.2 kg | 3,200.0 (WLL) | 9.84 | – | 1.00 | ok |

Equations behind the rows:

- **LF-1 lift**: P = m_pt g / sin 60° = 306 kg × 9.81/0.866 = 3.46 kN = 353 kg-f; WLL 2150 kg (5:1) → **352.99 kg**. FoS on breaking load = 5 × 6.1
- **LF-2 lift**: P = m g/2 = 1206 × 9.81/2 = 5.91 kN = 603 kg-f → **602.75 kg**
- **LF-2b lift**: 700 kg marked vs 603 kg → **602.75 kg**
- **LF-3 lift**: τ = P/(0.5 π d L_e) = 6867/(0.5π × 20 × 31.9) → **6.85 MPa**
- **LF-4 lift**: τ = P/(π D t) = 6867/(π × 60 × 12.7) → **2.87 MPa**
- **LF-5 lift**: σ ≈ β P/t² = 1.5 × 6867/12.7²; FoS on ultimate = 414/64 = 6.5 → **63.86 MPa**. FoS on yield ≥ 3 and on ultimate ≥ 5 for the welded lifting attachment
- **LF-6 lift**: m = 325 kg; DIN 580 M30 WLL 3,200 kg (axial) → **325.20 kg**

## 7.4 Transport and handling (3 g)

The cantilevered module, head and drive hang off ring 1 at the seat. Their weight moment there is 3.05 kNm at 1 g, 9.1 kNm at 3 g:

```
M12 flange screw tension added at 3 g:  ΔF = 4M / (n D) = 4 × 9.1e6 / (16 × 354) = 6.5 kN   vs preload 49.0 kN
Weight shear at 3 g vs flange friction:  3 × 748 × 9.81 = 22.0 kN   vs 0.30 × 16 × 49.0 = 235 kN
Moment at 3 g vs the jam moment the joint is designed for: 9.1 vs 87.5 kNm
```
