Sam-Indyk/uatxcavators-tbm/docs/manual-08-review-open-items.md

# Design manual Rev I · 08 Review log and open items

UATXcavators DN600 slurry microTBM (micro tunnel boring machine). Revision I, 2026-10-28. Generated by `tools/make_manual.py` from the model and calculation scripts in the repo; edit those, not this file.

Units mm, N, MPa (kN, kNm in tables). x = 0 at the ring 1 front face, +x rearward. Clock positions are seen from the front, looking rearward: 0° = 12 o'clock, 90° = 3 o'clock.

Findings from the Rev H review, the evidence for each and how Rev I resolves it; then what is still open.

## 8.1 Findings and resolutions

| # | Finding | Evidence | Rev I resolution |
|---|---|---|---|
| F-1 | Ring 1: the wall between the Ø400 counterbore and the 12 / 6 o'clock pipe holes is 6.5 mm | FEA LC3, open holes: 461 MPa peak at the hole edge (A572 Gr 50 Fy 345). The Rev H hand model (stepped plate) cannot see it | I-1: counterbore Ø384 × 30, wall 14.5; pipes welded at both faces. LC3 Pm + Pb in the wall now within Fy/1.5 |
| F-2 | Ring 1 specified as A572 Gr 50 from 4.5 in plate | ASTM A572 Gr 50 plate is limited to 4 in | I-2: A572 Gr 42 (Fy 290) in every check |
| F-3 | Thrust ring Rev A covers both slurry pipe bores at launch | Pipes end flush at the shield rear (x = 1,157) inside the ring annulus R200-304.8 | I-3, I-4: pipes run through U-notches to x = 1,255 |
| F-4 | Seal-purge supply crosses the thrust ring annulus | Interference check tring/gsupply 5.98 cm³ | I-5: line jogs to R185 behind the motor; 0 cm³ |
| F-5 | Coupling unrated; modelled jaw geometry matched no catalogue size | Rev H 'size open'; modelled gap between hubs 45 vs ROTEX E 65-75 | I-6: ROTEX 160, catalogue dimensions; adapter bore Ø300 + pilot plate |
| F-6 | Rotating coupling exposed through the adapter windows | Rules 3.a.1 | I-7: bolted guards |
| F-7 | No lifting points | Rules 2.c, 3.b.1.1 (lifting FoS > 5, points marked) | I-8: 4 bosses with hoist rings; lift plan in chapter 07 |
| F-8 | Split-flange joint screw counterbores break into flange bolt holes | Rev H: M10 counterbore Ø17 at z = 172 vs bolt holes at 78.75° on Ø370 (z ≥ 174.7) | I-9: M8 at x = 22.5, z = ±157; 2.9 mm wall to the nearest hole |
| F-9 | Load cases not tied to the hydraulics; pump relief not checked; no side force | LC2 590 kN (screen) vs 613 kN at the 121 bar cap; 2,580 psi relief gives 901 kN | I-11: LC1-LC4 from F = 4 p A; side force F_s = 3T/(πR) |
| F-10 | Motor relief taken as operating + 20 bar | Rules 4.c.3.2: 10 % or 20 bar, whichever is higher | Relief 259 bar, stall 11.58 kNm |
| F-11 | Material strengths | E355 Fy 335 for a 60 mm wall (EN 10297-1); 14 in XS adapter pipe is A106 / A53 B (Fy 241) | I-12 |
| F-12 | Bit holder weld not specified; gauge holders overhang the arm end | One-bit jam at the stall torque: 39 kN at R296 | I-13: 14 mm fillets; gauge holder open |
| F-13 | Design record says the split-flange kerf is at 12 and 6 | Model splits at 3 and 9 (plane y = 0); dowels at 12 and 6 need whole halves there | Record corrected: 3 and 9 |
| F-14 | Rev H ring 1 FoS (1.51, web) quoted the wrong location | FEA web Pm + Pb ≈ 155 MPa at LC3 vs the pipe-hole wall ≈ 187 | Ring 1 judged on the FEA wall stress |
| F-15 | Pipes standing proud of the shell rear end | The shell stands on its rear end during fabrication | I-14: riser blocks; legs 1,157 |
| F-16 | One-piece splined drive sleeve (considered for Rev I) | Spindle tilt at LC3 gives 0.38 mm offset at the coupling; overhang stiffness 297 kN/mm | Rejected; flexible coupling kept |
| F-17 | Thrust ring FEA showed 300-336 MPa at the saddle seat edges | Uniform pressure on the half groove ends abruptly at its edges | Hertz-like seat pressure; block judged on linearized stress and Hertz contact |
| F-18 | Two versions of the thrust ring front end | Uncommitted Oct 27-28 edits in the local clone: register spigot, shield rear counterbore, pipes ending 5 inside the shield rear with Ø80 hoses through 86-wide notches; not in the repo that Rev I was built from | Saved on branch local-oct28-register; register and counterbore ported (I-15); Rev I pipe routing kept (pipes through the notches to x = 1,255) |

## 8.2 Verification done for Rev I

| Check | Result |
|---|---|
| Interference, every part pair of interest (`build_revI_detail.py --check`) | 148 pairs; non-zero only where intended: screw threads in tapped holes (adscrews/tube 14.14, mbolts/adapter 13.55, guard screws 0.61 cm³), eye bolt in the nose thread 10.56, pipe weld 0.03 |
| Hand checks (`calc_revI.py`) | 174 rows; 1 below requirement (chapter 00) |
| Ring 1 FEA | LC2, LC3, LC4 with the as-built pipe welds; option study in chapter 02 |
| Thrust ring FEA | Rev B, LC2-LC4, shield and casing supports, Hertz-like seat loads |
| Collision audit of the 57-step animation (`audit_asm.py`) | 0 collisions (threshold 0.3 cm³ above the finished-state overlap) |

## 8.3 Open items

1. Poclain certified drawing: flange pattern (8 × M20 on Ø335 assumed), pilot, shaft length (110 assumed), body. Sets the pilot plate, hub 2 length and the motor envelope.
2. Fenner: B-LOC B400 130 × 180 hub pressure (160 MPa assumed, scaled from the 140 row) for the hub 1 check (DR-10).
3. KTR: ROTEX 160 hubs shortened (hub 1 body 60 with Ø180 H7, 42CrMo4+QT; hub 2 jaw disc 30 + Ø140 neck with W90 × 3 × 28 spline). Confirm with KTR.
4. Koyo: C0, C and misalignment limits for 23228 and 29328N; 23228 quantity (front, rear, spare).
5. Ring 1 plate: mill certificate for 4.5 in A572 Gr 42 (Fy ≥ 290).
6. Shell pipe grade (API 5L B / A53 B assumed, Fy 241).
7. Cartridge tube: US source for seamless 323.9 × 60 (OD ≥ 320, ID ≤ 206).
8. Gauge bit holders (R308.65) overhang the arm end by 13.65 of 30: holder or arm-tip change with the cutterhead layout (CH-7).
9. Centre cap and inner bit layout (7 bits on the cap).
10. Slurry hose connection at the pipe ends (x = 1,255): fitting OD ≤ 95 to pass inside the jacking pipes later.
11. Casing joint drawing: confirm the register placeholders (spigot Ø589.5 × 10 × 9 wide, shield rear counterbore Ø590.6 × 12) and the casing wall (24 in × 0.375 assumed).
12. Soil c_u from the geotechnical report: fins give FoS 1.09 alone at c_u 25 kPa (FN-1).
13. Launch seal notches for the Ø750 fin envelope.
14. Overall length 1,451 vs the 1,340 envelope from Rev F: accept or change the motor arrangement.
15. Ring 1 FEA mesh refinement study on the pipe-hole wall (one more level, h 14 → 10).
