Sam-Indyk/uatxcavators-tbm/(commit log)

2026-10-27 Initial commit: Rev H spindle mount scripts, viewer and outputs
    CadQuery models, hand calcs, three.js assembly viewer, collision audit,
    design record (docs/) and rev B-G archive for the DN600 slurry microTBM.
    [spindle_mount.step, spindle_mount_motor_bell.step, spindle_mount_motor_plate.step, spindle_mount_optS.step, spindle_mount_optT.step, spindle_mount_revC.step, spindle_mount_revD.step, spindle_mount_revE.step]
2026-10-28 Add thrust ring Rev A at the shield rear (launch, no jacking pipes)
    Ring 76.2 thk Ø609.6 x Ø400 on the shield rear end (x = 1157 to 1233.2),
    4 saddles with ears and pins at R260 (2, 4, 8, 10 o'clock), saddle welds,
    and 4 x Chief WT 5 x 24 cylinder envelopes. Assembly phase 7 (steps 53-55),
    separate STEP out/step/thrust_ring_revA.step, viewer text, and the design
    record in docs/thrust-ring.md.
    Interference: all thrust-ring pairs 0 except tring/gsupply 5.98 cm3 (seal-purge
    supply line at R209 crosses the ring bore R200). Collision audit: 0 in 55 steps.
    STEP product names are now ASCII (Ø -> D, × -> x) so Fusion shows them cleanly.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
    [spindle_mount_revH_detail.step, thrust_ring_revA.step]
2026-10-28 Sync docs with the claude.ai project; add docs sync procedure
    - docs/spindle-mount.md: anti-roll fin thrust numbers from Thrust_Model; repo link
    - docs/mechanical-priorities.md: Oct 27 Rev H decisions (hydraulic drive, fins, weight check)
    - docs/thrust-ring.md: merged the claude.ai project text (pattern table, ear height) with
    the model and shield-rear interface sections from 1ca5ec1
    - CLAUDE.md: Docs sync section (project claude/*.md <-> docs/*.md); merged with 1ca5ec1
    - tools/docsync.py + docs/.sync.json: three-way hash check for the sync
    - .gitattributes: LF line endings for text files
    Claude-Session: https://claude.ai/code/sessio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
2026-10-29 Rev I model and scripts; UATXSync Fusion add-in
    Rev I = Rev H after a full review with FEA (design manual, FEA results and
    docs follow in the next commit).
    - Ring 1: A572 Gr 42 (Gr 50 plate stops at 4 in), Ø384 x 30 counterbore;
    slurry pipes A1085 Ø76.2 x 6.35 welded at both ring faces, run to x = 1,255.
    - Cartridge: split flange 30, M8 split screws, Ø12 anti-rotation pins.
    - Drive: KTR ROTEX 160 (64 ShD), adapter rear bore Ø300, motor pilot plate,
    window guards; lifting bosses for Crosby HR-125M hoist rings.
    - Seal-purge supply rerouted to R185 (crossed the thrust ring annulus).
    - Thrust ring Rev B: U-notches 84 wide to R287 for the slurry pipes, and the
    register from the Oct 27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
    [adapter.step, addowels.step, adscrews.step, adwelds.step, backing.step, blades.step, cap.step, capcarbide.step]
2026-10-29 UATXSync: track imported occurrences by name; no auto-retry after a failed apply
    Entity tokens are only available for proxies under the root component, so the
    STEP import into a group component failed on the first run. A failed apply
    now closes the half-built new design and waits for a new manifest or Sync now.
    Claude-Session: https://claude.ai/code/session_01KjX7hxeB4FsNhSoqLysPy8
2026-10-29 Rev I design manual, FEA results, hand checks and audit
    Design manual docs/manual-00 ... manual-09, generated by tools/make_manual.py:
    loads and criteria, every part with its equations, FEA, assembly and lift
    plan, review log (findings F-1 to F-18, changes I-1 to I-15), open items, BOM.
    - Hand checks: 174 (src/calc_revI.py -> out/calc/calc_revI.json); 1 below
    requirement: CH-7, gauge bit holder weld, FoS 0.70 (cutterhead layout).
    - Ring 1 FEA (face-welded pipes), LC3: pipe-hole wall Pm + Pb 187 MPa,
    FoS 1.55 on Fy 290.
    - Thrust ring Rev B FEA with the register (variant reg; contact R295.3-304.8),
    LC3 casing / shield: ring 87 / 89 MPa, notch zone 44 / 40, spigot root
    92 / 92 (Fy 345)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
2026-10-29 Manual BOM: thrust ring plate 3.5 in (86.2 overall with the spigot)
    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
2026-10-29 Viewer: Rev I FEA tab, Rev I column in Compare; no 3D rendering while hidden
    - FEA tab: design changes from the simulations, ring 1 and thrust ring Rev B
    panels for LC2-LC4 (viewer/fea/, copied from out/fea/docs/), results and
    design study tables, seat load model comparison.
    - Compare: Rev I column and review rows.
    - Assembly intro text follows the selected revision (step and phase count).
    - Render loop skips frames while Compare or FEA covers the 3D view.
    - Manual 06: Hertz half-width 5.6 mm (row TR-6), was 5.8.
    - shoot_viewer.py handles the compare and fea pages; CLAUDE.md notes.
    Claude-Session: https://claude.ai/code/session_01K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
    [make_manual.py, shoot_viewer.py]
